tomwym/oreo_mpc/stl/readme.txt

STL files have been simplified using meshlab
    - Using Quadric Edge Collapse Decimation
    - Settings:
        - Auto-generated target number of faces
        - Percent Reduction = 0
        - Quality Threshold = 0.3
        - Preserve Boundary of Mesh = enabled
        - Boundary Preserving Weight = 1.0
        - Preserve Normal = enabled
        - Preserve Topology = enabled
        - Optimal Position of Simplified Vertices = enabled
        - Planar simplification = disabled
        - Weighted simplification = disabled
        - Post-simplification cleaning = enabled
