tomwym/oreo_mpc/model/UW_BOM.xlsx

Sheet: Eye_Sub_ASM
PN | Description | Supplier | Material | Est. Cost (USD) 1 | Est. Cost (USD) 5 | Est. Cost (USD) 10 | QTY. / Package | QTY. Req'd | Order QTY. | Part Cost | CAD File name | Link
XXX | Lens Assembly | B-CON | Assembly | 0 | N/A | N/A | 1 | 1 | 1 | 0 | N/A | N/A
4262T5 | Ultra-Precision Mini Stainless Steel Ball Bearing - ABEC-7, Flanged Double Shielded for 3/32" Shaft Diameter, 5/16" OD | McMaster-Carr | 440C Stainless Steel | 12.76 | N/A | N/A | 1 | 3 | 3 | 38.28 | 4262T500.SLDPRT | http://www.mcmaster.com/#catalog/121/1183/=10p1i0g
90318A101 | Ultra Low Profile Type 316 Stainless Steel Shoulder Screw, Socket Drive, 3/32" Diameter X1/8" Long Shoulder, 2-56 Thread | McMaster-Carr | 316 Stainless Steel | 4.26 | 3.63 | N/A | 1 | 3 | 3 | 12.78 | 90318A101.SLDPRT | http://www.mcmaster.com/#90318a101/=10p1ko5
91294A002 | Class 10.9, M2 Size, 4mm Length, .4mm Pitch, Black Alloy Steel Flat-Head Socket Cap Screw | McMaster-Carr | Black-Oxide | 6.42 | N/A | N/A | 25 | 4 | 1 | 6.42 | 91294A002.SLDPRT | http://www.mcmaster.com/#91294a002/=10p1pz1
91239A758 | Class 10.9 Steel Button-Head Socket Cap Screw, M2.5 Size, 12 mm Length, .45 mm Pitch | McMaster-Carr | Black Oxide | 10.5 | N/A | N/A | 25 | 2 | 1 | 10.5 | 91239A758.SLDPRT | http://www.mcmaster.com/#91239a758/=10p1rd7
91255A075 | Alloy Steel Button-Head Socket Cap Screw, Black-Oxide, 2-56 Thread, 1/16" Long | McMaster-Carr | Black Oxide | 7.25 | N/A | N/A | 25 | 1 | 1 | 7.25 | 91255A075.SLDPRT | http://www.mcmaster.com/#91255a075/=10p1seu
9712K510 | High-Carbon Steel Belleville Disc Spring, .093" ID, .187" OD, .007" Thick | McMaster-Carr | High Carbon Steel | 12.03 | N/A | N/A | 12 | 1 | 1 | 12.03 | 9712K510.SLDPRT | http://www.mcmaster.com/#9712k51/=10p1tbr
99040A210 | Stainless Steel Shim for Shafts, 0.010" Thick, 0.093" ID, 0.203" OD | McMaster-Carr | 18-8 Stainless Steel | 11.29 | N/A | N/A | 25 | 2 | 1 | 11.29 | 99040A210.SLDPRT | http://www.mcmaster.com/#99040a210/=10p1zgw
91239A115 | Class 10.9 Steel Button-Head Socket Cap Screw, M3 Size, 10 mm Length, .5 mm Pitch | McMaster-Carr | Black Oxide | 6.88 | N/A | N/A | 100 | 2 | 1 | 6.88 | 91239A115.SLDPRT | http://www.mcmaster.com/#91239a115/=111uhff
FL3-U3-13S2M-CS | Camera, Flea3 | Point Grey | Assembly | 525 | N/A | N/A | 1 | 0 | 0 | 0 | FL2-006-R0.SLDPRT | https://www.ptgrey.com/flea3-13-mp-mono-usb3-vision-sony-imx035-camera
cam_mount_Al | Camera Mount Aluminum | ProtoLabs | 6061-T6 Aluminum | 468.14 | N/A | N/A | 1 | 0 | 0 | 0 | cam_mount.STEP | https://myaccount.protolabs.com
yoke_Al | Yoke Aluminum | ProtoLabs | 6061-T6 Aluminum | 1293.12 | N/A | N/A | 1 | 0 | 0 | 0 | yoke.STEP | https://myaccount.protolabs.com
cam_mount_SS | Camera Mount Stainless | Shapeways | Printed Stainless Steel | 48.14 | N/A | N/A | 1 | 0 | 0 | 0 | cam_mount.STL | https://www.shapeways.com
cam_mount_Ny | Camera Mount Plastic | Shapeways | Strong and Flexible Black | 13.46 | N/A | N/A | 1 | 0 | 0 | 0 | cam_mount.STL | https://www.shapeways.com
yoke_SS | Yoke Stainless | Shapeways | Printed Stainless Steel | 48.87 | N/A | N/A | 1 | 0 | 0 | 0 | yoke.STL | https://www.shapeways.com
yoke_Ny | Yoke Plastic | Shapeways | Strong and Flexible Black | 9.76 | N/A | N/A | 1 | 0 | 0 | 0 | yoke.STL | https://www.shapeways.com
EM2-1-5000-I | Encoder | US Digital | Plastic | 58.1 | 40.1 | 35.71 | 1 | 1 | 1 | 58.1 | EM1-X-X.SLDPRT | http://www.usdigital.com/products/encoders/incremental/modules/EM2
DISK-1-5000-093-IE | Encoder Disk | US Digital | Mylar | 13.63 | 9.42 | 8.11 | 1 | 2 | 2 | 27.26 | encoder_disk.SLDPRT | http://www.usdigital.com/products/encoders/incremental/rotary/disks/DISK-1
TOTAL |  |  |  |  |  |  |  |  |  | 190.79

Sheet: Frame_Sub_ASM
PN | Description | Supplier | Material | Est. Cost (USD) 1 | Est. Cost (USD) 5 | Est. Cost (USD) 10 | QTY. / Package | QTY. Req'd | Order QTY. | Part Cost | CAD File name | Link
B75AECFD27A3 | Motor | Maxon | Assembly | 318 | N/A | N/A | 1 | 1 | 1 | 318 | maxon_PN_B75AECFD27A3.sldasm | http://www.maxonmotorusa.com/maxon/view/configurator/?ConfigID=B75AECFD27A3
4262T5 | Ultra-Precision Mini Stainless Steel Ball Bearing - ABEC-7, Flanged Double Shielded for 3/32" Shaft Diameter, 5/16" OD | McMaster-Carr | 440C Stainless Steel | 12.76 | N/A | N/A | 1 | 4 | 4 | 51.04 | 4262T500.SLDPRT | http://www.mcmaster.com/#catalog/121/1183/=10p1i0g
90318A102 | Ultra Low Profile Type 316 Stainless Steel Shoulder Screw, Socket Drive, 3/32" Diameter X1/4" Long Shoulder, 2-56 Thread | McMaster-Carr | 316 Stainless Steel | 4.29 | 3.66 | N/A | 1 | 6 | 6 | 25.74 | 90318A102.SLDPRT | http://www.mcmaster.com/#90318a102/=10p2m1d
99040A210 | Stainless Steel Shim for Shafts, 0.010" Thick, 0.093" ID, 0.203" OD | McMaster-Carr | 18-8 Stainless Steel | 11.29 | N/A | N/A | 25 | 10 | 1 | 11.29 | 99040A210.SLDPRT | http://www.mcmaster.com/#99040a210/=10p1zgw
91239A758 | Class 10.9 Steel Button-Head Socket Cap Screw, M2.5 Size, 12 mm Length, .45 mm Pitch | McMaster-Carr | Black Oxide | 10.5 | N/A | N/A | 25 | 6 | 1 | 10.5 | 91239A758.SLDPRT | http://www.mcmaster.com/#91239a758/=10p1rd7
3088A119 | Steel Shim, Round, 0.001" Thick, 1/4" ID, 3/8" OD | McMaster-Carr | Steel | 5.22 | N/A | N/A | 10 | 4 | 1 | 5.22 | N/A | http://www.mcmaster.com/#3088a119/=10p39ua
3088A229 | Steel Shim, Round, 0.005" Thick, 1/4" ID, 3/8" OD | McMaster-Carr | Steel | 3.66 | N/A | N/A | 10 | 1 | 1 | 3.66 | N/A | http://www.mcmaster.com/#3088a229/=10p394m
4262T36 | Premium Flanged Ball Bearing, Double Shielded, Trade No.FR188-2Z | McMaster-Carr | 440C Stainless Steel | 10.47 | N/A | N/A | 1 | 3 | 3 | 31.41 | 4262T36.SLDPRT | http://www.mcmaster.com/#4262t36/=113ctkg
90337A197 | Low Profile 18-8 Stainless Steel Shoulder Screw, Socket Drive, 1/4" Diameter X5/8" Long Shoulder, 10-32 Thread | McMaster-Carr | 18-8 Stainless | 10.47 | 8.88 | N/A | 1 | 3 | 3 | 31.41 | 90337A197.SLDPRT | http://www.mcmaster.com/#90337a197/=10p3d4d
91294A005 | Black Alloy Steel Flat-Head Socket Cap Screw, Class 10.9, M2 Size, 8mm Length, .4mm Pitch | McMaster-Carr | Black Oxide | 6.45 | N/A | N/A | 25 | 30 | 2 | 12.9 | 91294A005.SLDPRT | http://www.mcmaster.com/#91294a005/=10p4dr9
91294A006 | Black Alloy Steel Flat-Head Socket Cap Screw, Class 10.9, M2 Size, 10mm Length, .4mm Pitch | McMaster-Carr | Black Oxide | 6.65 | N/A | N/A | 25 | 3 | 1 | 6.65 | 91294A006.SLDPRT | http://www.mcmaster.com/#91294a006/=10p4368
93657A005 | Metric Nylon Unthreaded Spacer 6mm OD, 4mm Length, M3 Screw Size | McMaster-Carr | Nylon | 1.06 | N/A | 0.89 | 1 | 8 | 8 | 8.48 | 93657A005.SLDPRT | http://www.mcmaster.com/#93657a005/=10qlcg0
91294A132 | Black Alloy Steel Flat-Head Socket Cap Screw, Class 10.9, M3 Size, 12mm Length, .50 Pitch | McMaster-Carr | Black Oxide | 5.38 | N/A | N/A | 100 | 4 | 1 | 5.38 | 91294A132.SLDPRT | http://www.mcmaster.com/#91294a132/=111u497
91292A265 | Type 18-8 Stainless Steel Socket Head Cap Screw, M1.6 Thread, 10mm Long, 0.35mm Pitch | McMaster-Carr | 18-8 Stainless | 9.78 | N/A | N/A | 50 | 16 | 1 | 9.78 | 91292A265.SLDPRT | http://www.mcmaster.com/#91292a265/=111u6c4
91239A115 | lass 10.9 Steel Button-Head Socket Cap Screw, M3 Size, 10 mm Length, .5 mm Pitc | McMaster-Carr | Black Oxide | 6.88 | N/A | N/A | 100 | 4 | 1 | 6.88 | 91239A115.SLDPRT | http://www.mcmaster.com/#91239a115/=111uhff
95893A550 | Thread-Forming Torx Screw for Plastics, Flat Head, 18-8 Stainless Steel, 2-28 Thread, 1/4" Length | McMaster-Carr | 18-8 Stainless | 12.24 | N/A | N/A | 50 | 30 | 1 | 12.24 | 95893A550.SLDPRT | http://www.mcmaster.com/#95893a550/=111u4qr
LM 1247–060–11 | Linear Actuator | MicroMo | Assembly | 539.3 | N/A | N/A | 1 | 6 | 6 | 3235.8 | LM1247-060-XX.SLDASM | http://www.micromo.com/products/linear-motors/quickshaft-data-sheets
Motor Mount Inside_AL | Motor Mount Inside | protolabs | 6061-T6 Aluminum | 291.5 | N/A | N/A | 1 | 0 | 0 | 0 | motor_mount_inside.STEP | https://myaccount.protolabs.com
Yaw Bottom Bearing Mount_AL | Yaw Bottom Bearing Mount | protolabs | 6061-T6 Aluminum | 187.81 | N/A | N/A | 1 | 0 | 0 | 0 | yaw_bearing_mount_bottom.STEP | https://myaccount.protolabs.com
Yaw Top Bearing Mount_AL | Yaw Top Bearing Mount | protolabs | 6061-T6 Aluminum | 175.12 | N/A | N/A | 1 | 0 | 0 | 0 | yaw_bearing_mount_top.STEP | https://myaccount.protolabs.com
Roll Motor Mount_AL | Roll Motor Mount | protolabs | 6061-T6 Aluminum | 189.09 | N/A | N/A | 1 | 0 | 0 | 0 | roll_motor_mount.STEP | https://myaccount.protolabs.com
Roll Bearing Mount_AL | Roll Bearing Mount | protolabs | 6061-T6 Aluminum | 429.5 | N/A | N/A | 1 | 0 | 0 | 0 | roll_bearing_mount.STEP | https://myaccount.protolabs.com
frame_plate_side_l | frame_plate_side_l | ProtoLabs | 7075-T651 Aluminum | 150.04 | 123.13 | 111.41 | 1 | 1 | 1 | 150.04 | frame_plate_side_l.STEP | https://myaccount.protolabs.com
frame_plate_side_r | frame_plate_side_r | ProtoLabs | 7075-T651 Aluminum | 150.04 | 123.13 | 111.41 | 1 | 1 | 1 | 150.04 | frame_plate_side_r.STEP | https://myaccount.protolabs.com
frame_plate_top | frame_plate_top | ProtoLabs | 7075-T651 Aluminum | 160.02 | 133.1 | 121.38 | 1 | 1 | 1 | 160.02 | frame_plate_top.STEP | https://myaccount.protolabs.com
Motor Mount Inside_SS | Motor Mount Inside | Shapeways | Printed Stainless Steel | 51.92 | N/A | N/A | 1 | 0 | 0 | 0 | motor_mount_inside.STL | https://www.shapeways.com
Motor Mount Inside_NY | Motor Mount Inside | Shapeways | Strong and Flexible Black | 8.88 | N/A | N/A | 1 | 0 | 0 | 0 | motor_mount_inside.STL | https://www.shapeways.com
Yaw Bottom Bearing Mount_SS | Yaw Bottom Bearing Mount | Shapeways | Printed Stainless Steel | 73.84 | N/A | N/A | 1 | 0 | 0 | 0 | yaw_bearing_mount_bottom.STL | https://www.shapeways.com
Yaw Bottom Bearing Mount_NY | Yaw Bottom Bearing Mount | Shapeways | Strong and Flexible Black | 11.06 | N/A | N/A | 1 | 0 | 0 | 0 | yaw_bearing_mount_bottom.STL | https://www.shapeways.com
Yaw Top Bearing Mount_SS | Yaw Top Bearing Mount | Shapeways | Printed Stainless Steel | 87.83 | N/A | N/A | 1 | 0 | 0 | 0 | yaw_bearing_mount_top.STL | https://www.shapeways.com
Yaw Top Bearing Mount_NY | Yaw Top Bearing Mount | Shapeways | Strong and Flexible Black | 13.25 | N/A | N/A | 1 | 0 | 0 | 0 | yaw_bearing_mount_top.STL | https://www.shapeways.com
Roll Motor Mount_SS | Roll Motor Mount | Shapeways | Printed Stainless Steel | 89.08 | N/A | N/A | 1 | 0 | 0 | 0 | roll_motor_mount.STL | https://www.shapeways.com
Roll Motor Mount_NY | Roll Motor Mount | Shapeways | Strong and Flexible Black | 13.66 | N/A | N/A | 1 | 0 | 0 | 0 | roll_motor_mount.STL | https://www.shapeways.com
Roll Bearing Mount_SS | Roll Bearing Mount | Shapeways | Printed Stainless Steel | 123.93 | N/A | N/A | 1 | 0 | 0 | 0 | roll_bearing_mount.STL | https://www.shapeways.com
Roll Bearing Mount_NY | Roll Bearing Mount | Shapeways | Strong and Flexible Black | 17.39 | N/A | N/A | 1 | 0 | 0 | 0 | roll_bearing_mount.STL | https://www.shapeways.com
Dogbone Link_NY | Dogbone Link | Shapeways | Strong and Flexible Black | 3.37 | N/A | N/A | 1 | 0 | 0 | 0 | dogbone_link.STL | https://www.shapeways.com
Dogbone Link_SS | Dogbone Link | Shapeways | Stainless Steel | 11.16 | N/A | N/A | 1 | 0 | 0 | 0 | dogbone_link.STL | https://www.shapeways.com
LM1247 Spacer_NY | LM1247 Spacer | Shapeways | Strong and Flexible Black | 5.86 | N/A | N/A | 1 | 0 | 0 | 0 | lm1247_spacer.STL | https://www.shapeways.com
LM1247 Spacer_SS | LM1247 Spacer | Shapeways | Stainless Steel | 25.9 | N/A | N/A | 1 | 0 | 0 | 0 | lm1247_spacer.STL | https://www.shapeways.com
P028.002.E894 | iPOS360x SX Multi-axis Motion System | Technosoft Motion | iPOS360x MBX-NET | 200 | ~ |  | 1 | 1 | 1 | 200 | iPOS360xMulti.SLDPRT | http://www.technosoftmotion.com/en/intelligent-drives-and-motors/ipos-line/ipos-multi-axis/ipos360x-sx
P028.001.E001 | iPOS3602 VX Intelligent Drive (75 W, CANopen / EtherCAT) | Technosoft Motion | iPOS3602 VX-CAN | 300 | ~ |  | 1 | 6 | 6 | 1800 | iPOS360xMulti.SLDPRT | http://www.technosoftmotion.com/en/intelligent-drives-and-motors/ipos-line/ipos3602/ipos3602-vx
P038.022.E001 | Ethernet-CAN Adapter | Technosoft Motion | ENET-VX Ethernet plug-in interface | 75 | not sure of this price |  | 1 | 1 | 1 | 75 | iPOS360xMulti.SLDPRT | http://www.technosoftmotion.com/en/starter-kits-and-accessories/ethernet-can-adapter#description
EM2-1-5000-I | Encoder | US Digital | Mylar | 58.1 | 40.1 | 35.71 | 1 | 3 | 3 | 174.3 | EM1-X-X.SLDPRT | http://www.usdigital.com/products/encoders/incremental/modules/EM2
DISK-1-5000-093-IE | Encoder Disk | US Digital | Mylar | 13.63 | 9.42 | 8.11 | 1 | 2 | 2 | 27.26 | encoder_disk.SLDPRT | http://www.usdigital.com/products/encoders/incremental/rotary/disks/DISK-1
HUBDISK-1-5000-250-IE | Encoder Disk, 5000 CPR, Index, 1/4" Hub | US Digital | Mylar | 20.53 | 14.16 | 10.81 | 1 | 1 | 1 | 20.53 | HUBDISK-1-5000-250-IE.SLDPRT | http://www.usdigital.com/products/encoders/incremental/rotary/disks/HUBDISK-1
TOTAL |  |  |  |  |  |  |  |  |  | 6543.57

Sheet: Neck_Sub_ASM
PN | Description | Supplier | Material | Est. Cost (USD) 1 | Est. Cost (USD) 5 | Est. Cost (USD) 10 | QTY. / Package | QTY. Req'd | Order QTY. | Part Cost | CAD File name | Link
B75AECFD27A3 | Motor | Maxon | Assembly | 318 | N/A | N/A | 1 | 2 | 2 | 636 | maxon_PN_B75AECFD27A3.sldasm | http://www.maxonmotorusa.com/maxon/view/configurator/?ConfigID=B75AECFD27A3
91239A758 | Class 10.9 Steel Button-Head Socket Cap Screw, M2.5 Size, 12 mm Length, .45 mm Pitch | McMaster-Carr | Black Oxide | 10.5 | N/A | N/A | 25 | 10 | 1 | 10.5 | 91239A758.SLDPRT | http://www.mcmaster.com/#91239a758/=10p1rd7
4262T36 | Premium Flanged Ball Bearing, Double Shielded, Trade No.FR188-2Z | McMaster-Carr | 440C Stainless Steel | 10.47 | N/A | N/A | 1 | 3 | 3 | 31.41 | 4262T36.SLDPRT | http://www.mcmaster.com/#4262t36/=113ctkg
90337A197 | Low Profile 18-8 Stainless Steel Shoulder Screw, Socket Drive, 1/4" Diameter X5/8" Long Shoulder, 10-32 Thread | McMaster-Carr | 18-8 Stainless | 10.47 | 8.88 | N/A | 1 | 2 | 2 | 20.94 | 90337A197.SLDPRT | http://www.mcmaster.com/#90337a197/=10p3d4d
9520T270 | Two-Piece Clamp-on Shaft Collar for 3 mm Diameter, Aluminum | McMaster-Carr | Aluminum | 7.71 | N/A | N/A | 1 | 1 | 1 | 7.71 | 9520T270.SLDPRT | http://www.mcmaster.com/#9520t27/=10p5h4m
91385A201 | Thread-Locking Cup Point Set Screw, Alloy Steel, M2 Size, 3mm Long, 0.4mm Pitch | McMaster-Carr | Black Oxide | 12.23 | N/A | N/A | 10 | 2 | 1 | 12.23 | 91385A201.SLDPRT | http://www.mcmaster.com/#91385a201/=10p5ipp
91294A003 | Black Alloy Steel Flat-Head Socket Cap Screw, Class 10.9, M2 Size, 5mm Length, .4mm Pitch | McMaster-Carr | Black Oxide | 6.24 | N/A | N/A | 25 | 12 | 1 | 6.24 | 91294A003.SLDPRT | http://www.mcmaster.com/#91294a003/=10p5k73
6680K11 | Dual-Load Angular-Contact Steel Ball Bearing, Open, 10mm Shaft Diameter, 30mm Outside Diamete | McMaster-Carr | 52100 Steel | 30.09 | N/A | N/A | 1 | 2 | 2 | 60.18 | 6680K110.SLDPRT | http://www.mcmaster.com/#6680k11/=10qk24x
3088A124 | Steel Shim Round, 0.001" Thick, 3/4" ID, 1-1/8" OD | McMaster-Carr | 1008-1010 Steel | 6.36 | N/A | N/A | 10 | 1 | 1 | 6.36 | 3088A124.SLDPRT | http://www.mcmaster.com/#3088a124/=10qk6ci
94805A217 | 3/8"-24 Thread Size, 9/16" Wide, 7/32" High, Thin Hex Nut | McMaster-Carr | 316 Stainless Steel | 7.62 | N/A | N/A | 25 | 1 | 1 | 7.62 | 94805A217.SLDPRT | http://www.mcmaster.com/#94805a217/=10qk7p0
97648A420 | Press-in Nut for Sheet Metal M4 X 0.7 Thread Size | McMaster-Carr | 18-8 Stainless | 8.15 | N/A | N/A | 10 | 4 | 1 | 8.15 | 97648A420.SLDPRT | http://www.mcmaster.com/#97648a420/=10qlboa
93657A005 | Metric Nylon Unthreaded Spacer 6mm OD, 4mm Length, M3 Screw Size | McMaster-Carr | Nylon | 1.06 | N/A | 0.89 | 1 | 4 | 4 | 4.24 | 93657A005.SLDPRT | http://www.mcmaster.com/#93657a005/=10qlcg0
91239A144 | Class 10.9 STL Button-Head Socket Cap Screw M4 Size, 10 mm Length, .7 mm Pitch | McMaster-Carr | Black Oxide | 9.47 | N/A | N/A | 100 | 11 | 1 | 9.47 | 91239A144.SLDPRT | http://www.mcmaster.com/#91239a144/=10qld2f
94150A325 | Type 316 Stainless Steel Hex Nut M3X0.5 Thread Size, 5.5mm Wide, 2.4mm High | McMaster-Carr | 316 Stainless Steel | 3.08 | N/A | N/A | 50 | 4 | 1 | 3.08 | 94150A325.SLDPRT | http://www.mcmaster.com/#94150a325/=10qle1w
91294A134 | Flat-Head Socket Cap Screw Class 10.9, M3 Size, 16mm Length, .50mm Pitch | McMaster-Carr | Black Oxide | 7.95 | N/A | N/A | 100 | 4 | 1 | 7.95 | 91294A134.SLDPRT | http://www.mcmaster.com/#91294a134/=10qleyx
motor_mount_AL | motor_mount | protolabs | 6061-T6 Aluminum | 212.21 | N/A | N/A | 1 | 0 | 0 | 0 | motor_mount.STEP | https://myaccount.protolabs.com
pitch_body_AL | pitch_body | protolabs | 6061-T6 Aluminum | 270.15 | N/A | N/A | 1 | 0 | 0 | 0 | pitch_body.STEP | https://myaccount.protolabs.com
pitch_stop_AL | pitch_stop | protolabs | 6061-T6 Aluminum | 88.96 | N/A | N/A | 1 | 0 | 0 | 0 | pitch_stop.STEP | https://myaccount.protolabs.com
yaw_link_AL | yaw_link | protolabs | 6061-T6 Aluminum | 692.82 | N/A | N/A | 1 | 0 | 0 | 0 | yaw_link.STEP | https://myaccount.protolabs.com
yaw_shaft_AL | yaw_shaft | protolabs | 7075 Aluminum | 105.46 | N/A | N/A | 1 | 0 | 0 | 0 | yaw_shaft.STEP | https://myaccount.protolabs.com
motor_mount_SS |  | Shapeways | Printed Stainless Steel | 181.52 | N/A | N/A | 1 | 0 | 0 | 0 | motor_mount.STL | https://www.shapeways.com
motor_mount_NY |  | Shapeways | Strong and Flexible Black | 25.8 | N/A | N/A | 1 | 0 | 0 | 0 | motor_mount.STL | https://www.shapeways.com
pitch_body_SS |  | Shapeways | Printed Stainless Steel | 72.99 | N/A | N/A | 1 | 0 | 0 | 0 | pitch_body.STL | https://www.shapeways.com
pitch_body_NY |  | Shapeways | Strong and Flexible Black | 13.54 | N/A | N/A | 1 | 0 | 0 | 0 | pitch_body.STL | https://www.shapeways.com
pitch_stop_SS |  | Shapeways | Printed Stainless Steel | 12.88 | N/A | N/A | 1 | 0 | 0 | 0 | pitch_stop.STL | https://www.shapeways.com
pitch_stop_NY |  | Shapeways | Strong and Flexible Black | 3.41 | N/A | N/A | 1 | 0 | 0 | 0 | pitch_stop.STL | https://www.shapeways.com
yaw_link_SS |  | Shapeways | Printed Stainless Steel | 210.86 | N/A | N/A | 1 | 0 | 0 | 0 | yaw_link.STL | https://www.shapeways.com
yaw_link_NY |  | Shapeways | Strong and Flexible Black | 26.37 | N/A | N/A | 1 | 0 | 0 | 0 | yaw_link.STL | https://www.shapeways.com
yaw_shaft_SS |  | Shapeways | Printed Stainless Steel | 31.72 | N/A | N/A | 1 | 0 | 0 | 0 | yaw_shaft.STL | https://www.shapeways.com
yaw_shaft_NY |  | Shapeways | Strong and Flexible Black | 5.85 | N/A | N/A | 1 | 0 | 0 | 0 | yaw_shaft.STL | https://www.shapeways.com
P028.002.E894 | iPOS360x SX Multi-axis Motion System | Technosoft Motion | iPOS360x MBX-NET rev C | 200 | ~ |  | 1 | 1 | 1 | 200 | iPOS360xMulti.SLDPRT | http://www.technosoftmotion.com/en/intelligent-drives-and-motors/ipos-line/ipos-multi-axis/ipos360x-sx
P028.001.E001 | iPOS3602 VX Intelligent Drive (75 W, CANopen / EtherCAT) | Technosoft Motion | iPOS3602 VX-CAN | 300 | ~ |  | 1 | 3 | 3 | 900 | iPOS360xMulti.SLDPRT | http://www.technosoftmotion.com/en/intelligent-drives-and-motors/ipos-line/ipos3602/ipos3602-vx
P038.022.E001 | Ethernet-CAN Adapter | Technosoft Motion | ENET-VX Ethernet plug-in interface | 75 | not sure of this price |  | 1 | 1 | 1 | 75 | iPOS360xMulti.SLDPRT | http://www.technosoftmotion.com/en/starter-kits-and-accessories/ethernet-can-adapter#description
EM2-1-5000-I | Encoder | US Digital | Mylar | 58.1 | 40.1 | 35.71 | 1 | 3 | 3 | 174.3 | EM1-X-X.SLDPRT | http://www.usdigital.com/products/encoders/incremental/modules/EM2
HUBDISK-1-5000-250-IE | Encoder Disk, 5000 CPR, Index, 1/4" Hub | US Digital | Mylar | 20.53 | 14.16 | 10.81 | 1 | 2 | 2 | 41.06 | HUBDISK-1-5000-250-IE.SLDPRT | http://www.usdigital.com/products/encoders/incremental/rotary/disks/HUBDISK-1
HUBDISK-1-5000-313-IE | Encoder Disk, 5000 CPR, Index, 5/16" Hub | US Digital | Mylar | 20.53 | 14.16 | 10.81 | 1 | 1 | 1 | 20.53 | HUBDISK-1-5000-313-IE.SLDPRT | http://www.usdigital.com/products/encoders/incremental/rotary/disks/DISK-1
TOTAL |  |  |  |  |  |  |  |  |  | 2242.97
Parts to add
Neck Base
Vesa Mount

Sheet: Dogbone_ASM
PN | Description | Supplier | Material | Est. Cost (USD) 1 | Est. Cost (USD) 5 | Est. Cost (USD) 10 | QTY. / Package | QTY. Req'd | Order QTY. | Part Cost | CAD File name | Link
017000318-0 | Ball Joint Spacers | Hobby King | Brass | 0.8 | N/A | N/A | 10 | 16 | 2 | 1.6 | N/A | http://www.hobbyking.com/hobbyking/store/__43259__Ball_Joint_Spacers_2mm_10pc.html
OR023-00501 | Ball and roller link 4.8x2x18mm (10pcs/set) | Hobby King | Brass | 3.82 | N/A | N/A | 10 | 8 | 1 | 3.82 | N/A | http://www.hobbyking.com/hobbyking/store/__8855__Ball_and_roller_link_4_8x2x18mm_10pcs_set_.html
T1330A | Curved Ball Link Pliers 5mm | Hobby King | Tool | 6.9 | N/A | N/A | 1 | 1 | 1 | 6.9 | N/A | http://www.hobbyking.com/hobbyking/store/__9801__Curved_Ball_Link_Pliers_5mm.html
450000351-0 | M2x45mm Stainless Steel Push Rods (LH & RH Threaded) (10pcs) | Hobby King | Stainless Steel | 3.36 | N/A | N/A | 10 | 4 | 1 | 3.36 | N/A | http://www.hobbyking.com/hobbyking/store/__61886__M2x45mm_Stainless_Steel_Push_Rods_LH_RH_Threaded_10pcs_.html
450000352-0 | M2x55mm Stainless Steel Push Rods (LH & RH Threaded) (10pcs) | Hobby King | Stainless Steel | 3.99 | N/A | N/A | 10 | 4 | 1 | 3.99 | N/A | http://www.hobbyking.com/hobbyking/store/__61887__M2x55mm_Stainless_Steel_Push_Rods_LH_RH_Threaded_10pcs_.html
RJX23 | M3 Steel Linkage Ball for all helis (10pcs) | Hobby King | Steel | 3.49 | N/A | N/A | 10 | 8 | 1 | 3.49 | N/A | http://www.hobbyking.com/hobbyking/store/__12301__M3_Steel_Linkage_Ball_for_all_helis_10pcs_.html
388000043 | 4.8mm x 15mm Ball End | Hobby King | Plastic | 1.93 | N/A | N/A | 10 | 4 | 1 | 1.93 | N/A | http://www.hobbyking.com/hobbyking/store/__26699__4_8mm_x_15mm_Ball_End_Turnigy_TD10_4WD_Touring_Car_10pc_.html
V2_5090-1612 | TZ-V2 .50 & .90 Size Ball Link | Hobby King | Plastic | 2.32 | N/A | N/A | 10 | 4 | 1 | 2.32 | N/A | http://www.hobbyking.com/hobbyking/store/__10524__TZ_V2_50_90_Size_Ball_Link.html
17000198-0 | M3 x 45mm Steel Push Rod (10pc) | Hobby King | Steel | 2.91 | N/A | N/A | 10 | 4 | 1 | 2.91 | N/A | http://www.hobbyking.com/hobbyking/store/RC_PRODUCT_SEARCH.asp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
E4005 | E4005 Servo Ball Head Pack for Firefox (4pcs/set) | Hobby King | Steel | 1.49 | N/A | N/A | 4 | 4 | 1 | 1.49 | N/A | http://www.hobbyking.com/hobbyking/store/__9248__E4005_Servo_Ball_Head_Pack_for_Firefox_4pcs_set_.html
110BS-30810 | Ball Stud (M2*S Dia4)(10Pcs/Bag) - 110BS, 118B, A2023T, A2027, A2028, A2029, A2035, A2040 and A3011 | Hobby King | Steel | 2.09 | N/A | N/A | 10 | 4 | 1 | 2.09 | N/A | http://www.hobbyking.com/hobbyking/store/__14138__Ball_Stud_M2_S_Dia4_10Pcs_Bag_110BS_118B_A2023T_A2027_A2028_A2029_A2035_A2040_and_A3011.html
TOTAL |  |  |  |  |  |  |  |  |  | 33.9
dogbone link
Other Possible Vendors
http://www.traxxas.com
http://shop.dubro.com/c/aircraft_ball-links
http://www.helidirect.com
http://www3.towerhobbies.com
http://www.helidirect.com

Sheet: Cables&Connectors
PN | Description | Supplier | Material | Est. Cost (USD) 1 | Est. Cost (USD) 5 | Est. Cost (USD) 10 | QTY. / Package | QTY. Req'd | Order QTY. | Part Cost | CAD File name | Link
69845K62 | Steel Adhesive Back Cable Holder, Flexible Strap, for 5/16" Bundle Diameter, packs of 25 | McMaster-Carr | Steel | 12.63 | N/A | N/A | 25 | 25 | 1 | 12.63 | N/A | http://www.mcmaster.com/#69845k62/=1121qc3
1810A27 | Loctite® 222 Threadlocker, 0.34 oz. Bottle | McMaster-Carr | Loctite Purple | 13.65 | N/A | N/A | 1 | 1 | 1 | 13.65 | N/A | http://www.mcmaster.com/#1810a27/=113d0tu
653-A22E-M-02 | Pushbutton Switches DPST-NC 40mm HEAD Push-lock turn-reset | Mouser | Assembly | 44.44 | N/A | 42.43 | 1 | 1 | 1 | 44.44 | N/A | http://www.mouser.com/Search/ProductDetail.aspx?R=A22E-M-02virtualkey65350000virtualkey653-A22E-M-02
565-6733-0 | Hook-up Wire SILICONE LD BLK 50' | Mouser | Silicone | 25.99 | N/A | 24.93 | 50 | 10 | 1 | 25.99 | N/A | http://www.mouser.com/Search/ProductDetail.aspx?R=6733-0virtualkey56520000virtualkey565-6733-0
571-5-103976-4 | Headers & Wire Housings HSG&REC 1X05C STD 28-22 AWG | Mouser | Assembly | 1.63 | N/A | N/A | 1 | 10 | 10 | 16.3 | N/A | http://www.mouser.com/Search/ProductDetail.aspx
108-PMT-24V350W1AK | Switching Power Supplies 24V 350W Enclosed FrontFace PanelMt. | Mouser | Assembly | 56.95 | 55.22 | 53.5 | 1 | 1 | 1 | 56.95 | N/A | http://www.mouser.com/Search/ProductDetail.aspx
538-43030-0001-CT | Headers & Wire Housings MF 3.0 TERM 20-24G F Cut Strip of 100 | Mouser | Phosphor Bronze | 6.9 | N/A | N/A | 100 | 58 | 1 | 6.9 | N/A | http://www.mouser.com/Search/ProductDetail.aspx
538-50394-8051-CT | Headers & Wire Housings CRMP TERM 22-26G F Cut Strip of 100 | Mouser | Phosphor Bronze | 8.3 | N/A | N/A | 100 | 32 | 1 | 8.3 | N/A | http://www.mouser.com/Search/ProductDetail.aspx
538-43025-0400 | Headers & Wire Housings RECEPTACLE 4P DUAL ROW | Mouser | Polyester | 0.39 | N/A | 0.38 | 1 | 6 | 6 | 2.34 | N/A | http://www.mouser.com/Search/ProductDetail.aspx
538-43025-1400 | Headers & Wire Housings RECEPTACLE 14P DUAL ROW | Mouser | Polyester | 0.91 | N/A | 0.721 | 1 | 10 | 10 | 9.1 | N/A | http://www.mouser.com/Search/ProductDetail.aspx
538-43025-1000 | Headers & Wire Housings RECEPTACLE 10P DUAL ROW | Mouser | Polyester | 0.62 | N/A | 0.575 | 1 | 12 | 12 | 7.44 | N/A | http://www.mouser.com/Search/ProductDetail.aspx
538-51110-1056 | Headers & Wire Housings 10CKT 2MM MGRID WTB CONN CRIMP | Mouser | Polyester | 0.27 | N/A | 0.264 | 1 | 10 | 10 | 2.7 | N/A | http://www.mouser.com/Search/ProductDetail.aspx
571-3828118 | Headers & Wire Housings ECONOMY SHUNT ASSY | Mouser | Polyester | 0.1 | N/A | 0.088 | 1 | 10 | 10 | 1 | N/A | http://www.mouser.com/Search/ProductDetail.aspx?R=382811-8virtualkey57100000virtualkey571-3828118
574-W28-6H | Hook-up Wire 28 AWG BLK 100 FT | Mouser | Tefzel | 30.86 | N/A | 28.22 | 100 | 35 | 1 | 30.86 | N/A | http://www.mouser.com/Search/ProductDetail.aspx?R=W28-6Hvirtualkey57400000virtualkey574-W28-6H
644-HSTT12-48-TL | Heat Shrink Tubing and Sleeves H/S Thin .12" Dia Black | Mouser | PO | 1.22 | N/A | 1.16 | 1 | 1 | 1 | 1.22 | N/A | http://www.mouser.com/Search/ProductDetail.aspx
644-HSTTV25-48-Q | Heat Shrink Tubing and Sleeves 48" X 1/4" BLACK | Mouser | PO | 5.28 | 4.69 | 4.09 | 1 | 1 | 1 | 5.28 | N/A | http://www.mouser.com/Search/ProductDetail.aspx
644-HSTTV19-48-Q | Heat Shrink Tubing and Sleeves HeatShrink Thin VW-1 .19"(4.8mm) Dia | Mouser | PO | 2.04 | N/A | N/A | 1 | 1 | 1 | 2.04 | N/A | http://www.mouser.com/Search/ProductDetail.aspx
644-HSTTV06-48-Q | Heat Shrink Tubing and Sleeves H/S Thin VW-1 .06 "(1.6mm) Dia | Mouser | PO | 1.2 | N/A | 1.14 | 1 | 1 | 1 | 1.2 | N/A | http://www.mouser.com/Search/ProductDetail.aspx
US2-AMCBR2I1.5 | USB 3.0 A to Right Angle-2 Micro B with Locking Cable - Black (1.5 m) | ntc distributing |  | 27 | N/A | 26 | 1 | 2 | 2 | 54 | N/A | http://www.ntcdistributing.com/usb-3-0-a-to-right-angle-2-micro-b-with-locking-cable-black-1-5-m/
US2-AMCBR4I1-1.5 | USB 3.0 A to Right Angle-4 Micro B with Lock Cable - Black (1.5 m) | ntc distributing |  | 27 | N/A | 26 | 1 | 2 | 2 | 54 | N/A | http://www.ntcdistributing.com/usb-3-0-a-to-right-angle-4-micro-b-with-lock-cable-black-1-5-m/
TOTAL |  |  |  |  |  |  |  |  |  | 356.34

Sheet: FULL_ASM
ASM Qty. |  |  |  |  |  | Set to 1 to order part qty in specified material
Eye Sub ASM | Frame Sub ASM | Neck Sub ASM | Dogbone Sub ASM | Cables & Connectors |  | Shapeways Nylon | Shapeways SS | Protolabs Al
2 | 1 | 1 | 1 | 1 |  | 1 | 0 | 0
PN | Description | Supplier | Material | Est. Cost (USD) 1 | Est. Cost (USD) 5 | Est. Cost (USD) 10 | QTY. / Package | QTY. Req'd | Order QTY. | Part Cost | CAD File name | Link
XXX | Lens Assembly | B-CON | Assembly | 0 | N/A | N/A | 1 | 2 | 2 | 0 | N/A | N/A
017000318-0 | Ball Joint Spacers | Hobby King | Brass | 0.8 | N/A | N/A | 10 | 16 | 2 | 1.6 | N/A | http://www.hobbyking.com/hobbyking/store/__43259__Ball_Joint_Spacers_2mm_10pc.html
OR023-00501 | Ball and roller link 4.8x2x18mm (10pcs/set) | Hobby King | Brass | 3.82 | N/A | N/A | 10 | 8 | 1 | 3.82 | N/A | http://www.hobbyking.com/hobbyking/store/__8855__Ball_and_roller_link_4_8x2x18mm_10pcs_set_.html
T1330A | Curved Ball Link Pliers 5mm | Hobby King | Tool | 6.9 | N/A | N/A | 1 | 1 | 1 | 6.9 | N/A | http://www.hobbyking.com/hobbyking/store/__9801__Curved_Ball_Link_Pliers_5mm.html
450000351-0 | M2x45mm Stainless Steel Push Rods (LH & RH Threaded) (10pcs) | Hobby King | Stainless Steel | 3.36 | N/A | N/A | 10 | 4 | 1 | 3.36 | N/A | http://www.hobbyking.com/hobbyking/store/__61886__M2x45mm_Stainless_Steel_Push_Rods_LH_RH_Threaded_10pcs_.html
450000352-0 | M2x55mm Stainless Steel Push Rods (LH & RH Threaded) (10pcs) | Hobby King | Stainless Steel | 3.99 | N/A | N/A | 10 | 4 | 1 | 3.99 | N/A | http://www.hobbyking.com/hobbyking/store/__61887__M2x55mm_Stainless_Steel_Push_Rods_LH_RH_Threaded_10pcs_.html
RJX23 | M3 Steel Linkage Ball for all helis (10pcs) | Hobby King | Steel | 3.49 | N/A | N/A | 10 | 8 | 1 | 3.49 | N/A | http://www.hobbyking.com/hobbyking/store/__12301__M3_Steel_Linkage_Ball_for_all_helis_10pcs_.html
388000043 | 4.8mm x 15mm Ball End | Hobby King | Plastic | 1.93 | N/A | N/A | 10 | 4 | 1 | 1.93 | N/A | http://www.hobbyking.com/hobbyking/store/__26699__4_8mm_x_15mm_Ball_End_Turnigy_TD10_4WD_Touring_Car_10pc_.html
V2_5090-1612 | TZ-V2 .50 & .90 Size Ball Link | Hobby King | Plastic | 2.32 | N/A | N/A | 10 | 4 | 1 | 2.32 | N/A | http://www.hobbyking.com/hobbyking/store/__10524__TZ_V2_50_90_Size_Ball_Link.html
17000198-0 | M3 x 45mm Steel Push Rod (10pc) | Hobby King | Steel | 2.91 | N/A | N/A | 10 | 4 | 1 | 2.91 | N/A | http://www.hobbyking.com/hobbyking/store/RC_PRODUCT_SEARCH.asp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
E4005 | E4005 Servo Ball Head Pack for Firefox (4pcs/set) | Hobby King | Steel | 1.49 | N/A | N/A | 4 | 4 | 1 | 1.49 | N/A | http://www.hobbyking.com/hobbyking/store/__9248__E4005_Servo_Ball_Head_Pack_for_Firefox_4pcs_set_.html
110BS-30810 | Ball Stud (M2*S Dia4)(10Pcs/Bag) - 110BS, 118B, A2023T, A2027, A2028, A2029, A2035, A2040 and A3011 | Hobby King | Steel | 2.09 | N/A | N/A | 10 | 4 | 1 | 2.09 | N/A | http://www.hobbyking.com/hobbyking/store/__14138__Ball_Stud_M2_S_Dia4_10Pcs_Bag_110BS_118B_A2023T_A2027_A2028_A2029_A2035_A2040_and_A3011.html
B75AECFD27A3 | Motor | Maxon | Assembly | 318 | N/A | N/A | 1 | 3 | 3 | 954 | maxon_PN_B75AECFD27A3.sldasm | http://www.maxonmotorusa.com/maxon/view/configurator/?ConfigID=B75AECFD27A3
4262T5 | Ultra-Precision Mini Stainless Steel Ball Bearing - ABEC-7, Flanged Double Shielded for 3/32" Shaft Diameter, 5/16" OD | McMaster-Carr | 440C Stainless Steel | 12.76 | N/A | N/A | 1 | 10 | 10 | 127.6 | 4262T500.SLDPRT | http://www.mcmaster.com/#catalog/121/1183/=10p1i0g
90318A101 | Ultra Low Profile Type 316 Stainless Steel Shoulder Screw, Socket Drive, 3/32" Diameter X1/8" Long Shoulder, 2-56 Thread | McMaster-Carr | 316 Stainless Steel | 4.26 | 3.63 | N/A | 1 | 6 | 6 | 21.78 | 90318A101.SLDPRT | http://www.mcmaster.com/#90318a101/=10p1ko5
91294A002 | Class 10.9, M2 Size, 4mm Length, .4mm Pitch, Black Alloy Steel Flat-Head Socket Cap Screw | McMaster-Carr | Black-Oxide | 6.42 | N/A | N/A | 25 | 8 | 1 | 6.42 | 91294A002.SLDPRT | http://www.mcmaster.com/#91294a002/=10p1pz1
91239A758 | Class 10.9 Steel Button-Head Socket Cap Screw, M2.5 Size, 12 mm Length, .45 mm Pitch | McMaster-Carr | Black Oxide | 10.5 | N/A | N/A | 25 | 20 | 1 | 10.5 | 91239A758.SLDPRT | http://www.mcmaster.com/#91239a758/=10p1rd7
91255A075 | Alloy Steel Button-Head Socket Cap Screw, Black-Oxide, 2-56 Thread, 1/16" Long | McMaster-Carr | Black Oxide | 7.25 | N/A | N/A | 25 | 2 | 1 | 7.25 | 91255A075.SLDPRT | http://www.mcmaster.com/#91255a075/=10p1seu
9712K510 | High-Carbon Steel Belleville Disc Spring, .093" ID, .187" OD, .007" Thick | McMaster-Carr | High Carbon Steel | 12.03 | N/A | N/A | 12 | 2 | 1 | 12.03 | 9712K510.SLDPRT | http://www.mcmaster.com/#9712k51/=10p1tbr
99040A210 | Stainless Steel Shim for Shafts, 0.010" Thick, 0.093" ID, 0.203" OD | McMaster-Carr | 18-8 Stainless Steel | 11.29 | N/A | N/A | 25 | 14 | 1 | 11.29 | 99040A210.SLDPRT | http://www.mcmaster.com/#99040a210/=10p1zgw
91239A115 | Class 10.9 Steel Button-Head Socket Cap Screw, M3 Size, 10 mm Length, .5 mm Pitch | McMaster-Carr | Black Oxide | 6.88 | N/A | N/A | 100 | 8 | 1 | 6.88 | 91239A115.SLDPRT | http://www.mcmaster.com/#91239a115/=111uhff
90318A102 | Ultra Low Profile Type 316 Stainless Steel Shoulder Screw, Socket Drive, 3/32" Diameter X1/4" Long Shoulder, 2-56 Thread | McMaster-Carr | 316 Stainless Steel | 4.29 | 3.66 | N/A | 1 | 6 | 6 | 21.96 | 90318A102.SLDPRT | http://www.mcmaster.com/#90318a102/=10p2m1d
3088A119 | Steel Shim, Round, 0.001" Thick, 1/4" ID, 3/8" OD | McMaster-Carr | Steel | 5.22 | N/A | N/A | 10 | 4 | 1 | 5.22 | N/A | http://www.mcmaster.com/#3088a119/=10p39ua
3088A229 | Steel Shim, Round, 0.005" Thick, 1/4" ID, 3/8" OD | McMaster-Carr | Steel | 3.66 | N/A | N/A | 10 | 1 | 1 | 3.66 | N/A | http://www.mcmaster.com/#3088a229/=10p394m
4262T36 | Premium Flanged Ball Bearing, Double Shielded, Trade No.FR188-2Z | McMaster-Carr | 440C Stainless Steel | 10.47 | N/A | N/A | 1 | 6 | 6 | 62.82 | 4262T36.SLDPRT | http://www.mcmaster.com/#4262t36/=113ctkg
90337A197 | Low Profile 18-8 Stainless Steel Shoulder Screw, Socket Drive, 1/4" Diameter X5/8" Long Shoulder, 10-32 Thread | McMaster-Carr | 18-8 Stainless | 10.47 | 8.88 | N/A | 1 | 5 | 5 | 44.4 | 90337A197.SLDPRT | http://www.mcmaster.com/#90337a197/=10p3d4d
91294A005 | Black Alloy Steel Flat-Head Socket Cap Screw, Class 10.9, M2 Size, 8mm Length, .4mm Pitch | McMaster-Carr | Black Oxide | 6.45 | N/A | N/A | 25 | 30 | 2 | 12.9 | 91294A005.SLDPRT | http://www.mcmaster.com/#91294a005/=10p4dr9
91294A006 | Black Alloy Steel Flat-Head Socket Cap Screw, Class 10.9, M2 Size, 10mm Length, .4mm Pitch | McMaster-Carr | Black Oxide | 6.65 | N/A | N/A | 25 | 3 | 1 | 6.65 | 91294A006.SLDPRT | http://www.mcmaster.com/#91294a006/=10p4368
91294A132 | Black Alloy Steel Flat-Head Socket Cap Screw, Class 10.9, M3 Size, 12mm Length, .50 Pitch | McMaster-Carr | Black Oxide | 5.38 | N/A | N/A | 100 | 4 | 1 | 5.38 | 91294A132.SLDPRT | http://www.mcmaster.com/#91294a132/=111u497
91292A265 | Type 18-8 Stainless Steel Socket Head Cap Screw, M1.6 Thread, 10mm Long, 0.35mm Pitch | McMaster-Carr | 18-8 Stainless | 9.78 | N/A | N/A | 50 | 16 | 1 | 9.78 | 91292A265.SLDPRT | http://www.mcmaster.com/#91292a265/=111u6c4
95893A550 | Thread-Forming Torx Screw for Plastics, Flat Head, 18-8 Stainless Steel, 2-28 Thread, 1/4" Length | McMaster-Carr | 18-8 Stainless | 12.24 | N/A | N/A | 50 | 30 | 1 | 12.24 | 95893A550.SLDPRT | http://www.mcmaster.com/#95893a550/=111u4qr
9520T270 | Two-Piece Clamp-on Shaft Collar for 3 mm Diameter, Aluminum | McMaster-Carr | Aluminum | 7.71 | N/A | N/A | 1 | 1 | 1 | 7.71 | 9520T270.SLDPRT | http://www.mcmaster.com/#9520t27/=10p5h4m
91385A201 | Thread-Locking Cup Point Set Screw, Alloy Steel, M2 Size, 3mm Long, 0.4mm Pitch | McMaster-Carr | Black Oxide | 12.23 | N/A | N/A | 10 | 2 | 1 | 12.23 | 91385A201.SLDPRT | http://www.mcmaster.com/#91385a201/=10p5ipp
91294A003 | Black Alloy Steel Flat-Head Socket Cap Screw, Class 10.9, M2 Size, 5mm Length, .4mm Pitch | McMaster-Carr | Black Oxide | 6.24 | N/A | N/A | 25 | 12 | 1 | 6.24 | 91294A003.SLDPRT | http://www.mcmaster.com/#91294a003/=10p5k73
6680K11 | Dual-Load Angular-Contact Steel Ball Bearing, Open, 10mm Shaft Diameter, 30mm Outside Diamete | McMaster-Carr | 52100 Steel | 30.09 | N/A | N/A | 1 | 2 | 2 | 60.18 | 6680K110.SLDPRT | http://www.mcmaster.com/#6680k11/=10qk24x
3088A124 | Steel Shim Round, 0.001" Thick, 3/4" ID, 1-1/8" OD | McMaster-Carr | 1008-1010 Steel | 6.36 | N/A | N/A | 10 | 1 | 1 | 6.36 | 3088A124.SLDPRT | http://www.mcmaster.com/#3088a124/=10qk6ci
94805A217 | 3/8"-24 Thread Size, 9/16" Wide, 7/32" High, Thin Hex Nut | McMaster-Carr | 316 Stainless Steel | 7.62 | N/A | N/A | 25 | 1 | 1 | 7.62 | 94805A217.SLDPRT | http://www.mcmaster.com/#94805a217/=10qk7p0
97648A420 | Press-in Nut for Sheet Metal M4 X 0.7 Thread Size | McMaster-Carr | 18-8 Stainless | 8.15 | N/A | N/A | 10 | 4 | 1 | 8.15 | 97648A420.SLDPRT | http://www.mcmaster.com/#97648a420/=10qlboa
93657A005 | Metric Nylon Unthreaded Spacer 6mm OD, 4mm Length, M3 Screw Size | McMaster-Carr | Nylon | 1.06 | N/A | 0.89 | 1 | 12 | 12 | 10.68 | 93657A005.SLDPRT | http://www.mcmaster.com/#93657a005/=10qlcg0
91239A144 | Class 10.9 STL Button-Head Socket Cap Screw M4 Size, 10 mm Length, .7 mm Pitch | McMaster-Carr | Black Oxide | 9.47 | N/A | N/A | 100 | 11 | 1 | 9.47 | 91239A144.SLDPRT | http://www.mcmaster.com/#91239a144/=10qld2f
94150A325 | Type 316 Stainless Steel Hex Nut M3X0.5 Thread Size, 5.5mm Wide, 2.4mm High | McMaster-Carr | 316 Stainless Steel | 3.08 | N/A | N/A | 50 | 4 | 1 | 3.08 | 94150A325.SLDPRT | http://www.mcmaster.com/#94150a325/=10qle1w
91294A134 | Flat-Head Socket Cap Screw Class 10.9, M3 Size, 16mm Length, .50mm Pitch | McMaster-Carr | Black Oxide | 7.95 | N/A | N/A | 100 | 4 | 1 | 7.95 | 91294A134.SLDPRT | http://www.mcmaster.com/#91294a134/=10qleyx
69845K62 | Steel Adhesive Back Cable Holder, Flexible Strap, for 5/16" Bundle Diameter, packs of 25 | McMaster-Carr | Steel | 12.63 | N/A | N/A | 25 | 25 | 1 | 12.63 | N/A | http://www.mcmaster.com/#69845k62/=1121qc3
1810A27 | Loctite® 222 Threadlocker, 0.34 oz. Bottle | McMaster-Carr | Loctite Purple | 13.65 | N/A | N/A | 1 | 1 | 1 | 13.65 | N/A | http://www.mcmaster.com/#1810a27/=113d0tu
LM 1247–060–11 | Linear Actuator | MicroMo | Assembly | 539.3 | N/A | N/A | 1 | 6 | 6 | 3235.8 | LM1247-060-XX.SLDASM | http://www.micromo.com/products/linear-motors/quickshaft-data-sheets
653-A22E-M-02 | Pushbutton Switches DPST-NC 40mm HEAD Push-lock turn-reset | Mouser | Assembly | 44.44 | N/A | 42.43 | 1 | 1 | 1 | 44.44 | N/A | http://www.mouser.com/Search/ProductDetail.aspx?R=A22E-M-02virtualkey65350000virtualkey653-A22E-M-02
565-6733-0 | Hook-up Wire SILICONE LD BLK 50' | Mouser | Silicone | 25.99 | N/A | 24.93 | 50 | 10 | 1 | 25.99 | N/A | http://www.mouser.com/Search/ProductDetail.aspx?R=6733-0virtualkey56520000virtualkey565-6733-0
571-5-103976-4 | Headers & Wire Housings HSG&REC 1X05C STD 28-22 AWG | Mouser | Assembly | 1.63 | N/A | N/A | 1 | 10 | 10 | 16.3 | N/A | http://www.mouser.com/Search/ProductDetail.aspx
108-PMT-24V350W1AK | Switching Power Supplies 24V 350W Enclosed FrontFace PanelMt. | Mouser | Assembly | 56.95 | 55.22 | 53.5 | 1 | 1 | 1 | 56.95 | N/A | http://www.mouser.com/Search/ProductDetail.aspx
538-43030-0001-CT | Headers & Wire Housings MF 3.0 TERM 20-24G F Cut Strip of 100 | Mouser | Phosphor Bronze | 6.9 | N/A | N/A | 100 | 58 | 1 | 6.9 | N/A | http://www.mouser.com/Search/ProductDetail.aspx
538-50394-8051-CT | Headers & Wire Housings CRMP TERM 22-26G F Cut Strip of 100 | Mouser | Phosphor Bronze | 8.3 | N/A | N/A | 100 | 32 | 1 | 8.3 | N/A | http://www.mouser.com/Search/ProductDetail.aspx
538-43025-0400 | Headers & Wire Housings RECEPTACLE 4P DUAL ROW | Mouser | Polyester | 0.39 | N/A | 0.38 | 1 | 6 | 6 | 2.34 | N/A | http://www.mouser.com/Search/ProductDetail.aspx
538-43025-1400 | Headers & Wire Housings RECEPTACLE 14P DUAL ROW | Mouser | Polyester | 0.91 | N/A | 0.721 | 1 | 10 | 10 | 7.21 | N/A | http://www.mouser.com/Search/ProductDetail.aspx
538-43025-1000 | Headers & Wire Housings RECEPTACLE 10P DUAL ROW | Mouser | Polyester | 0.62 | N/A | 0.575 | 1 | 12 | 12 | 6.9 | N/A | http://www.mouser.com/Search/ProductDetail.aspx
538-51110-1056 | Headers & Wire Housings 10CKT 2MM MGRID WTB CONN CRIMP | Mouser | Polyester | 0.27 | N/A | 0.264 | 1 | 10 | 10 | 2.64 | N/A | http://www.mouser.com/Search/ProductDetail.aspx
571-3828118 | Headers & Wire Housings ECONOMY SHUNT ASSY | Mouser | Polyester | 0.1 | N/A | 0.088 | 1 | 10 | 10 | 0.88 | N/A | http://www.mouser.com/Search/ProductDetail.aspx?R=382811-8virtualkey57100000virtualkey571-3828118
574-W28-6H | Hook-up Wire 28 AWG BLK 100 FT | Mouser | Tefzel | 30.86 | N/A | 28.22 | 100 | 35 | 1 | 30.86 | N/A | http://www.mouser.com/Search/ProductDetail.aspx?R=W28-6Hvirtualkey57400000virtualkey574-W28-6H
644-HSTT12-48-TL | Heat Shrink Tubing and Sleeves H/S Thin .12" Dia Black | Mouser | PO | 1.22 | N/A | 1.16 | 1 | 1 | 1 | 1.22 | N/A | http://www.mouser.com/Search/ProductDetail.aspx
644-HSTTV25-48-Q | Heat Shrink Tubing and Sleeves 48" X 1/4" BLACK | Mouser | PO | 5.28 | 4.69 | 4.09 | 1 | 1 | 1 | 5.28 | N/A | http://www.mouser.com/Search/ProductDetail.aspx
644-HSTTV19-48-Q | Heat Shrink Tubing and Sleeves HeatShrink Thin VW-1 .19"(4.8mm) Dia | Mouser | PO | 2.04 | N/A | N/A | 1 | 1 | 1 | 2.04 | N/A | http://www.mouser.com/Search/ProductDetail.aspx
644-HSTTV06-48-Q | Heat Shrink Tubing and Sleeves H/S Thin VW-1 .06 "(1.6mm) Dia | Mouser | PO | 1.2 | N/A | 1.14 | 1 | 1 | 1 | 1.2 | N/A | http://www.mouser.com/Search/ProductDetail.aspx
US2-AMCBR2I1.5 | USB 3.0 A to Right Angle-2 Micro B with Locking Cable - Black (1.5 m) | ntc distributing |  | 27 | N/A | 26 | 1 | 2 | 2 | 54 | N/A | http://www.ntcdistributing.com/usb-3-0-a-to-right-angle-2-micro-b-with-locking-cable-black-1-5-m/
US2-AMCBR4I1-1.5 | USB 3.0 A to Right Angle-4 Micro B with Lock Cable - Black (1.5 m) | ntc distributing |  | 27 | N/A | 26 | 1 | 2 | 2 | 54 | N/A | http://www.ntcdistributing.com/usb-3-0-a-to-right-angle-4-micro-b-with-lock-cable-black-1-5-m/
FL3-U3-13S2M-CS | Camera, Flea3 | Point Grey | Assembly | 525 | N/A | N/A | 1 | 0 | 0 | 0 | FL2-006-R0.SLDPRT | https://www.ptgrey.com/flea3-13-mp-mono-usb3-vision-sony-imx035-camera
cam_mount_Al | Camera Mount Aluminum | ProtoLabs | 6061-T6 Aluminum | 468.14 | N/A | N/A | 1 | 0 | 0 | 0 | cam_mount.STEP | https://myaccount.protolabs.com
yoke_Al | Yoke Aluminum | ProtoLabs | 6061-T6 Aluminum | 1293.12 | N/A | N/A | 1 | 0 | 0 | 0 | yoke.STEP | https://myaccount.protolabs.com
Motor Mount Inside_AL | Motor Mount Inside | protolabs | 6061-T6 Aluminum | 291.5 | N/A | N/A | 1 | 0 | 0 | 0 | motor_mount_inside.STEP | https://myaccount.protolabs.com
Yaw Bottom Bearing Mount_AL | Yaw Bottom Bearing Mount | protolabs | 6061-T6 Aluminum | 187.81 | N/A | N/A | 1 | 0 | 0 | 0 | yaw_bearing_mount_bottom.STEP | https://myaccount.protolabs.com
Yaw Top Bearing Mount_AL | Yaw Top Bearing Mount | protolabs | 6061-T6 Aluminum | 175.12 | N/A | N/A | 1 | 0 | 0 | 0 | yaw_bearing_mount_top.STEP | https://myaccount.protolabs.com
Roll Motor Mount_AL | Roll Motor Mount | protolabs | 6061-T6 Aluminum | 189.09 | N/A | N/A | 1 | 0 | 0 | 0 | roll_motor_mount.STEP | https://myaccount.protolabs.com
Roll Bearing Mount_AL | Roll Bearing Mount | protolabs | 6061-T6 Aluminum | 429.5 | N/A | N/A | 1 | 0 | 0 | 0 | roll_bearing_mount.STEP | https://myaccount.protolabs.com
frame_plate_side_l | frame_plate_side_l | ProtoLabs | 6061-T6 Aluminum | 150.04 | 123.13 | 111.41 | 1 | 1 | 1 | 150.04 | frame_plate_side_l.STEP | https://myaccount.protolabs.com
frame_plate_side_r | frame_plate_side_r | ProtoLabs | 6061-T6 Aluminum | 150.04 | 123.13 | 111.41 | 1 | 1 | 1 | 150.04 | frame_plate_side_r.STEP | https://myaccount.protolabs.com
frame_plate_top | frame_plate_top | ProtoLabs | 6061-T6 Aluminum | 160.02 | 133.1 | 121.38 | 1 | 1 | 1 | 160.02 | frame_plate_top.STEP | https://myaccount.protolabs.com
motor_mount_AL | motor_mount | protolabs | 6061-T6 Aluminum | 212.21 | N/A | N/A | 1 | 0 | 0 | 0 | motor_mount.STEP | https://myaccount.protolabs.com
pitch_body_AL | pitch_body | protolabs | 6061-T6 Aluminum | 270.15 | N/A | N/A | 1 | 0 | 0 | 0 | pitch_body.STEP | https://myaccount.protolabs.com
pitch_stop_AL | pitch_stop | protolabs | 6061-T6 Aluminum | 88.96 | N/A | N/A | 1 | 0 | 0 | 0 | pitch_stop.STEP | https://myaccount.protolabs.com
yaw_link_AL | yaw_link | protolabs | 6061-T6 Aluminum | 692.82 | N/A | N/A | 1 | 0 | 0 | 0 | yaw_link.STEP | https://myaccount.protolabs.com
yaw_shaft_AL | yaw_shaft | protolabs | 7075 Aluminum | 105.46 | N/A | N/A | 1 | 0 | 0 | 0 | yaw_shaft.STEP | https://myaccount.protolabs.com
cam_mount_SS | Camera Mount Stainless | Shapeways | Printed Stainless Steel | 48.14 | N/A | N/A | 1 | 0 | 0 | 0 | cam_mount.STL | https://www.shapeways.com
cam_mount_Ny | Camera Mount Plastic | Shapeways | Strong and Flexible Black | 13.46 | N/A | N/A | 1 | 0 | 0 | 0 | cam_mount.STL | https://www.shapeways.com
yoke_SS | Yoke Stainless | Shapeways | Printed Stainless Steel | 48.87 | N/A | N/A | 1 | 0 | 0 | 0 | yoke.STL | https://www.shapeways.com
yoke_Ny | Yoke Plastic | Shapeways | Strong and Flexible Black | 9.76 | N/A | N/A | 1 | 0 | 0 | 0 | yoke.STL | https://www.shapeways.com
Motor Mount Inside_SS | Motor Mount Inside | Shapeways | Printed Stainless Steel | 51.92 | N/A | N/A | 1 | 0 | 0 | 0 | motor_mount_inside.STL | https://www.shapeways.com
Motor Mount Inside_NY | Motor Mount Inside | Shapeways | Strong and Flexible Black | 8.88 | N/A | N/A | 1 | 0 | 0 | 0 | motor_mount_inside.STL | https://www.shapeways.com
Yaw Bottom Bearing Mount_SS | Yaw Bottom Bearing Mount | Shapeways | Printed Stainless Steel | 73.84 | N/A | N/A | 1 | 0 | 0 | 0 | yaw_bearing_mount_bottom.STL | https://www.shapeways.com
Yaw Bottom Bearing Mount_NY | Yaw Bottom Bearing Mount | Shapeways | Strong and Flexible Black | 11.06 | N/A | N/A | 1 | 0 | 0 | 0 | yaw_bearing_mount_bottom.STL | https://www.shapeways.com
Yaw Top Bearing Mount_SS | Yaw Top Bearing Mount | Shapeways | Printed Stainless Steel | 87.83 | N/A | N/A | 1 | 0 | 0 | 0 | yaw_bearing_mount_top.STL | https://www.shapeways.com
Yaw Top Bearing Mount_NY | Yaw Top Bearing Mount | Shapeways | Strong and Flexible Black | 13.25 | N/A | N/A | 1 | 0 | 0 | 0 | yaw_bearing_mount_top.STL | https://www.shapeways.com
Roll Motor Mount_SS | Roll Motor Mount | Shapeways | Printed Stainless Steel | 89.08 | N/A | N/A | 1 | 0 | 0 | 0 | roll_motor_mount.STL | https://www.shapeways.com
Roll Motor Mount_NY | Roll Motor Mount | Shapeways | Strong and Flexible Black | 13.66 | N/A | N/A | 1 | 0 | 0 | 0 | roll_motor_mount.STL | https://www.shapeways.com
Roll Bearing Mount_SS | Roll Bearing Mount | Shapeways | Printed Stainless Steel | 123.93 | N/A | N/A | 1 | 0 | 0 | 0 | roll_bearing_mount.STL | https://www.shapeways.com
Roll Bearing Mount_NY | Roll Bearing Mount | Shapeways | Strong and Flexible Black | 17.39 | N/A | N/A | 1 | 0 | 0 | 0 | roll_bearing_mount.STL | https://www.shapeways.com
Dogbone Link_NY | Dogbone Link | Shapeways | Strong and Flexible Black | 3.37 | N/A | N/A | 1 | 0 | 0 | 0 | dogbone_link.STL | https://www.shapeways.com
Dogbone Link_SS | Dogbone Link | Shapeways | Stainless Steel | 11.16 | N/A | N/A | 1 | 0 | 0 | 0 | dogbone_link.STL | https://www.shapeways.com
LM1247 Spacer_NY | LM1247 Spacer | Shapeways | Strong and Flexible Black | 5.86 | N/A | N/A | 1 | 0 | 0 | 0 | lm1247_spacer.STL | https://www.shapeways.com
LM1247 Spacer_SS | LM1247 Spacer | Shapeways | Stainless Steel | 25.9 | N/A | N/A | 1 | 0 | 0 | 0 | lm1247_spacer.STL | https://www.shapeways.com
motor_mount_SS |  | Shapeways | Printed Stainless Steel | 181.52 | N/A | N/A | 1 | 0 | 0 | 0 | motor_mount.STL | https://www.shapeways.com
motor_mount_NY |  | Shapeways | Strong and Flexible Black | 25.8 | N/A | N/A | 1 | 0 | 0 | 0 | motor_mount.STL | https://www.shapeways.com
pitch_body_SS |  | Shapeways | Printed Stainless Steel | 72.99 | N/A | N/A | 1 | 0 | 0 | 0 | pitch_body.STL | https://www.shapeways.com
pitch_body_NY |  | Shapeways | Strong and Flexible Black | 13.54 | N/A | N/A | 1 | 0 | 0 | 0 | pitch_body.STL | https://www.shapeways.com
pitch_stop_SS |  | Shapeways | Printed Stainless Steel | 12.88 | N/A | N/A | 1 | 0 | 0 | 0 | pitch_stop.STL | https://www.shapeways.com
pitch_stop_NY |  | Shapeways | Strong and Flexible Black | 3.41 | N/A | N/A | 1 | 0 | 0 | 0 | pitch_stop.STL | https://www.shapeways.com
yaw_link_SS |  | Shapeways | Printed Stainless Steel | 210.86 | N/A | N/A | 1 | 0 | 0 | 0 | yaw_link.STL | https://www.shapeways.com
yaw_link_NY |  | Shapeways | Strong and Flexible Black | 26.37 | N/A | N/A | 1 | 0 | 0 | 0 | yaw_link.STL | https://www.shapeways.com
yaw_shaft_SS |  | Shapeways | Printed Stainless Steel | 31.72 | N/A | N/A | 1 | 0 | 0 | 0 | yaw_shaft.STL | https://www.shapeways.com
yaw_shaft_NY |  | Shapeways | Strong and Flexible Black | 5.85 | N/A | N/A | 1 | 0 | 0 | 0 | yaw_shaft.STL | https://www.shapeways.com
P028.002.E894 | iPOS360x SX Multi-axis Motion System | Technosoft Motion | iPOS360x MBX-NET | 200 | ~ |  | 1 | 2 | 2 | 400 | iPOS360xMulti.SLDPRT | http://www.technosoftmotion.com/en/intelligent-drives-and-motors/ipos-line/ipos-multi-axis/ipos360x-sx
P028.001.E001 | iPOS3602 VX Intelligent Drive (75 W, CANopen / EtherCAT) | Technosoft Motion | iPOS3602 VX-CAN | 300 | ~ |  | 1 | 9 | 9 | 2700 | iPOS360xMulti.SLDPRT | http://www.technosoftmotion.com/en/intelligent-drives-and-motors/ipos-line/ipos3602/ipos3602-vx
P038.022.E001 | Ethernet-CAN Adapter | Technosoft Motion | ENET-VX Ethernet plug-in interface | 75 | not sure of this price |  | 1 | 2 | 2 | 150 | iPOS360xMulti.SLDPRT | http://www.technosoftmotion.com/en/starter-kits-and-accessories/ethernet-can-adapter#description
EM2-1-5000-I | Encoder | US Digital | Plastic | 58.1 | 40.1 | 35.71 | 1 | 8 | 8 | 320.8 | EM1-X-X.SLDPRT | http://www.usdigital.com/products/encoders/incremental/modules/EM2
DISK-1-5000-093-IE | Encoder Disk | US Digital | Mylar | 13.63 | 9.42 | 8.11 | 1 | 6 | 6 | 56.52 | encoder_disk.SLDPRT | http://www.usdigital.com/products/encoders/incremental/rotary/disks/DISK-1
HUBDISK-1-5000-250-IE | Encoder Disk, 5000 CPR, Index, 1/4" Hub | US Digital | Mylar | 20.53 | 14.16 | 10.81 | 1 | 3 | 3 | 61.59 | HUBDISK-1-5000-250-IE.SLDPRT | http://www.usdigital.com/products/encoders/incremental/rotary/disks/HUBDISK-1
HUBDISK-1-5000-313-IE | Encoder Disk, 5000 CPR, Index, 5/16" Hub | US Digital | Mylar | 20.53 | 14.16 | 10.81 | 1 | 1 | 1 | 20.53 | HUBDISK-1-5000-313-IE.SLDPRT | http://www.usdigital.com/products/encoders/incremental/rotary/disks/DISK-1
 |  | Cart Link
McMaster Total | 554.71 | http://www.mcmaster.com/order/rcvRtedOrd.aspx?ordid=9045008114853&lnktyp=btn
Mouser Total | 219.45 | http://www.mouser.com/ProjectManager/ProjectDetail.aspx?AccessID=fb6dc2dff3
Technosoft Total | 3250
US Digital Total | 459.44
Maxon Total | 954 | http://www.maxonmotorusa.com/maxon/view/configurator/?ConfigID=B75AECFD27A3
MicroMo | 3235.8
Shapeways Total | 0
Protolabs Total | 460.1 | bptripp@uwaterloo.ca | _4#GMg6EA)}y>y(5 | https://myaccount.protolabs.com
Hobby King Total | 33.9
NTC Distributing | 108
TOTAL | 9275.4 | USD | 12706.0274
