tomwym/oreo_mpc/model/estop/A22E_S.SLDASM

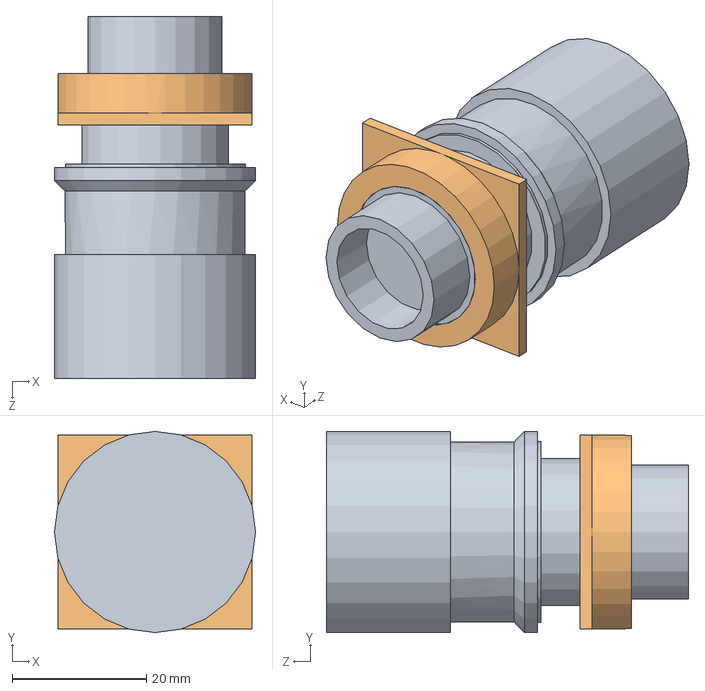
[picture p2: CAD file, 2021-12-12]
model/estop/A22E_S.SLDASM
30.0 x 30.0 x 54.0 mm
A22E_S_BASE
A22E_S_NUTS
