tomwym/oreo_mpc/stl/Neck_asm.STL

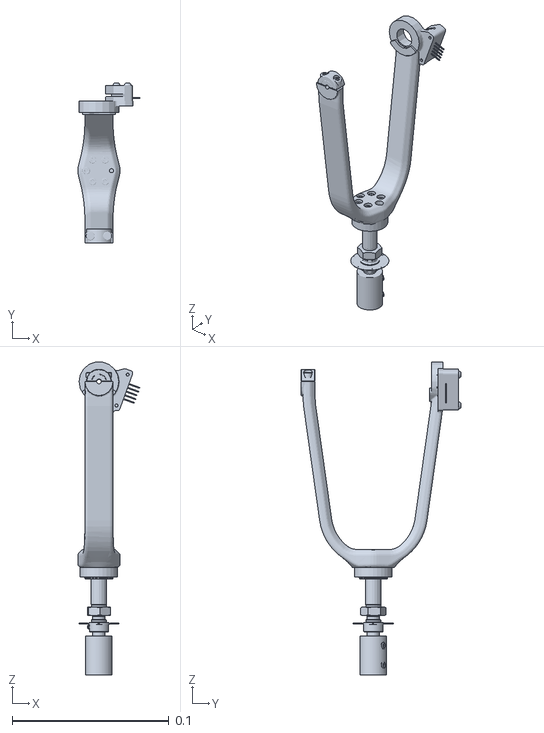
[picture p4: CAD file, 2021-12-12]
stl/Neck_asm.STL
0.0399 x 0.102 x 0.2
