tomwym/oreo_mpc/stl/left_eye_yolk_asm.STL

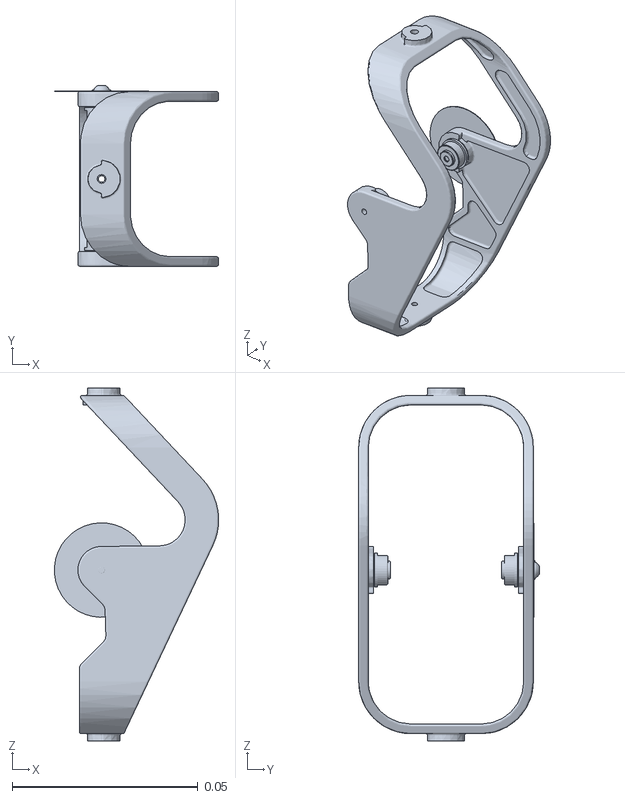
[picture p5: CAD file, 2021-12-12]
stl/left_eye_yolk_asm.STL
0.0442 x 0.0486 x 0.0949
