tomwym/oreo_mpc/stl/left_eye_asm.STL

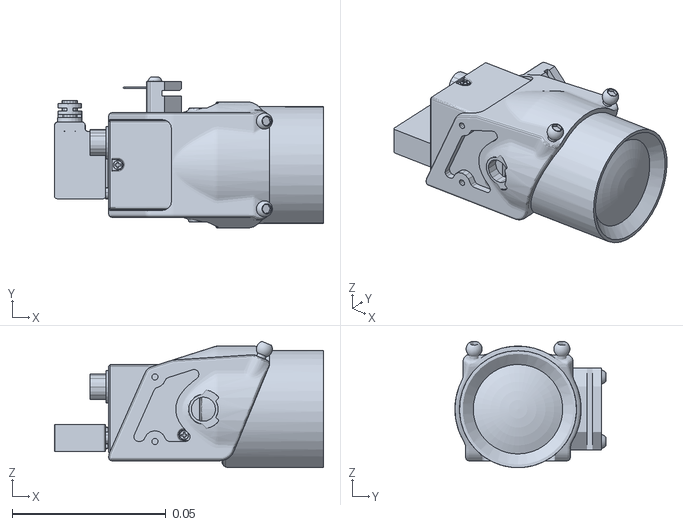
[picture p6: CAD file, 2021-12-12]
stl/left_eye_asm.STL
0.0874 x 0.0491 x 0.041
