tomwym/oreo_mpc/model/estop/A22_01M.SLDASM

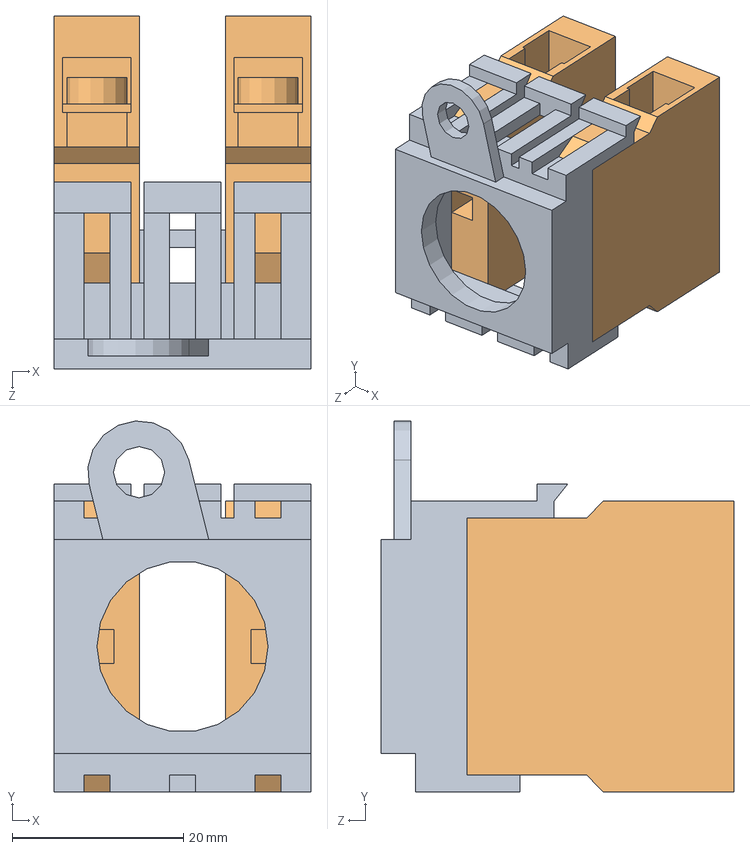
[picture p7: CAD file, 2021-12-12]
model/estop/A22_01M.SLDASM
30.0 x 43.4 x 41.2 mm
A22_3200
A22_01 x 2
