tomwym/oreo_mpc/model/estop/A22E_S_02.SLDASM

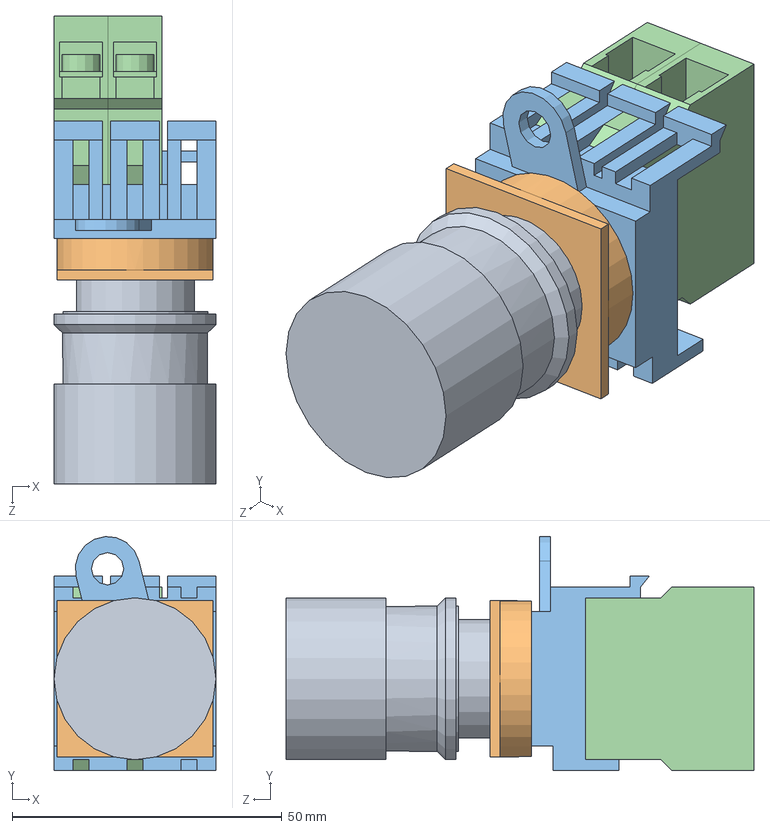
[picture p8: CAD file, 2021-12-12]
model/estop/A22E_S_02.SLDASM
30.0 x 43.4 x 86.7 mm
A22E_S_BASE
A22E_S_NUTS
A22_3200
A22_01 x 2
