tomwym/oreo_mpc/stl/linear_motor_rod_assembly.STL

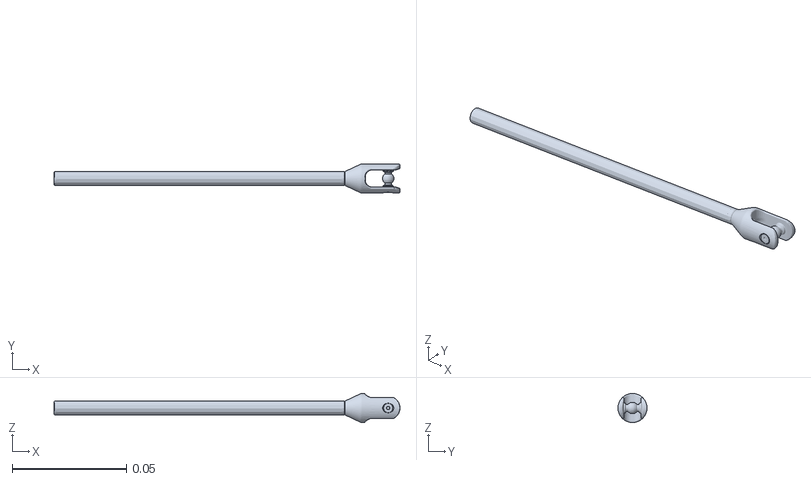
[picture p9: CAD file, 2020-02-14]
stl/linear_motor_rod_assembly.STL
0.151 x 0.0127 x 0.0127
