tomwym/oreo_mpc/model/eye_sub_asm.SLDASM

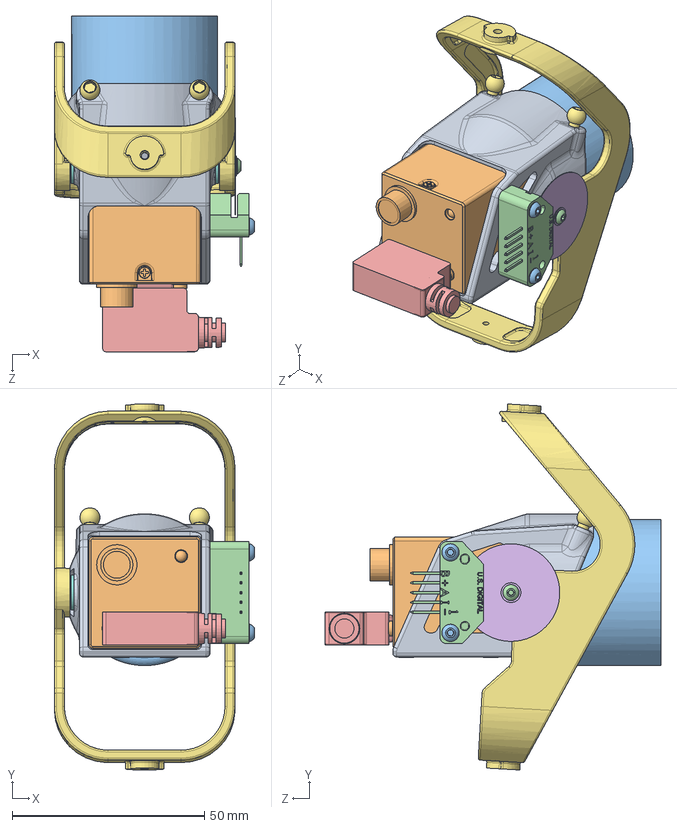
[picture p10: CAD file, 2021-12-12]
model/eye_sub_asm.SLDASM
52.1 x 95.3 x 87.4 mm
cam_mount
FL2-006-R0
lens
EM1-X-X
USBFIREWIRE_COM-MCBR3
encoder_disk
yoke
4262T500 x 2
90318A101 x 2
91294A002 x 4
91239A758 x 2
91255A075
9712K510
99040A210 x 2
