tomwym/oreo_mpc/model/maxon16dxl/maxon_PN_B75AECFD27A3.sldasm

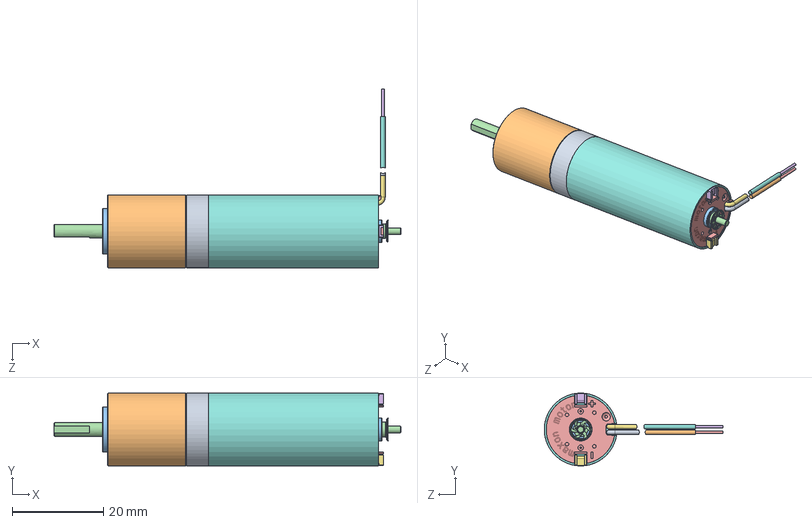
[picture p11: CAD file, 2021-12-12]
model/maxon16dxl/maxon_PN_B75AECFD27A3.sldasm
76.2 x 16.0 x 39.2 mm
maxon_PN_B75AECFD27A3_1
maxon_PN_B75AECFD27A3_2
maxon_PN_B75AECFD27A3_3
maxon_PN_B75AECFD27A3_3_2
maxon_PN_B75AECFD27A3_4
maxon_PN_B75AECFD27A3_4_2
maxon_PN_B75AECFD27A3_5
maxon_PN_B75AECFD27A3_5_2
maxon_PN_B75AECFD27A3_6
maxon_PN_B75AECFD27A3_6_2
maxon_PN_B75AECFD27A3_7
maxon_PN_B75AECFD27A3_7_2
maxon_PN_B75AECFD27A3_8
maxon_PN_B75AECFD27A3_8_2
maxon_PN_B75AECFD27A3_8_3
maxon_PN_B75AECFD27A3
