tomwym/oreo_mpc/model/KBRM_02_1.SLDASM

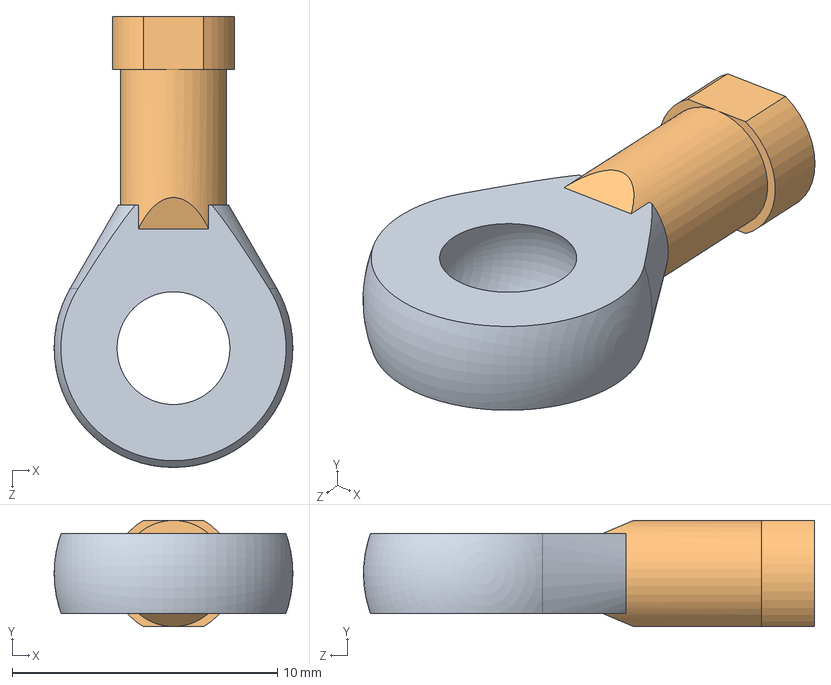
[picture p12: CAD file, 2021-12-12]
model/KBRM_02_1.SLDASM
9.00 x 4.00 x 17.0 mm
