tomwym/oreo_mpc/model/dogbone.SLDASM

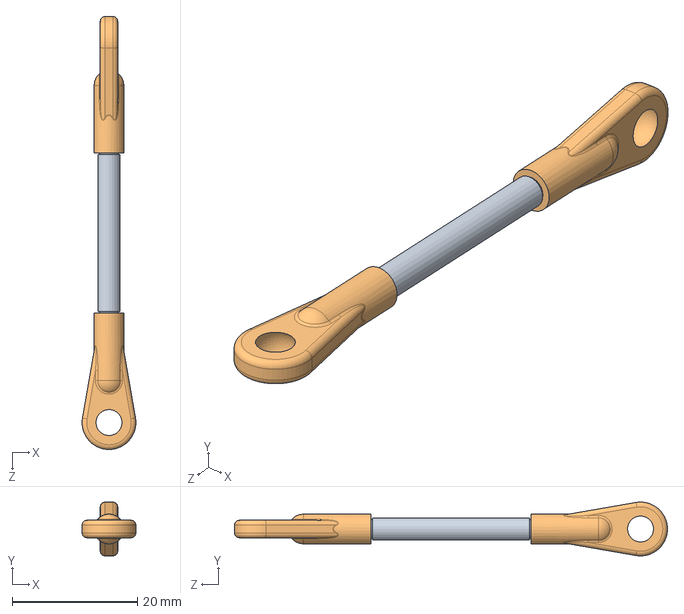
[picture p13: CAD file, 2021-12-12]
model/dogbone.SLDASM
8.59 x 8.59 x 69.1 mm
pushrod
rod_end_2 x 2
