tomwym/oreo_mpc/model/2016_07_13_MFG_RELEASE/yaw_link.STL

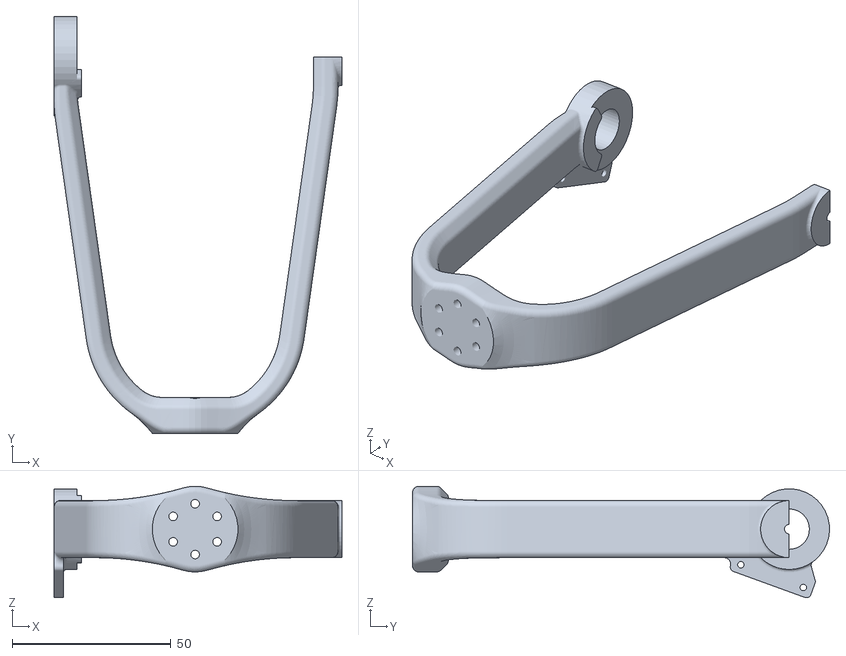
[picture p14: CAD file, 2021-12-12]
model/2016_07_13_MFG_RELEASE/yaw_link.STL
90.7 x 131.3 x 35.1
