tomwym/oreo_mpc/model/FL3_U3_Dimensions/FL3_U3-CSMount/FL2-006-R0.SLDPRT

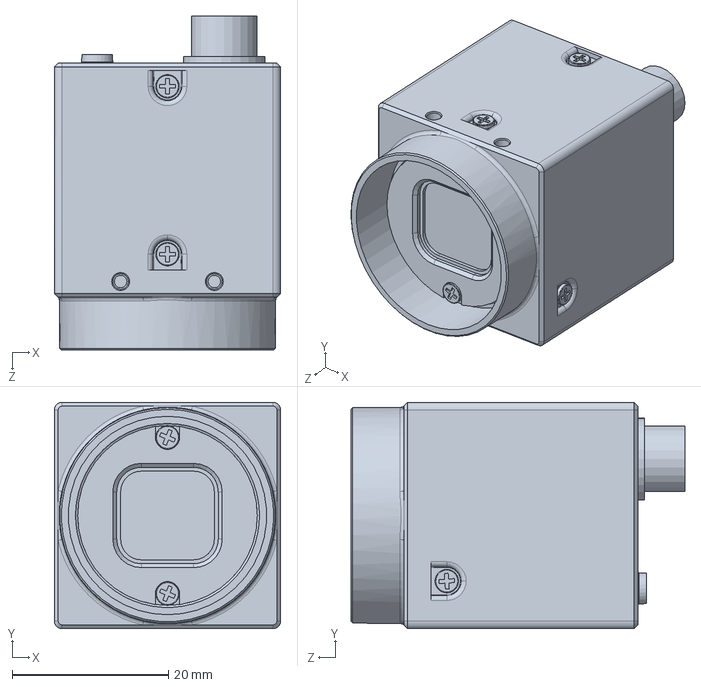
[picture p15: CAD file, 2021-12-12]
model/FL3_U3_Dimensions/FL3_U3-CSMount/FL2-006-R0.SLDPRT
29.0 x 29.0 x 42.8 mm
