tomwym/oreo_mpc/model/LM_1247/LM1247-040-XX.stp

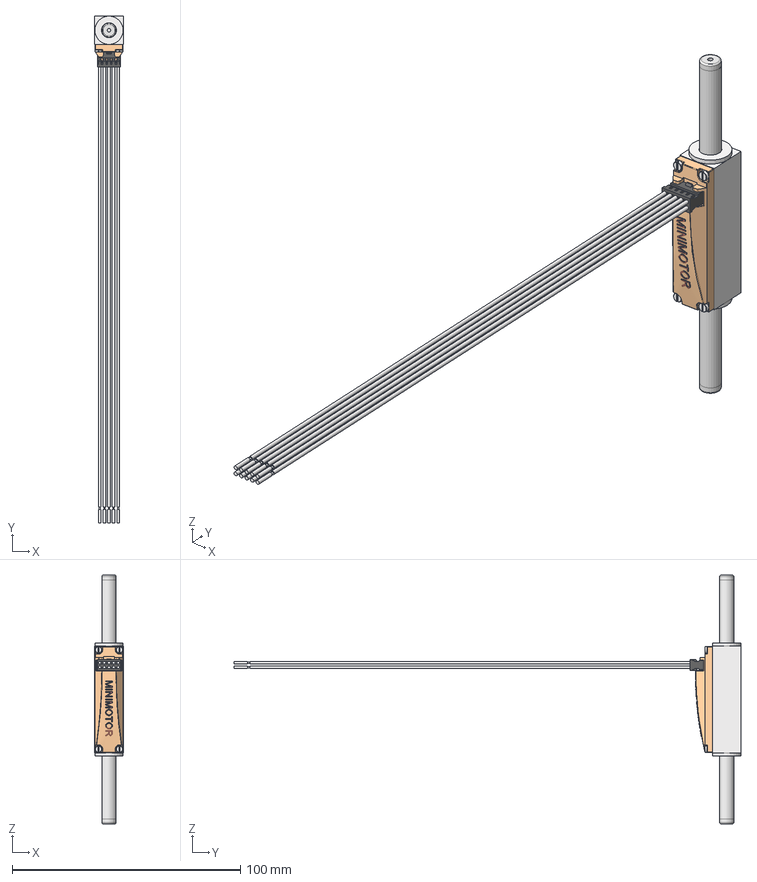
[picture p16: CAD file, 2021-12-12]
model/LM_1247/LM1247-040-XX.stp
12.5 x 222.3 x 109.0 mm
LM1247_xxx_xx_Housing
LM1247_040_Rod
LM1247_Wires_&_Connector
