tomwym/oreo_mpc/model/split_files/roll_motor_mount.sldprt

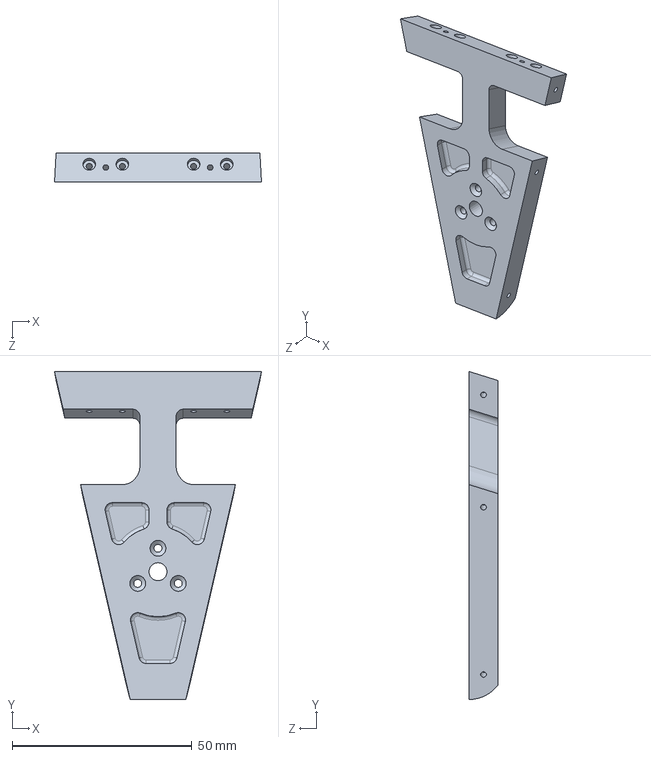
[picture p17: CAD file, 2021-12-12]
model/split_files/roll_motor_mount.sldprt
57.5 x 91.1 x 8.00 mm
