tomwym/oreo_mpc/model/USBFIREWIRE_COM-MCBL3/USBFIREWIRE_COM-MCBL3.SLDPRT

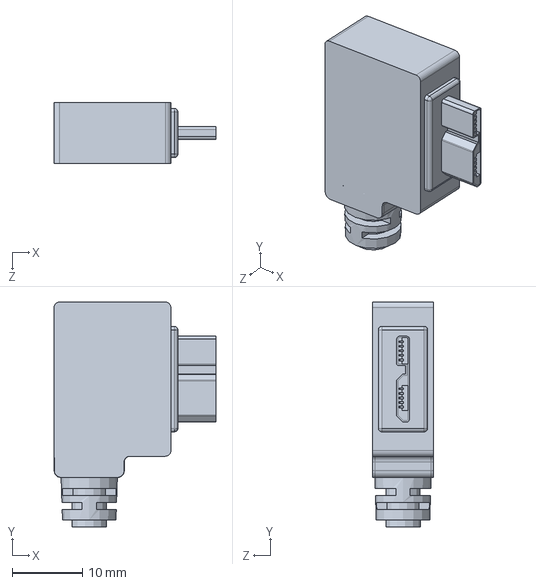
[picture p18: CAD file, 2021-12-12]
model/USBFIREWIRE_COM-MCBL3/USBFIREWIRE_COM-MCBL3.SLDPRT
23.0 x 32.0 x 8.64 mm
