tomwym/oreo_mpc/model/USBFIREWIRE_COM-MCBU3/USBFIREWIRE_COM-MCBU3.SLDPRT

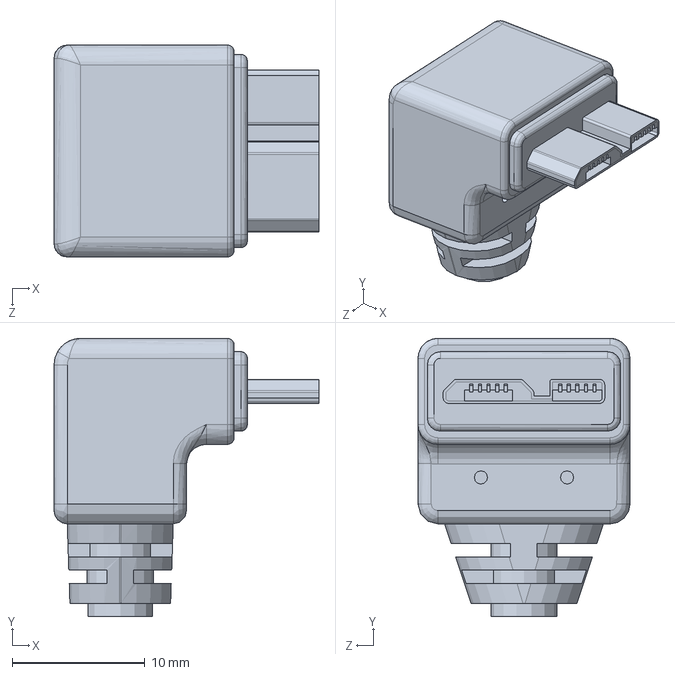
[picture p19: CAD file, 2021-12-12]
model/USBFIREWIRE_COM-MCBU3/USBFIREWIRE_COM-MCBU3.SLDPRT
20.0 x 21.0 x 16.0 mm
