tomwym/oreo_mpc/model/2016_07_13_MFG_RELEASE/pitch_link.STL

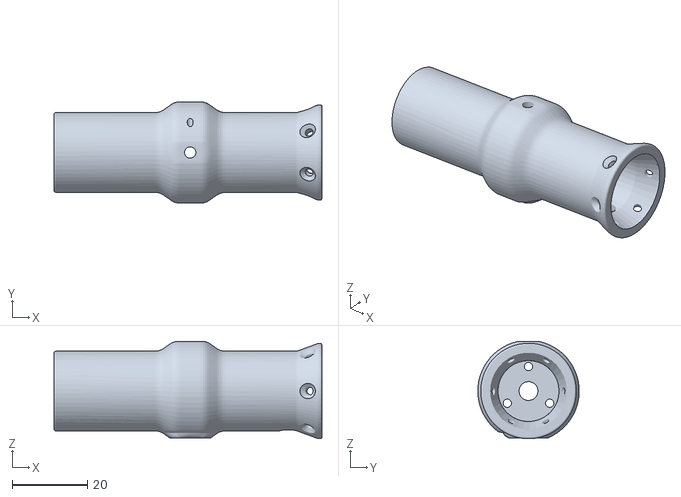
[picture p20: CAD file, 2021-12-12]
model/2016_07_13_MFG_RELEASE/pitch_link.STL
71.3 x 27.0 x 25.9
