tomwym/oreo_mpc/model/estop/A22E_S_NUTS.SLDPRT

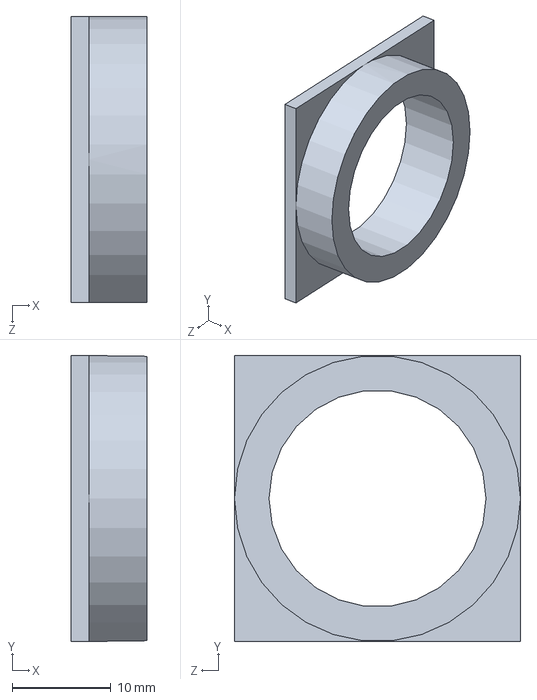
[picture p21: CAD file, 2021-12-12]
model/estop/A22E_S_NUTS.SLDPRT
7.70 x 29.0 x 29.0 mm
