tomwym/oreo_mpc/model/LM_1247/LM1247-060-XX.stp

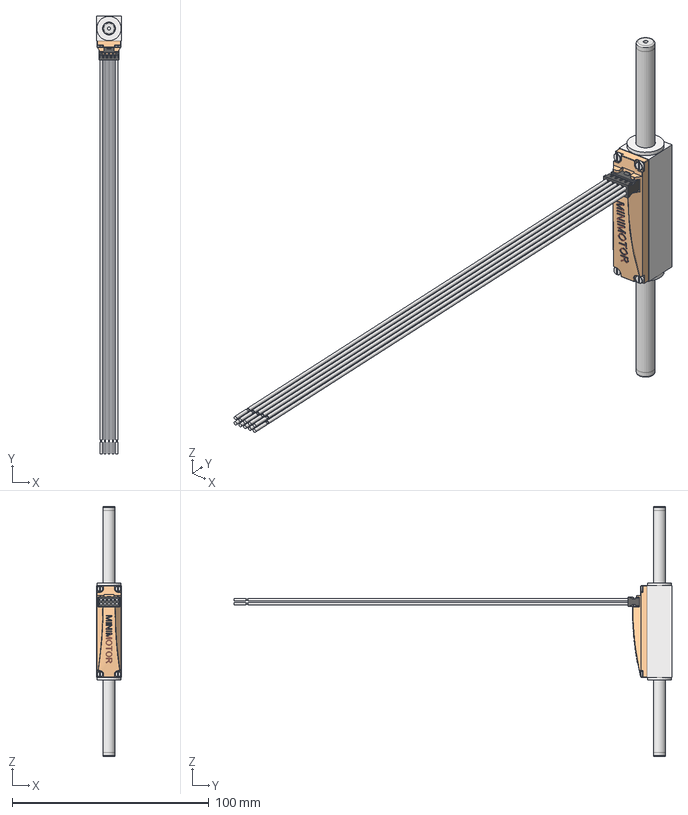
[picture p22: CAD file, 2021-12-12]
model/LM_1247/LM1247-060-XX.stp
12.5 x 222.3 x 127.0 mm
LM1247_xxx_xx_Housing
LM1247_060_Rod
LM1247_Wires_&_Connector
