tomwym/oreo_mpc/model/split_files/yaw_bearing_mount_top.sldprt

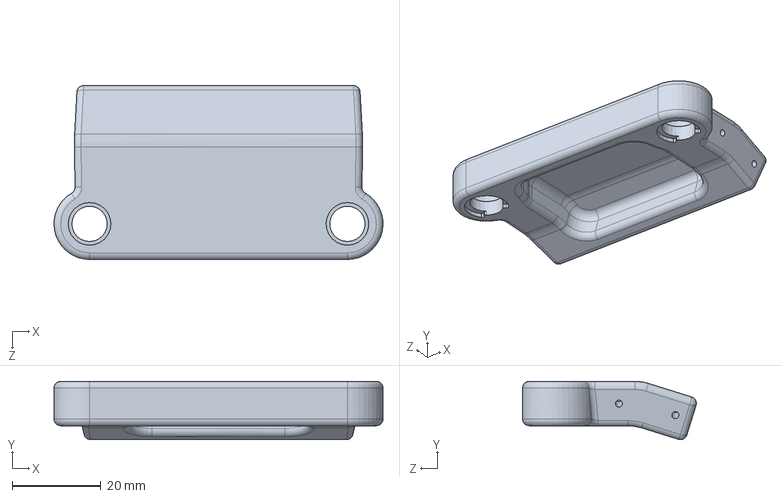
[picture p23: CAD file, 2021-12-12]
model/split_files/yaw_bearing_mount_top.sldprt
74.0 x 13.1 x 39.1 mm
