tomwym/oreo_mpc/model/2016_07_13_MFG_RELEASE/dogbone_link2.STL

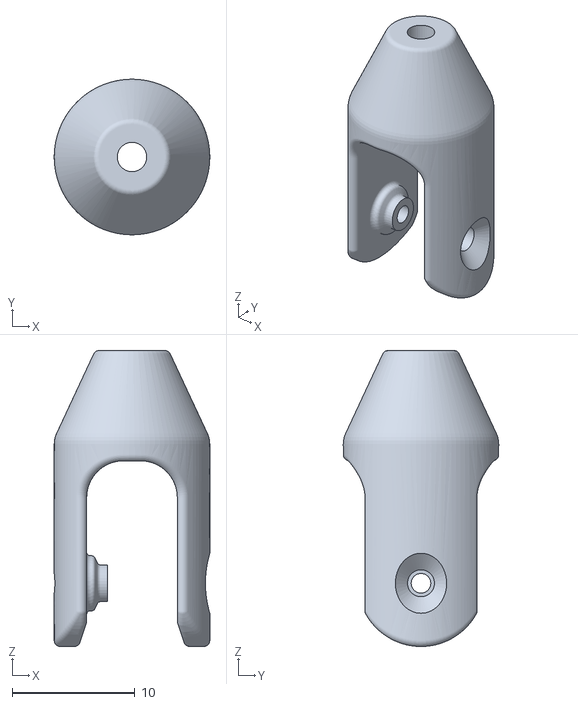
[picture p24: CAD file, 2021-12-12]
model/2016_07_13_MFG_RELEASE/dogbone_link2.STL
12.7 x 12.7 x 24.2
