tomwym/oreo_mpc/model/cam_mount.SLDPRT

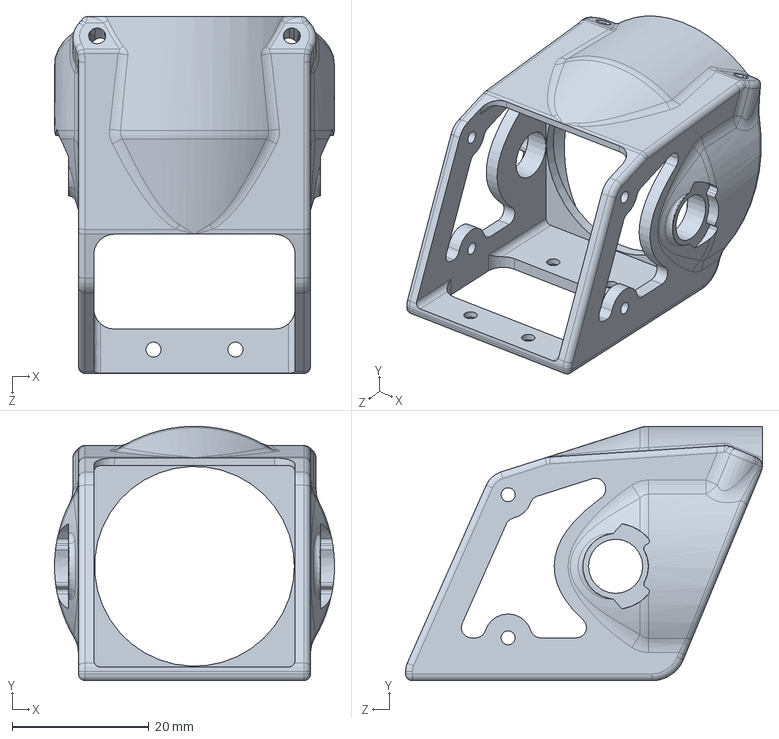
[picture p25: CAD file, 2021-12-12]
model/cam_mount.SLDPRT
41.0 x 37.2 x 52.3 mm
