tomwym/oreo_mpc/model/estop/A22E_S_BASE.SLDPRT

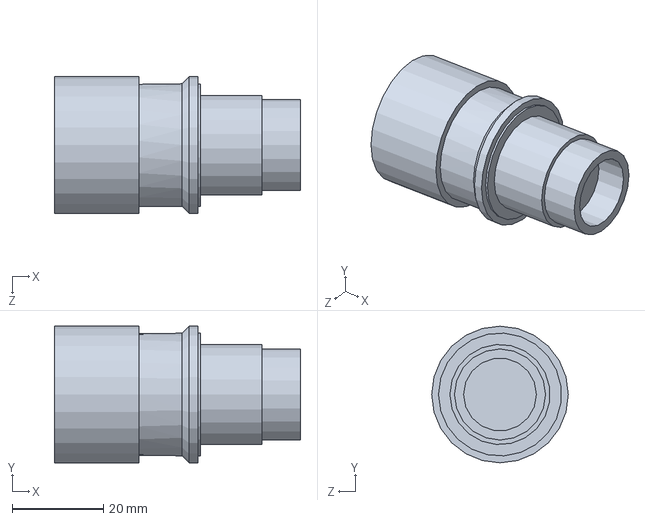
[picture p26: CAD file, 2021-12-12]
model/estop/A22E_S_BASE.SLDPRT
54.0 x 30.0 x 30.0 mm
