tomwym/oreo_mpc/model/LM_1247/LM1247_Wires_&_Connector.sldprt

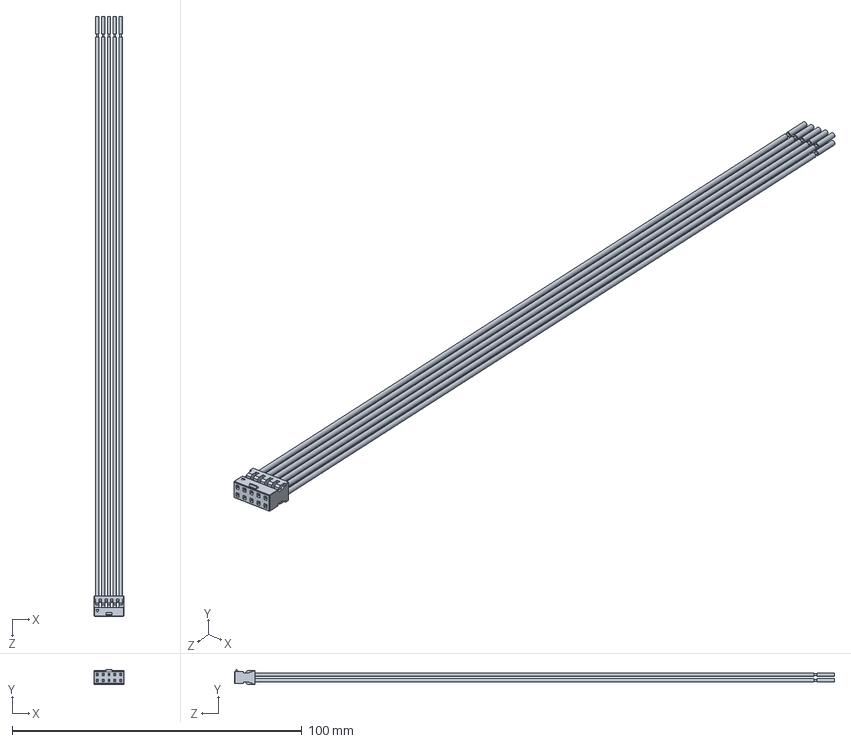
[picture p27: CAD file, 2021-12-12]
model/LM_1247/LM1247_Wires_&_Connector.sldprt
10.2 x 5.15 x 207.0 mm
