tomwym/oreo_mpc/model/split_files/frame_plate_side_l.sldprt

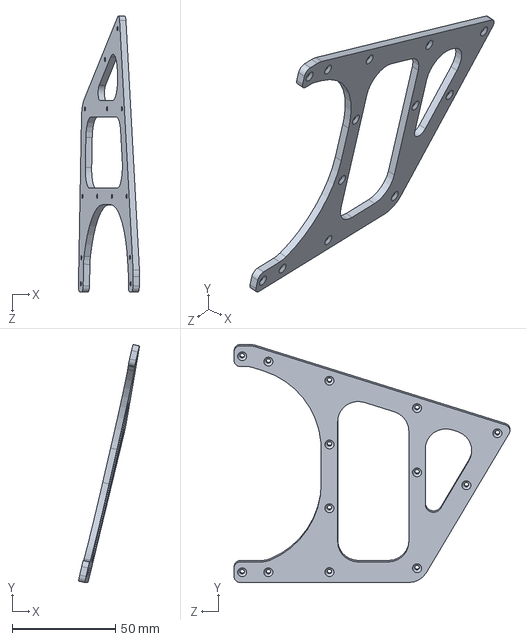
[picture p28: CAD file, 2021-12-12]
model/split_files/frame_plate_side_l.sldprt
29.7 x 115.5 x 133.9 mm
