tomwym/oreo_mpc/model/2016_07_13_MFG_RELEASE/yoke.STL

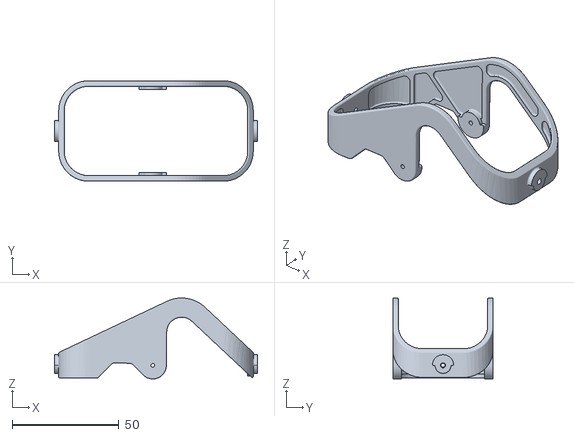
[picture p29: CAD file, 2021-12-12]
model/2016_07_13_MFG_RELEASE/yoke.STL
94.9 x 47.0 x 37.9
