tomwym/oreo_mpc/model/split_files/pitch_body.sldprt

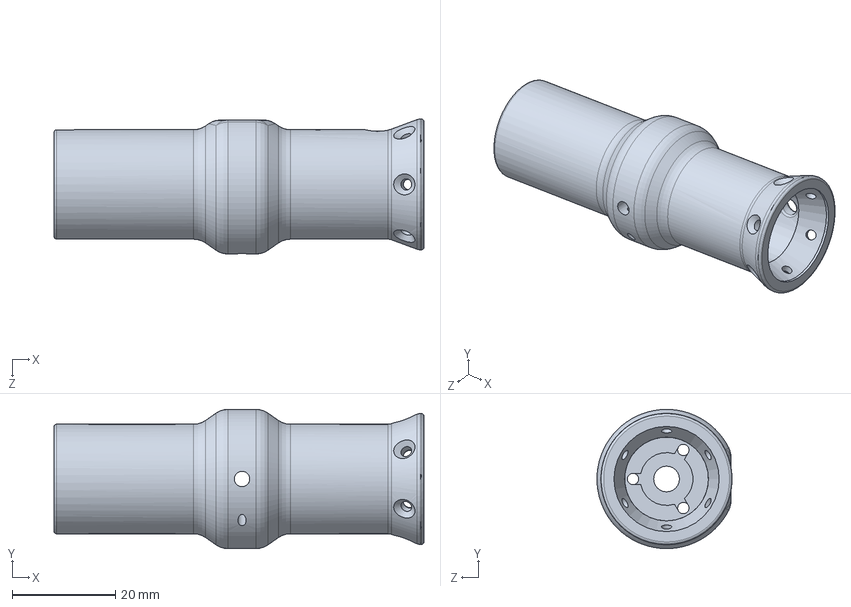
[picture p30: CAD file, 2021-12-12]
model/split_files/pitch_body.sldprt
71.7 x 27.0 x 26.2 mm
