tomwym/oreo_mpc/model/2016_07_13_MFG_RELEASE/pitch_link_end_cap.STL

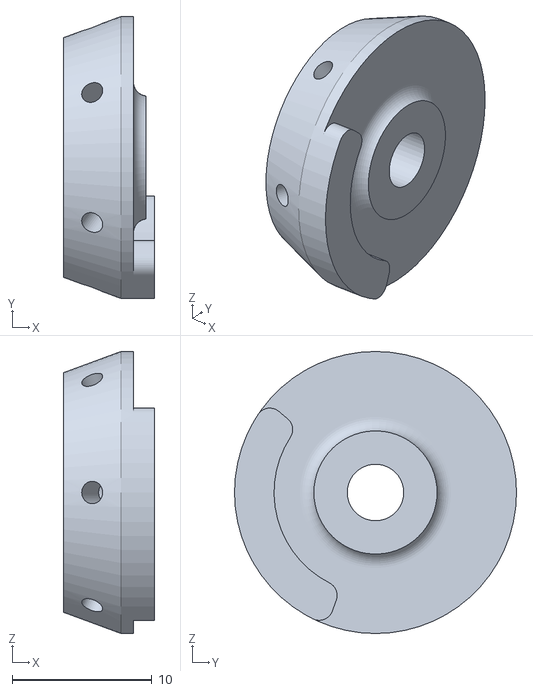
[picture p31: CAD file, 2021-12-12]
model/2016_07_13_MFG_RELEASE/pitch_link_end_cap.STL
6.50 x 20.1 x 20.1
