tomwym/oreo_mpc/model/split_files/pitch_stop.sldprt

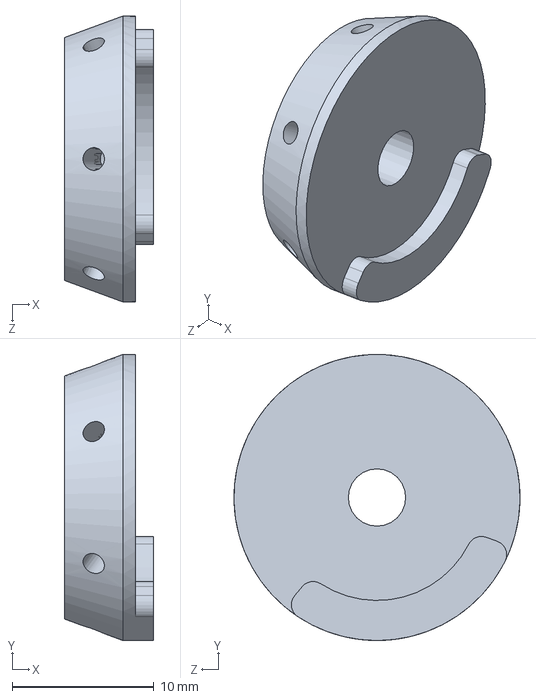
[picture p33: CAD file, 2021-12-12]
model/split_files/pitch_stop.sldprt
6.25 x 20.1 x 20.1 mm
