tomwym/oreo_mpc/model/estop/A22_3200.SLDPRT

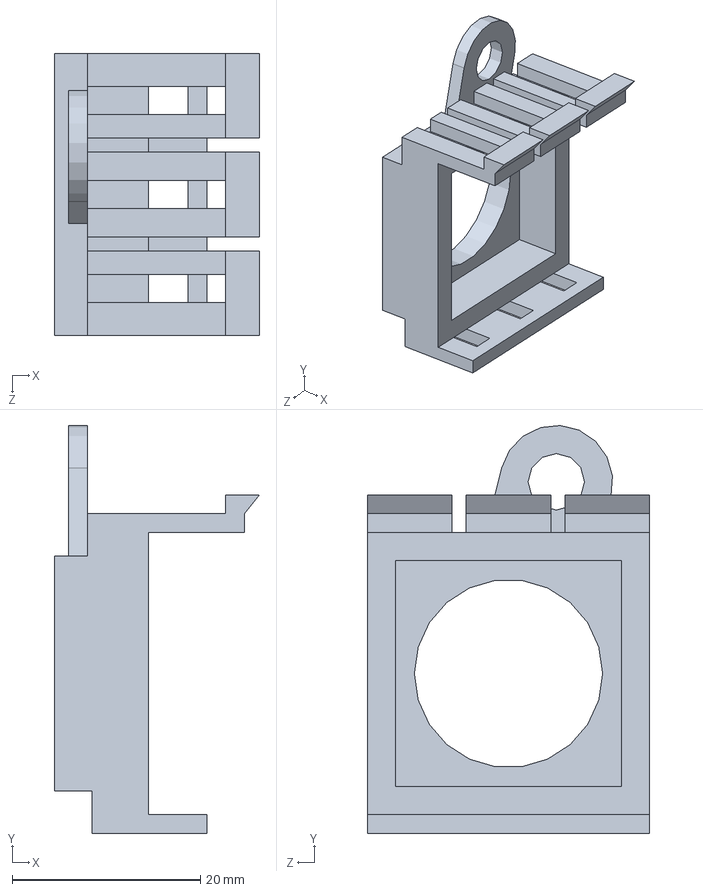
[picture p34: CAD file, 2021-12-12]
model/estop/A22_3200.SLDPRT
21.8 x 43.4 x 30.0 mm
