tomwym/oreo_mpc/model/LM_1247/LM1247_xxx_xx_Housing_1.sldprt

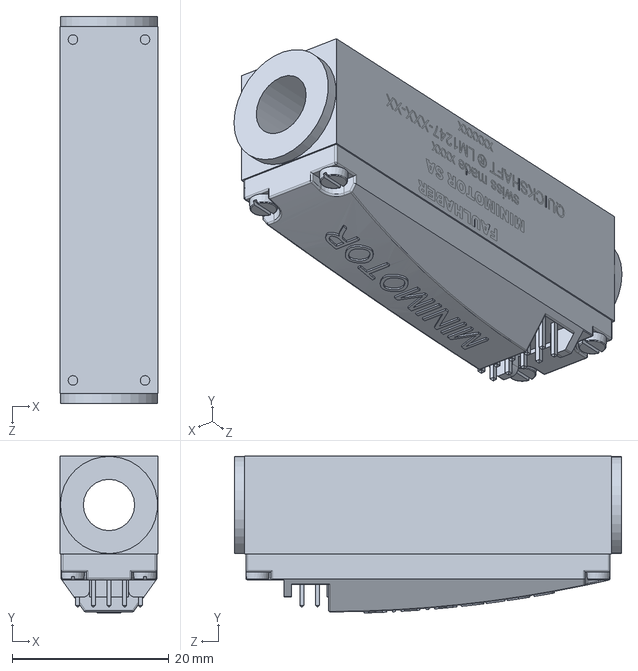
[picture p35: CAD file, 2021-12-12]
model/LM_1247/LM1247_xxx_xx_Housing_1.sldprt
12.5 x 20.0 x 49.4 mm
