tomwym/oreo_mpc/model/split_files/lm1247_spacer.sldprt

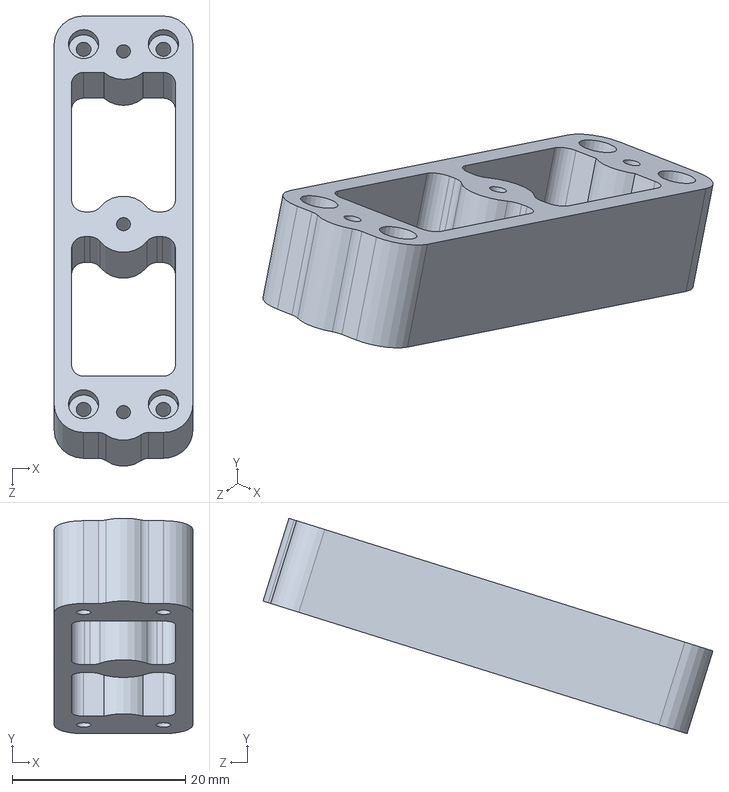
[picture p36: CAD file, 2021-12-12]
model/split_files/lm1247_spacer.sldprt
16.0 x 24.8 x 51.9 mm
