tomwym/oreo_mpc/stl/pitch_piece.STL

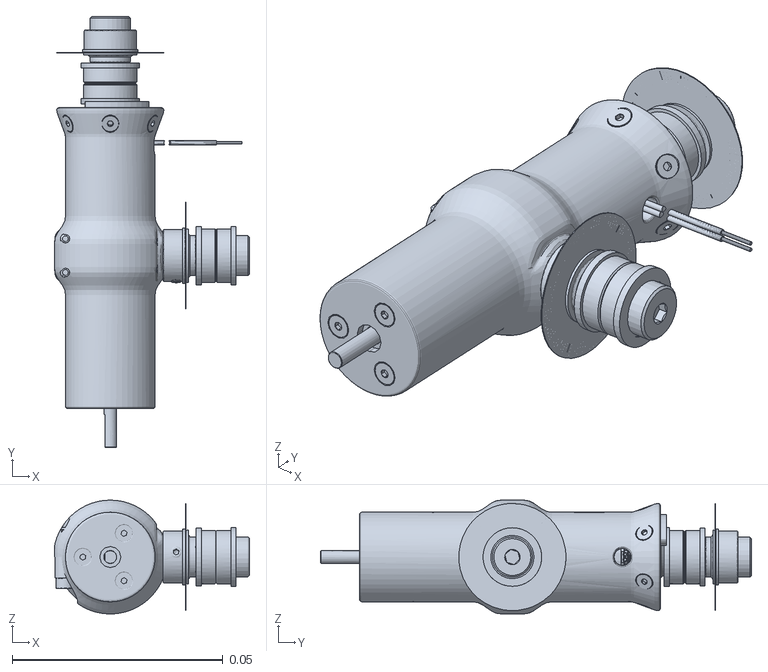
[picture p37: CAD file, 2021-12-12]
stl/pitch_piece.STL
0.0463 x 0.102 x 0.027
