tomwym/oreo_mpc/model/split_files/yaw_bearing_mount_bottom.sldprt

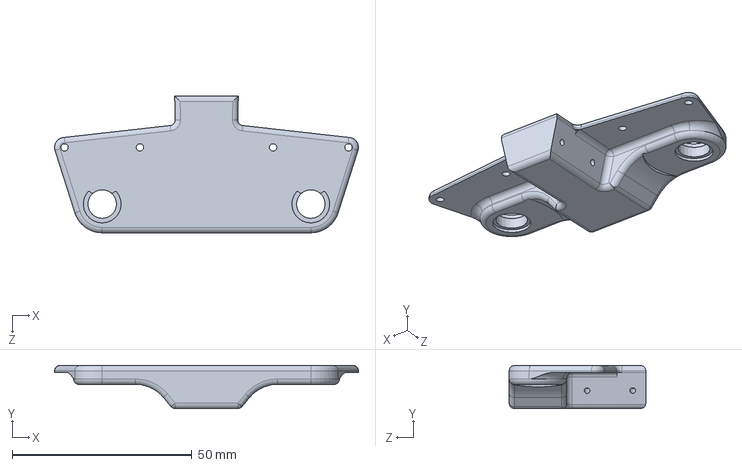
[picture p38: CAD file, 2021-12-12]
model/split_files/yaw_bearing_mount_bottom.sldprt
84.5 x 12.0 x 38.0 mm
