tomwym/oreo_mpc/model/LM_1247/LM1247_060_Rod.sldprt

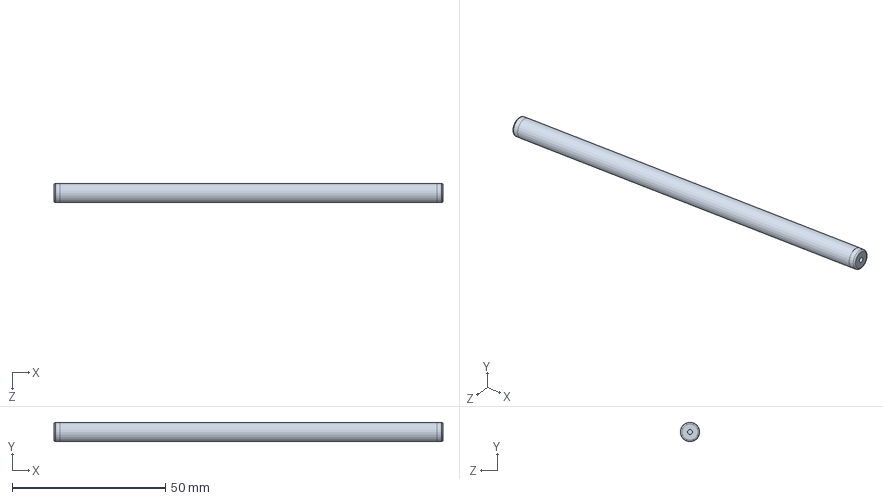
[picture p39: CAD file, 2021-12-12]
model/LM_1247/LM1247_060_Rod.sldprt
127.0 x 6.31 x 6.31 mm
