tomwym/oreo_mpc/model/estop/A22_01.SLDPRT

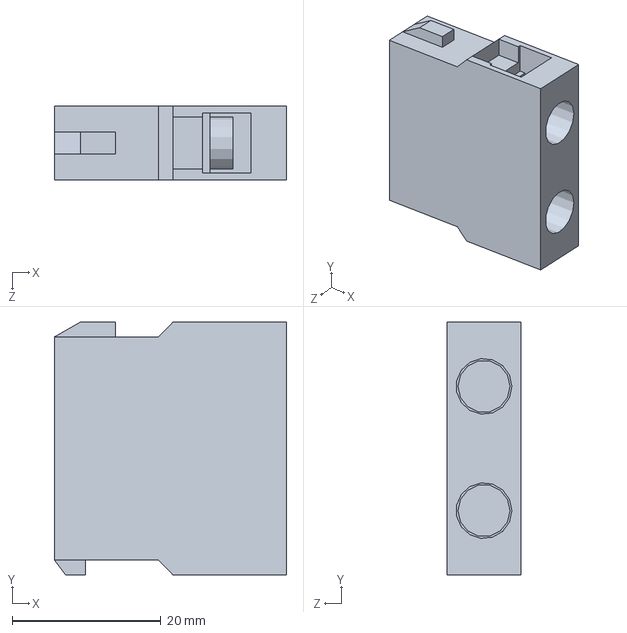
[picture p40: CAD file, 2021-12-12]
model/estop/A22_01.SLDPRT
31.2 x 34.0 x 10.0 mm
