tomwym/oreo_mpc/model/split_files/roll_bearing_mount.sldprt

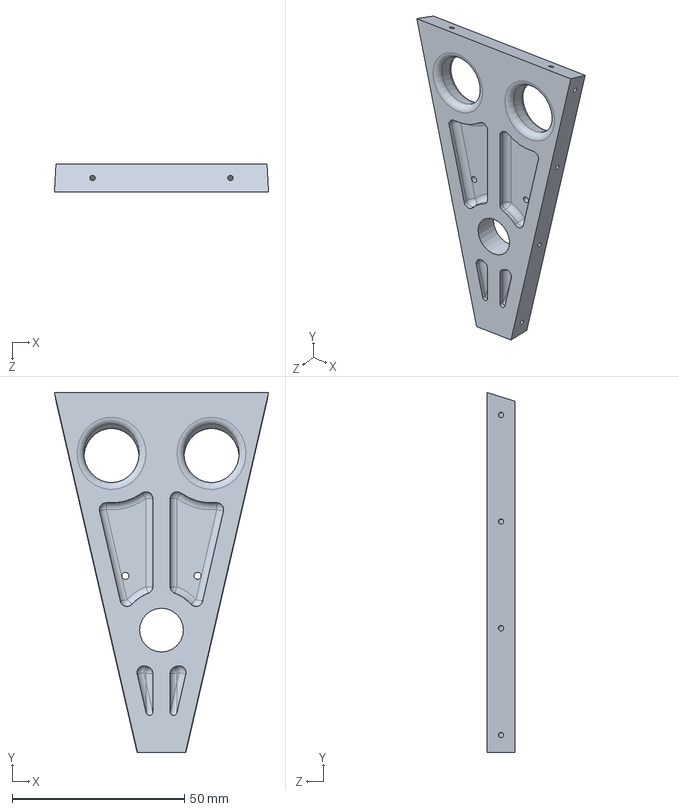
[picture p42: CAD file, 2021-12-12]
model/split_files/roll_bearing_mount.sldprt
62.1 x 104.4 x 8.00 mm
