tomwym/oreo_mpc/model/split_files/motor_mount_inside.sldprt

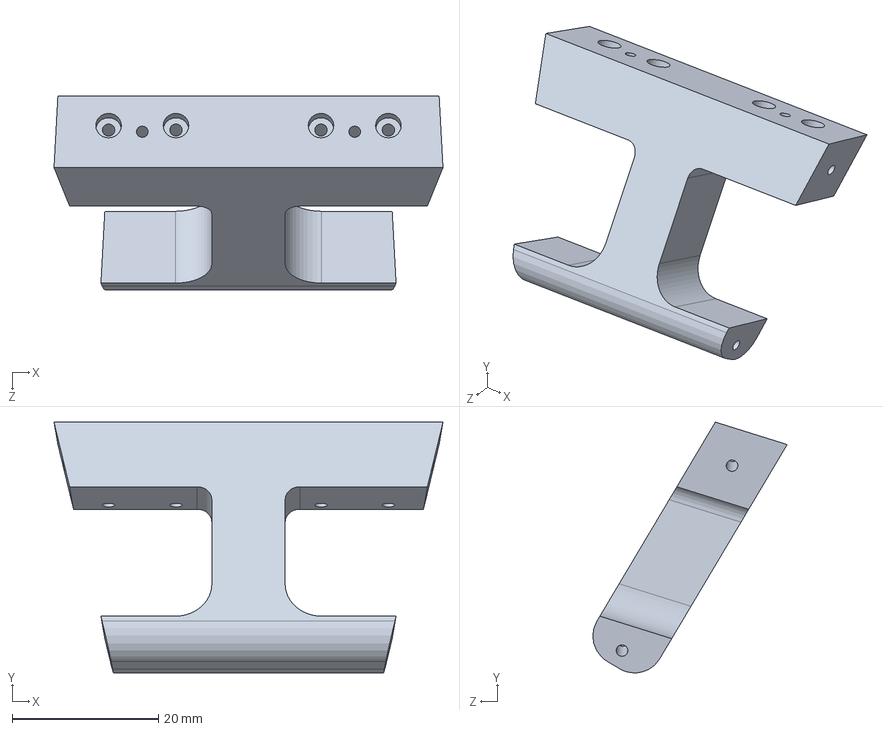
[picture p44: CAD file, 2021-12-12]
model/split_files/motor_mount_inside.sldprt
53.1 x 34.2 x 26.5 mm
