tomwym/oreo_mpc/model/spring.SLDPRT

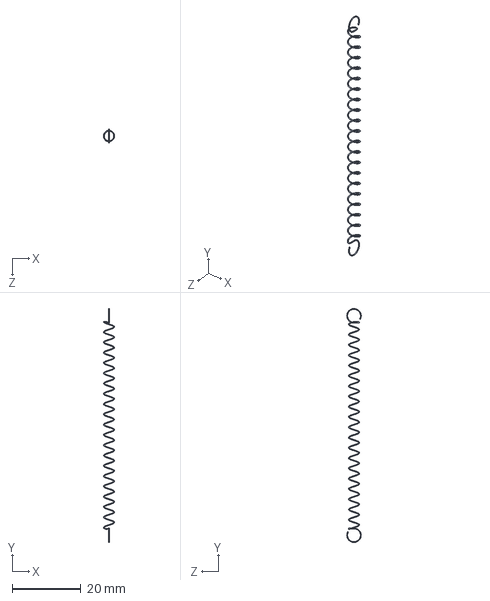
[picture p45: CAD file, 2021-12-12]
model/spring.SLDPRT
3.25 x 68.2 x 4.25 mm
