tomwym/oreo_mpc/model/split_files/frame_plate_top.sldprt

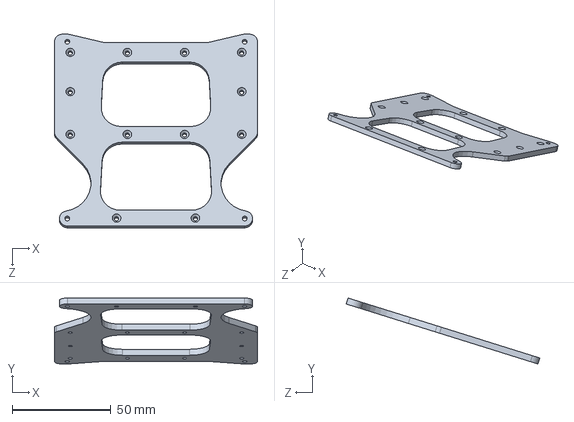
[picture p47: CAD file, 2021-12-12]
model/split_files/frame_plate_top.sldprt
103.0 x 33.5 x 98.3 mm
