tomwym/oreo_mpc/model/fov -round.SLDPRT

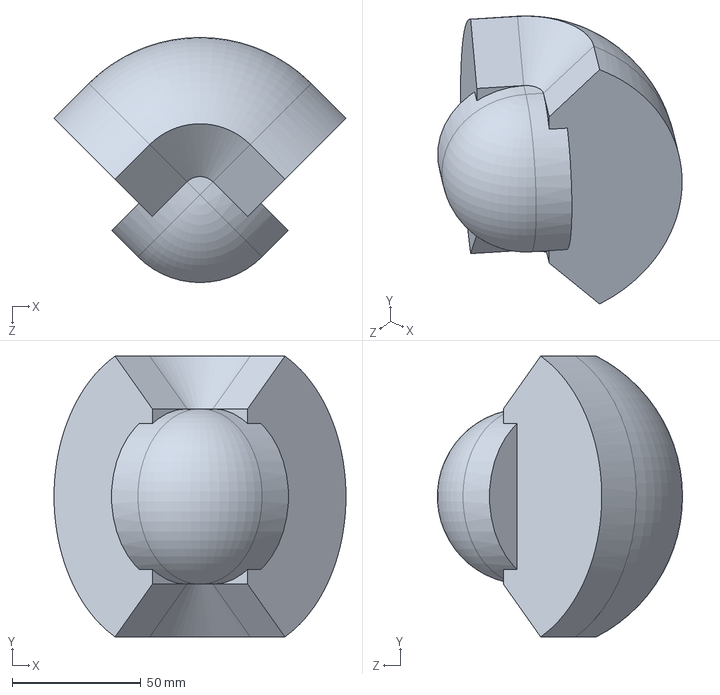
[picture p48: CAD file, 2021-12-12]
model/fov -round.SLDPRT
113.2 x 108.9 x 95.0 mm
