tomwym/oreo_mpc/model/rod_end.SLDPRT

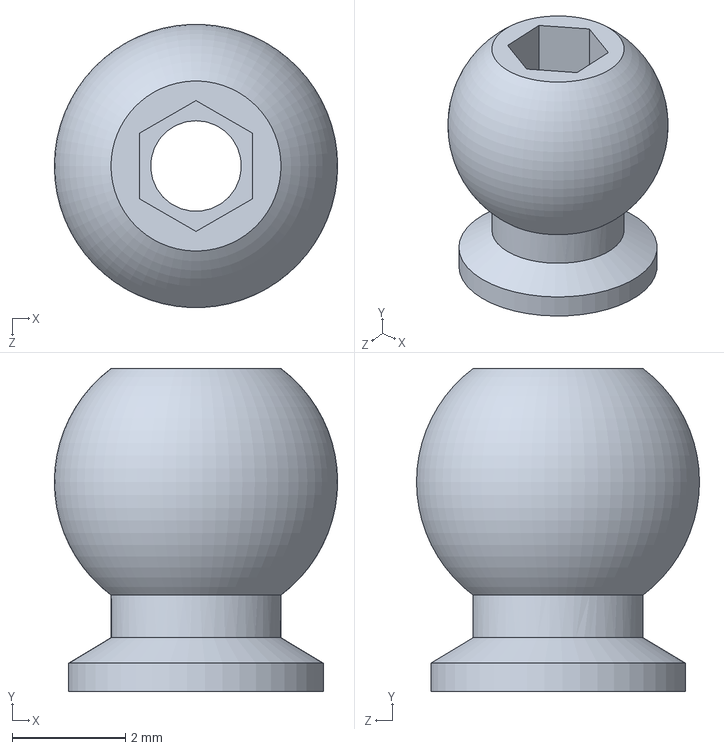
[picture p49: CAD file, 2021-12-12]
model/rod_end.SLDPRT
5.00 x 5.70 x 4.99 mm
