tomwym/oreo_mpc/model/vesa_mount.SLDPRT

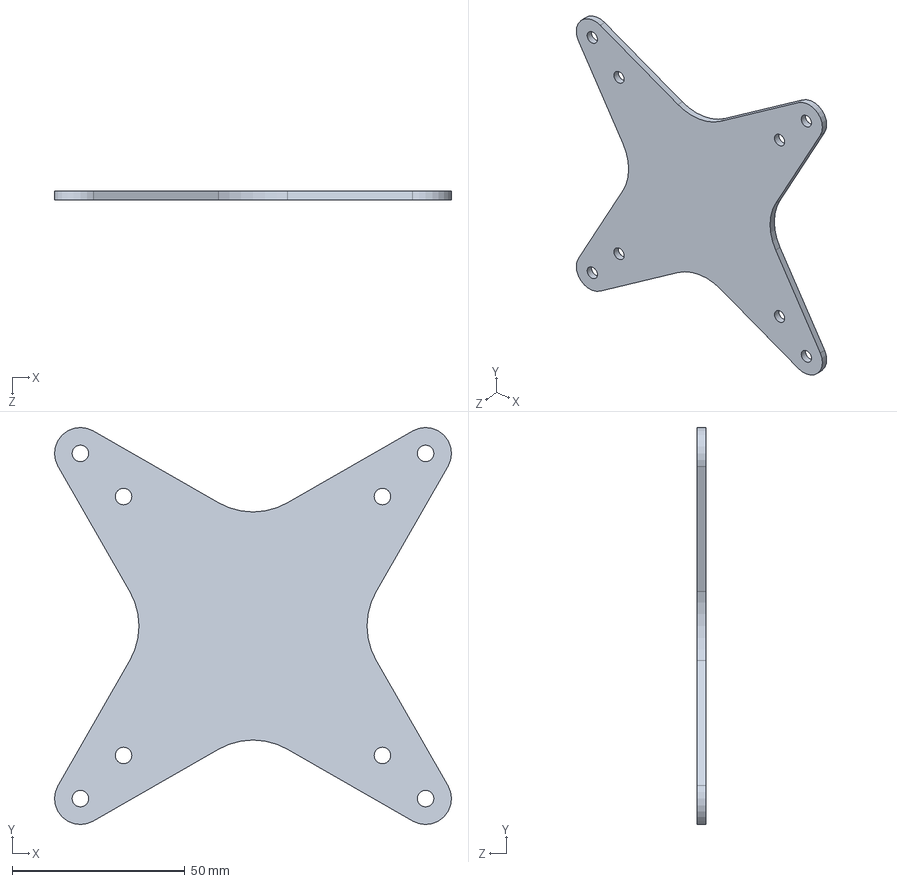
[picture p50: CAD file, 2021-12-12]
model/vesa_mount.SLDPRT
115.0 x 115.0 x 2.60 mm
