tomwym/oreo_mpc/model/1.sldprt

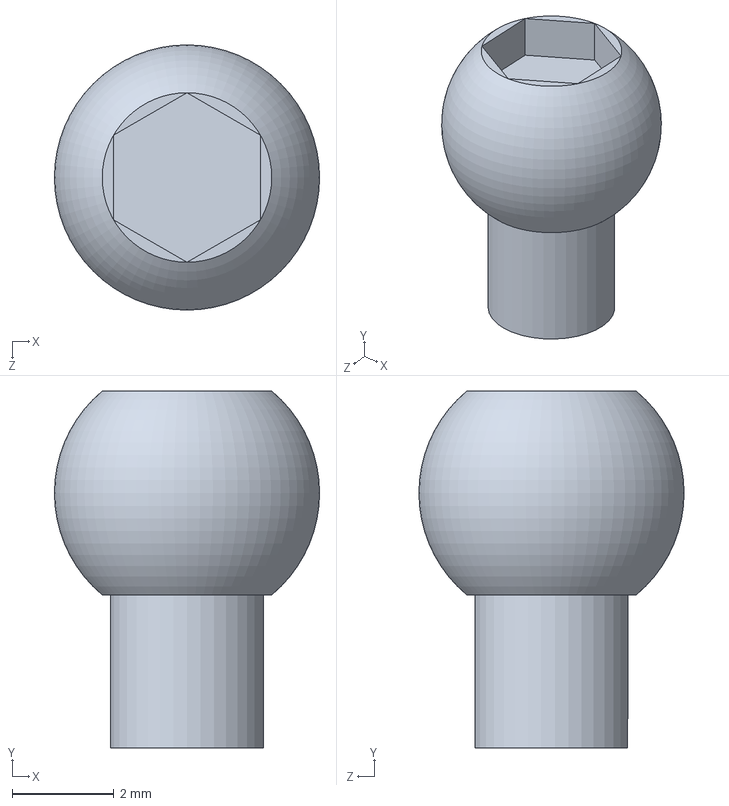
[picture p51: CAD file, 2021-12-12]
model/1.sldprt
5.20 x 7.00 x 5.20 mm
