tomwym/oreo_mpc/model/pitch_link.SLDPRT

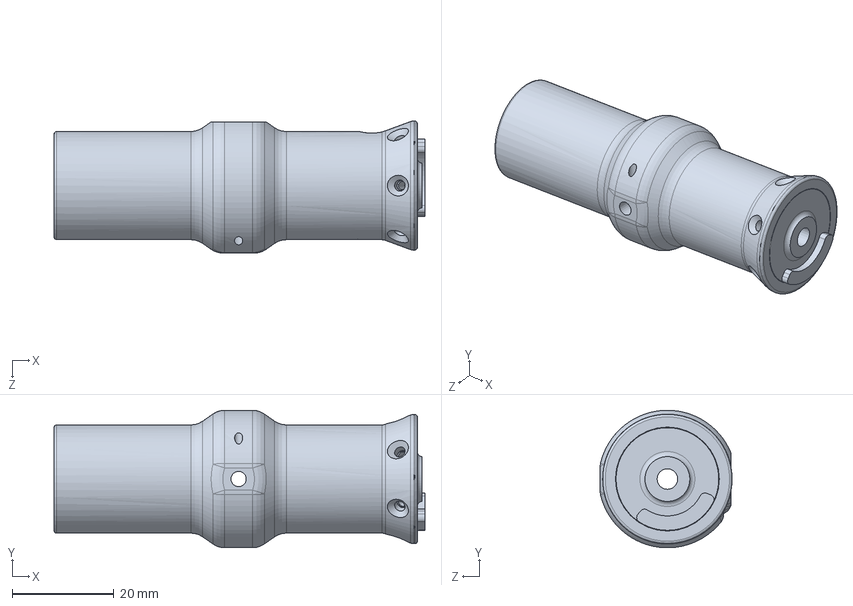
[picture p52: CAD file, 2021-12-12]
model/pitch_link.SLDPRT
72.8 x 27.0 x 25.9 mm
