tomwym/oreo_mpc/model/HUBDISK-1-5000-250-IE.SLDPRT

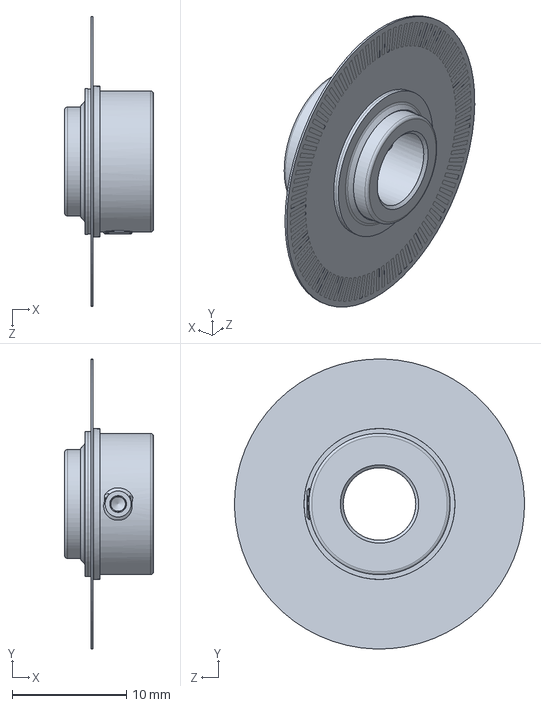
[picture p53: CAD file, 2021-12-12]
model/HUBDISK-1-5000-250-IE.SLDPRT
7.80 x 25.4 x 25.4 mm
