tomwym/oreo_mpc/model/camera_keepout.SLDPRT

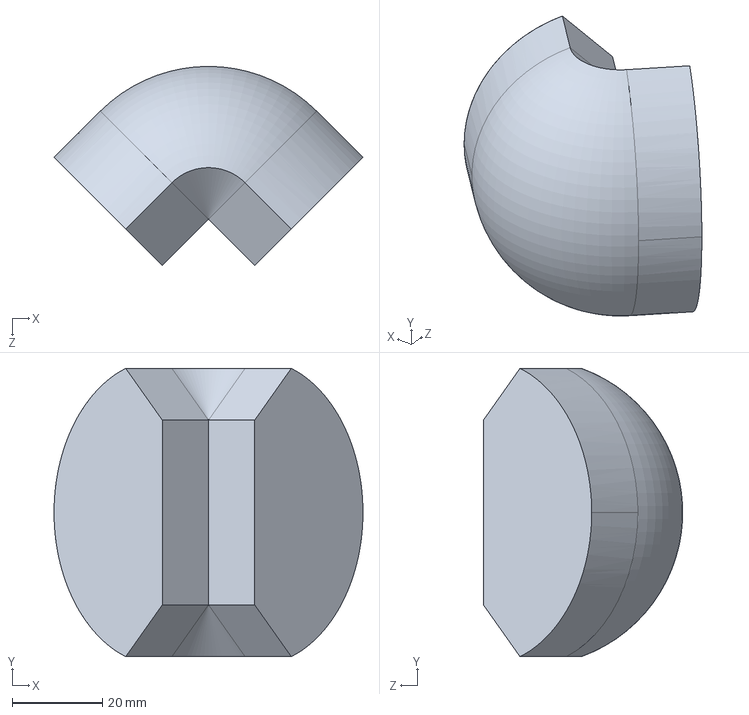
[picture p54: CAD file, 2021-12-12]
model/camera_keepout.SLDPRT
68.6 x 64.0 x 44.2 mm
