tomwym/oreo_mpc/model/2.sldprt

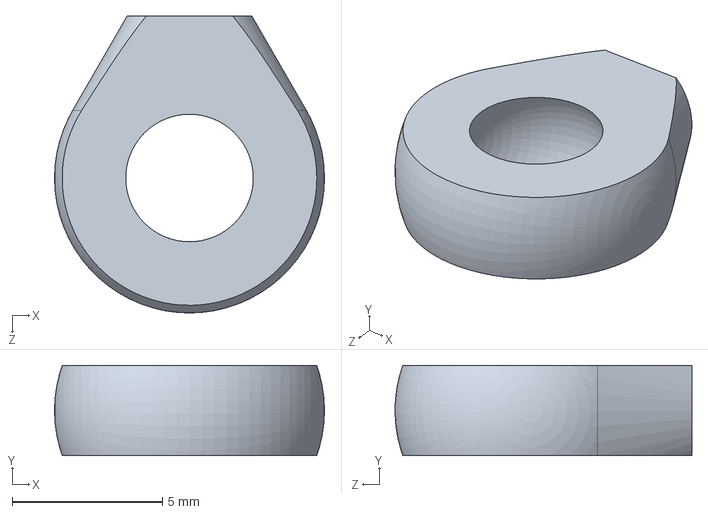
[picture p55: CAD file, 2021-12-12]
model/2.sldprt
9.00 x 3.00 x 9.90 mm
