tomwym/oreo_mpc/model/encoder_disk.SLDPRT

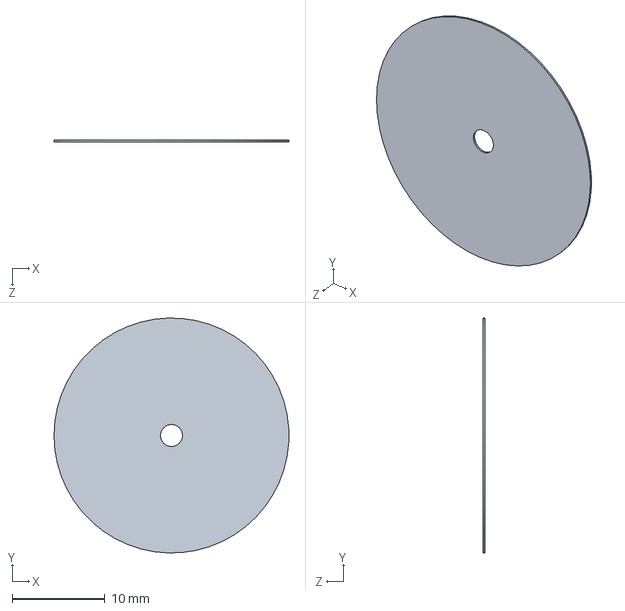
[picture p56: CAD file, 2021-12-12]
model/encoder_disk.SLDPRT
25.4 x 25.4 x 0.178 mm
