tomwym/oreo_mpc/model/yaw_shaft.SLDPRT

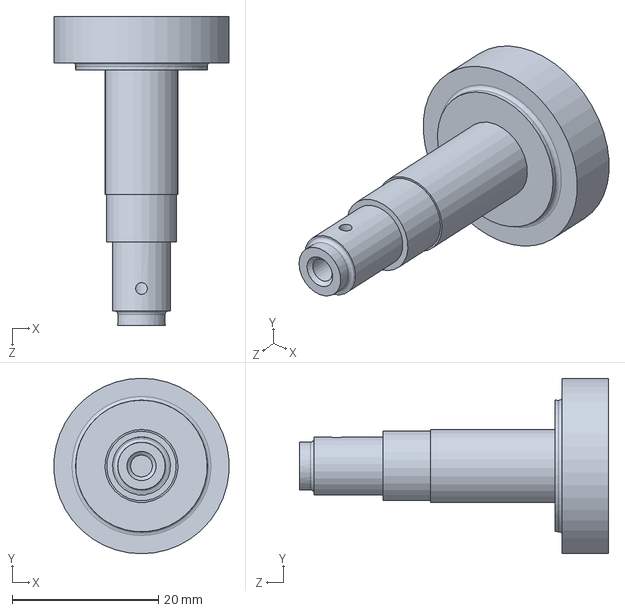
[picture p57: CAD file, 2021-12-12]
model/yaw_shaft.SLDPRT
23.9 x 24.0 x 42.3 mm
