tomwym/oreo_mpc/model/vesa_flange.SLDPRT

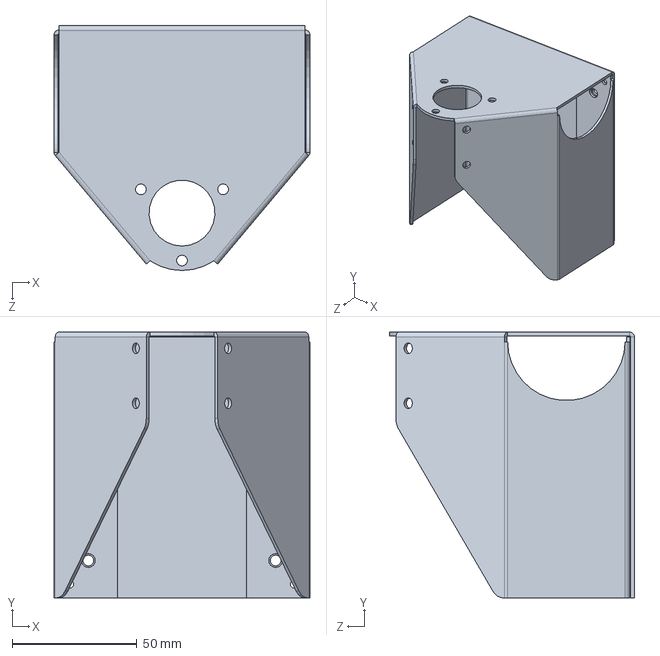
[picture p58: CAD file, 2021-12-12]
model/vesa_flange.SLDPRT
102.5 x 106.5 x 98.2 mm
