tomwym/oreo_mpc/model/lens.SLDPRT

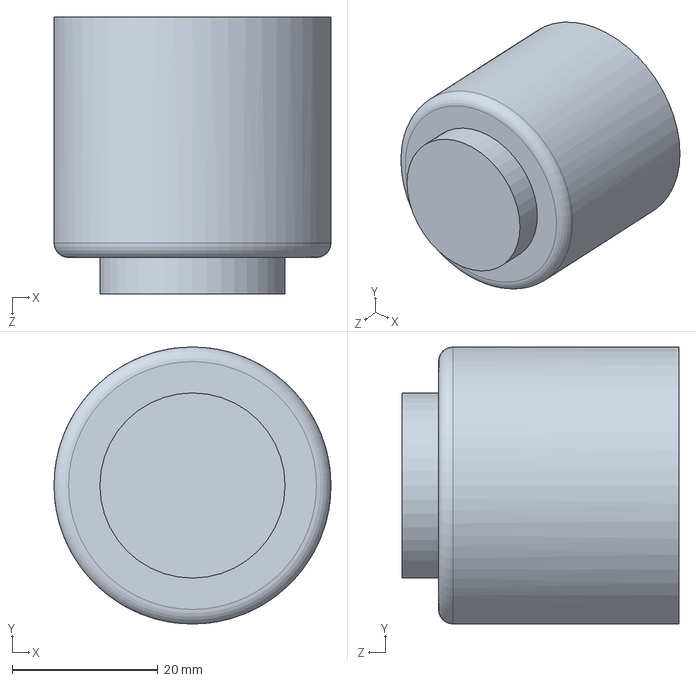
[picture p59: CAD file, 2021-12-12]
model/lens.SLDPRT
38.0 x 38.0 x 38.0 mm
