tomwym/oreo_mpc/model/EM1-X-X.SLDPRT

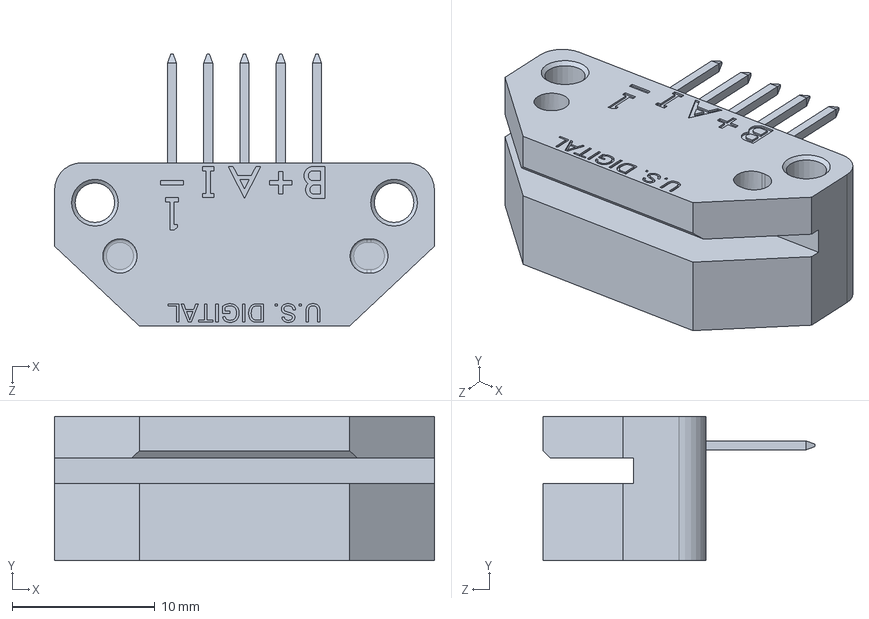
[picture p60: CAD file, 2021-12-12]
model/EM1-X-X.SLDPRT
26.6 x 10.1 x 19.1 mm
