tomwym/oreo_mpc/model/dogbone_spacer.SLDPRT

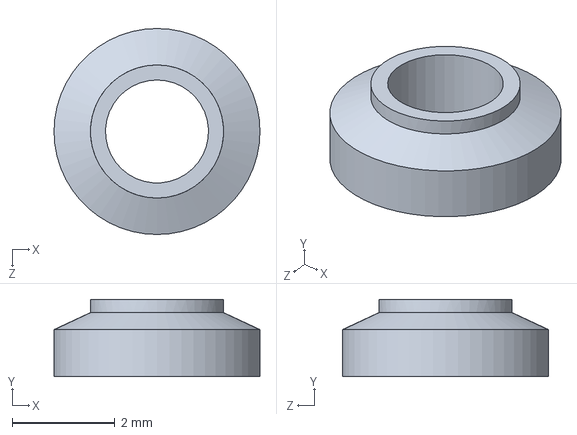
[picture p61: CAD file, 2021-12-12]
model/dogbone_spacer.SLDPRT
4.00 x 1.50 x 4.00 mm
