tomwym/oreo_mpc/model/frame_plate.SLDPRT

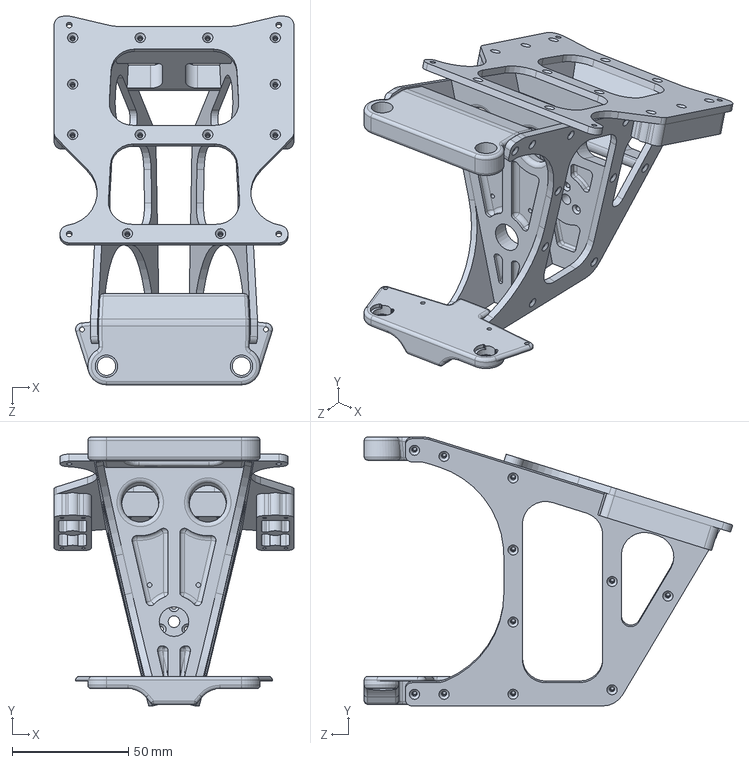
[picture p62: CAD file, 2021-12-12]
model/frame_plate.SLDPRT
103.0 x 115.5 x 158.3 mm
