tomwym/oreo_mpc/model/pushrod.SLDPRT

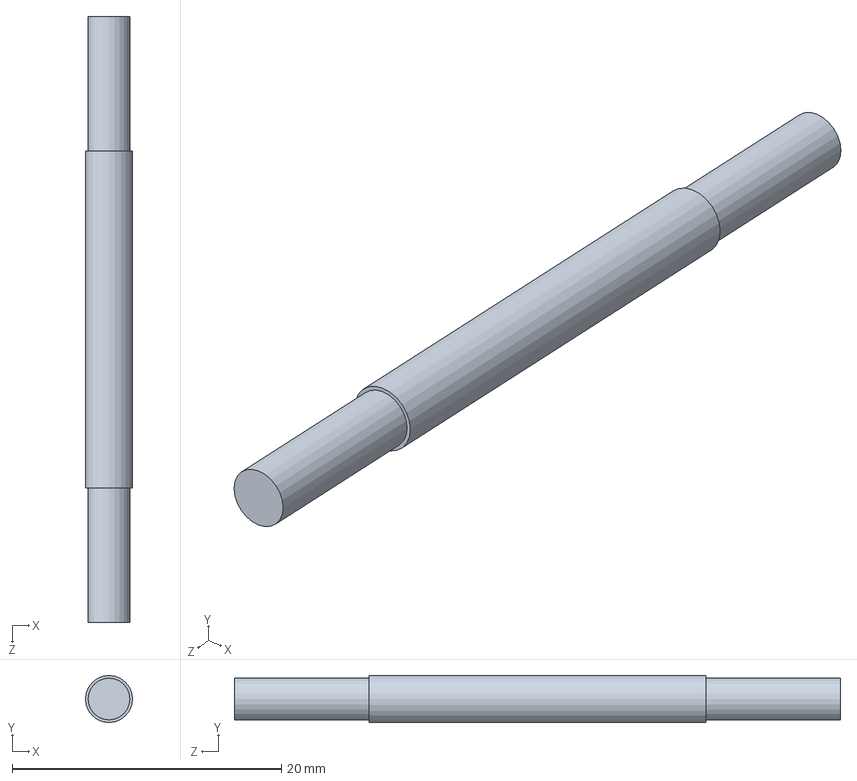
[picture p63: CAD file, 2021-12-12]
model/pushrod.SLDPRT
3.50 x 3.50 x 45.0 mm
