tomwym/oreo_mpc/model/rod_end_2.SLDPRT

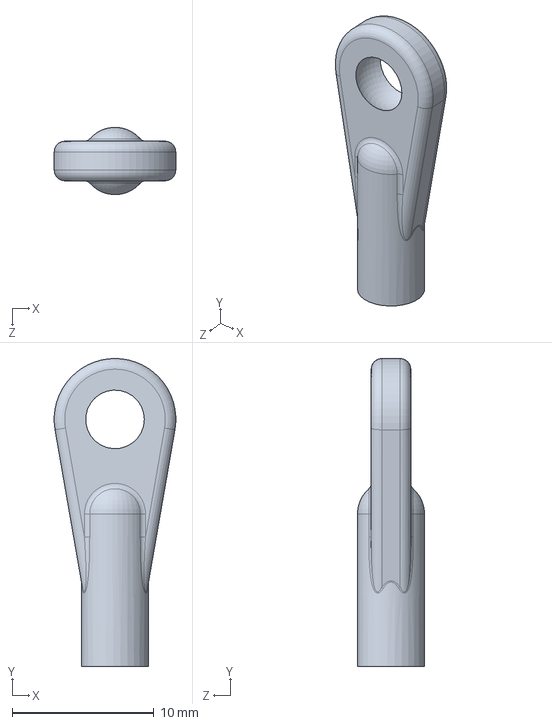
[picture p64: CAD file, 2021-12-12]
model/rod_end_2.SLDPRT
8.59 x 21.8 x 4.74 mm
