tomwym/oreo_mpc/model/motor_mount.SLDPRT

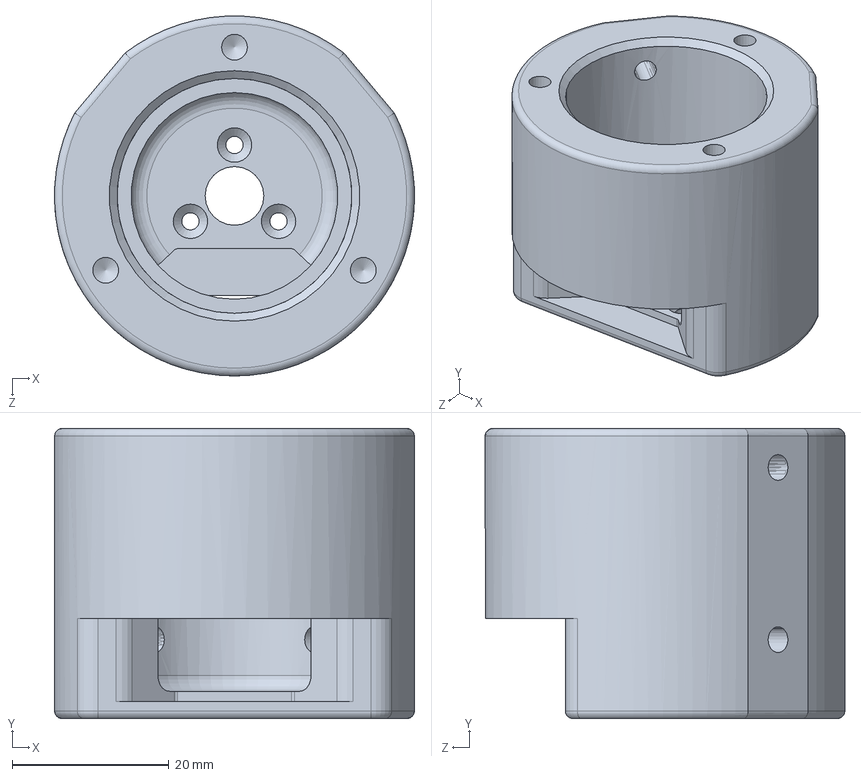
[picture p65: CAD file, 2021-12-12]
model/motor_mount.SLDPRT
46.0 x 37.1 x 46.0 mm
