tomwym/oreo_mpc/model/HUBDISK-1-5000-313-IE.SLDPRT

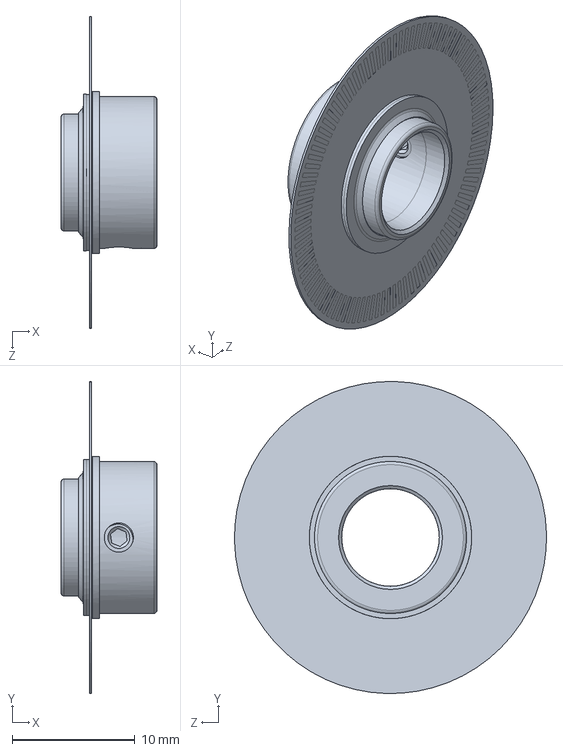
[picture p66: CAD file, 2021-12-12]
model/HUBDISK-1-5000-313-IE.SLDPRT
7.80 x 25.4 x 25.4 mm
