tomwym/oreo_mpc/model/iPOS360xMulti.SLDPRT

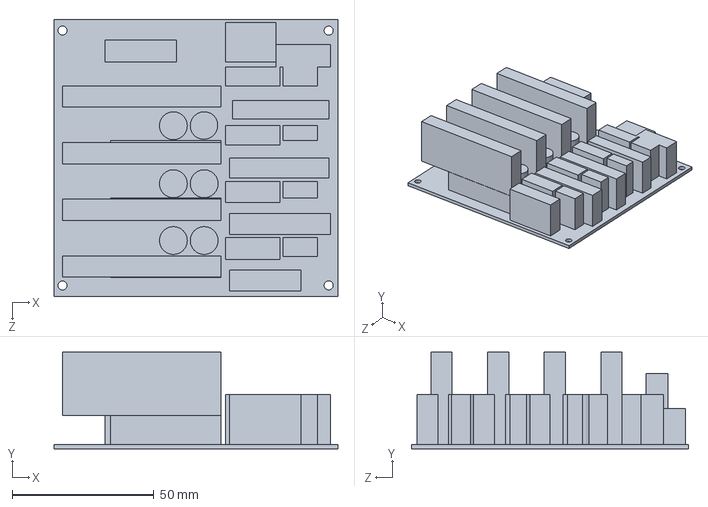
[picture p67: CAD file, 2021-12-12]
model/iPOS360xMulti.SLDPRT
100.3 x 34.2 x 98.0 mm
