tomwym/oreo_mpc/model/dogbone_link.SLDPRT

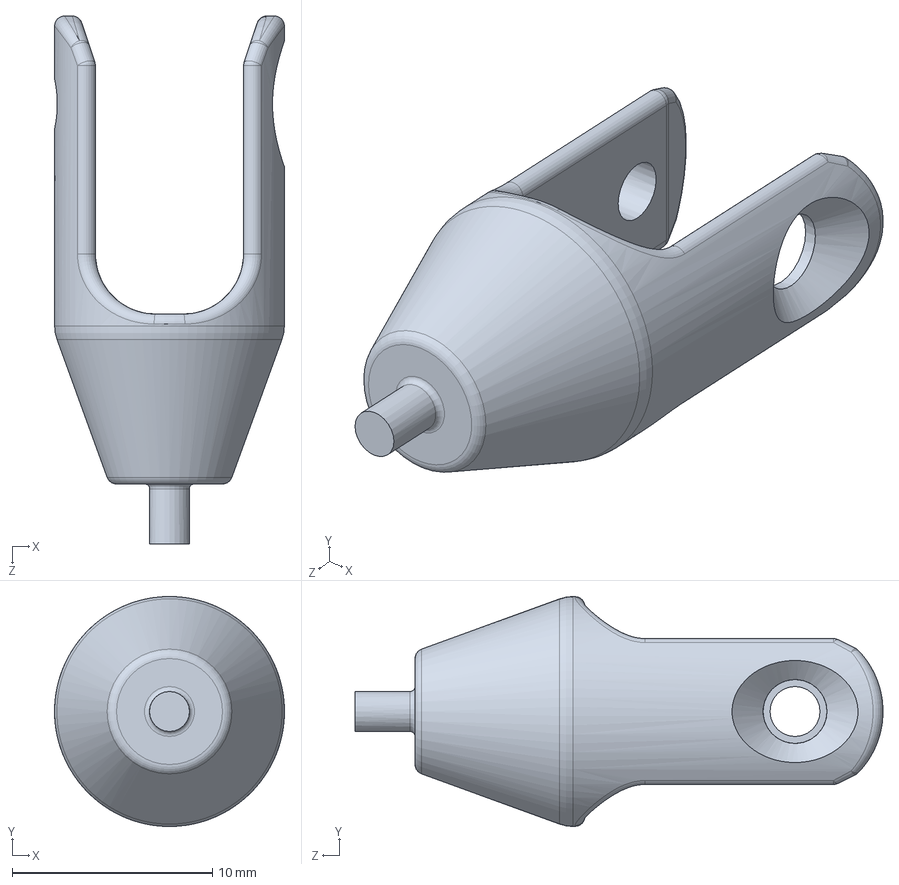
[picture p68: CAD file, 2021-12-12]
model/dogbone_link.SLDPRT
11.5 x 11.5 x 26.4 mm
