tomwym/oreo_mpc/model/fov.SLDPRT

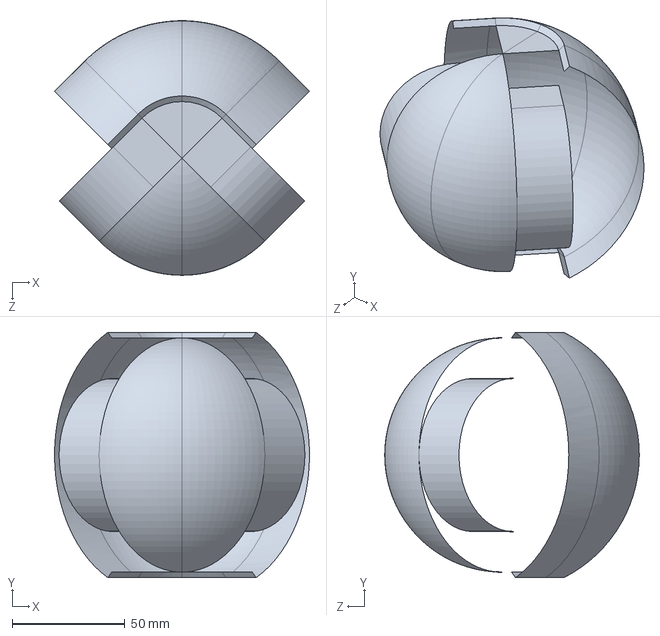
[picture p69: CAD file, 2021-12-12]
model/fov.SLDPRT
113.2 x 108.9 x 113.0 mm
