tomwym/oreo_mpc/(list of files, cad)

Other CAD files:
model/estop/A22E_S_01.SLDASM
stl/right_eye_yolk_asm.STL
model/estop/A22_02M.SLDASM
model/maxon16dxl/maxon_PN_B75AECFD27A3_8_2.sldprt
model/USBFIREWIRE_COM-MCBR3/USBFIREWIRE_COM-MCBR3.SLDPRT
model/maxon16dxl/maxon_PN_B75AECFD27A3_7_2.sldprt
model/maxon16dxl/maxon_PN_B75AECFD27A3_4.sldprt
model/LM_1247/LM1247_xxx_xx_Housing.sldprt
model/maxon16dxl/maxon_PN_B75AECFD27A3_4_2.sldprt
model/maxon16dxl/maxon_PN_B75AECFD27A3_5_2.sldprt
model/maxon16dxl/maxon_PN_B75AECFD27A3_8.sldprt
model/LM_1247/LM1247_040_Rod.sldprt
model/maxon16dxl/maxon_PN_B75AECFD27A3_7.sldprt
model/maxon16dxl/maxon_PN_B75AECFD27A3_6_2.sldprt
model/split_files/frame_plate_side_r.sldprt
model/maxon16dxl/maxon_PN_B75AECFD27A3_3_2.sldprt
model/maxon16dxl/maxon_PN_B75AECFD27A3_2.sldprt
model/maxon16dxl/maxon_PN_B75AECFD27A3_6.sldprt
model/3.sldprt
model/maxon16dxl/maxon_PN_B75AECFD27A3_8_3.sldprt
model/maxon16dxl/maxon_PN_B75AECFD27A3_3.sldprt
model/maxon16dxl/maxon_PN_B75AECFD27A3_5.sldprt
model/maxon16dxl/maxon_PN_B75AECFD27A3_1.sldprt
model/yoke.SLDPRT
model/yaw_link.SLDPRT
model/geometry_45.SLDPRT
model/dogbone_link2.SLDPRT
model/2016_07_13_MFG_RELEASE/pitch_link.SLDDRW
model/2016_07_13_MFG_RELEASE/vesa_flange.SLDDRW
model/2016_07_13_MFG_RELEASE/yaw_link.SLDDRW
model/2016_07_13_MFG_RELEASE/yaw_shaft.SLDDRW
model/2016_07_13_MFG_RELEASE/yoke.SLDDRW
model/24337_Keystone.SLDPRT
model/3088A119.SLDPRT
model/3088A124.SLDPRT
model/3088A229.SLDPRT
model/4262T360.SLDPRT
model/4262T500.SLDPRT
model/6680K110.SLDPRT
model/90318A101.SLDPRT
model/90318A102.SLDPRT
model/90337A197.SLDPRT
model/91239A140.SLDPRT
model/91239A758.SLDPRT
model/91255A075.SLDPRT
model/91292A265.SLDPRT
model/91294A002.SLDPRT
model/91294A003.SLDPRT
model/91294A005.SLDPRT
model/91294A006.SLDPRT
model/91294A009.SLDPRT
model/91294A128.SLDPRT
model/91294A134.SLDPRT
model/91385A201.SLDPRT
model/93625A100.SLDPRT
model/93657A005.SLDPRT
model/94805A217.SLDPRT
model/9520T270.SLDPRT
model/95893A550.SLDPRT
model/9712K510.SLDPRT
model/97648A420.SLDPRT
model/99040A210.SLDPRT
model/LM_1247/LM1247-040-XX.SLDASM
model/LM_1247/LM1247-060-XX.SLDASM
model/drawings/cam_mount.SLDDRW
model/drawings/dogbone_link.SLDDRW
model/drawings/frame.SLDDRW
model/drawings/motor_mount.SLDDRW
model/drawings/pitch_link.SLDDRW
model/drawings/yaw_link.SLDDRW
model/drawings/yaw_shaft.SLDDRW
model/drawings/yoke.SLDDRW
model/estop/A22E_S_01.SLDDRW
model/maxon16dxl/maxon_PN_B75AECFD27A3.sldprt
model/pitch_link.SLDDRW
model/vesa_flange.SLDDRW
model/yaw_link.SLDDRW
model/yaw_shaft.SLDDRW
model/yoke.SLDDRW
stl/dogbone.STL
