tomwym/oreo_mpc/docs/images/em-comm-setup.png

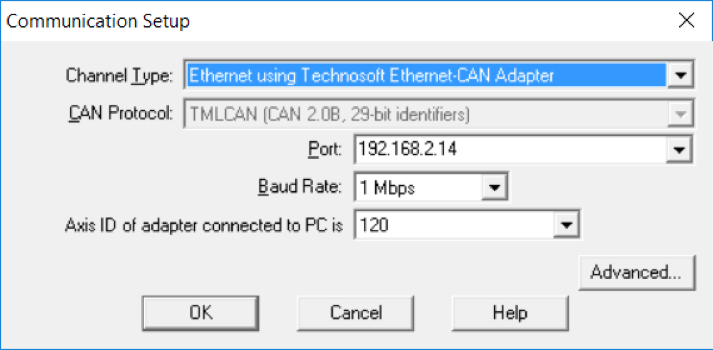
docs/images/em-comm-setup.png
