tomwym/oreo_mpc/code/control/pid.h

#ifndef PID_H
#define PID_H
#include <stdint.h>
#include <stdbool.h>
#include "libmacaque_RS232/macaque_linux.h"

typedef struct _lim_t {
    double high;
    double low;
} lim_t;

typedef void(*setTorqueFn)(uint8_t, double);

typedef struct _pid_param_t {
    double kp;
    double ki;
    double kd;
    lim_t cmd_lim;
    lim_t pos_lim;
} pid_param_t;

typedef struct _pid_loop_t {
    pid_param_t param;
    double errSum;
    double prevErr;
    double prevTime;
    double integ;
} pid_loop_t;

void StartMotion(pid_loop_t* loop, double initTime);
double UpdateLoop(pid_loop_t* loop, double targetPos, double currPos, double time);

#endif
