tomwym/oreo_mpc/sim/oreo.py

import pybullet as p
import time
from scipy.spatial.transform import Rotation as R
import logging
import numpy as np

class Oreo_Robot(object):
    # Class which controls the oreo robot
    # All directions (far_left etc. are from robot's perspective (looking in +ve x-dir))
    # Member Vars
    linkage = 0
    physicsClient = 0
    numJoints = 0
    jointDict = {}                  # map joint name to id
    linkJoints = []                 # map link id to all its joints/constraints
    LINK_PARENT_IDX = 0             # joint ids where link is parent  
    LINK_CHILD_IDX = 1              # joint ids where link is child 
    initPosOrn = []
    POS_IDX = 0
    ORN_IDX = 1
    useRealTime = False
    linkVelo = []
    VELO_IDX = 0
    ANG_VELO_IDX = 1


    numConstraints = 4
    constraintDict = {}
    constraintLinks = [
                        ['left_eye_joint', 'dogbone_joint_far_left', 'constraint_far_left'],
                        ['left_eye_joint', 'dogbone_joint_mid_left', 'constraint_mid_left'],
                        ['right_eye_joint', 'dogbone_joint_mid_right', 'constraint_mid_right'],
                        ['right_eye_joint', 'dogbone_joint_far_right', 'constraint_far_right'], 
                      ]
    CONS_PARENT_IDX = 0
    CONS_CHILD_IDX = 1
    CONS_NAME_IDX = 2
    constraintParentPos = [[0.015, -0.0016, 0.0245], [0.0126, -0.0257, 0.0095],
                           [0.0134, 0.0025, 0.0262], [0.0143, -0.0224, 0.0124]] # pos on eye
    constraintChildPos = [30.25e-3, 0, 0]   # pos on dogbone
    constraintAxis = [0,0,0]
    constraintType = p.JOINT_POINT2POINT

    # Joints modelled with motor
    actJointNames = ["neck_joint", "pitch_piece_joint", "skull_joint",
                     "linear_motor_rod_joint_far_left", "linear_motor_rod_joint_mid_left",
                     "linear_motor_rod_joint_mid_right", "linear_motor_rod_joint_far_right"]
    actJointIds = []
    actJointPos = []
    actJointNum = 0
    actJointHome = 0
    prismaticLim = [-0.1, 0.1]
    revoluteLim = [-1.57, 1.57]
    LIM_MIN_IDX = 0
    LIM_MAX_IDX = 1
    manCtrl = []
    actJointControl = p.POSITION_CONTROL

    # "Dumb" joints with no actuation
    dumbJointNames = ["left_eye_yolk_joint", "left_eye_joint",
                      "right_eye_yolk_joint", "right_eye_joint"]
    dumbJointHome = 0
    dumbJointIds = 0
    dumbJointNum = 0
    dumbJointVelo = 0
    dumbJointControl = p.VELOCITY_CONTROL
    dumbJointForce = 0

    # "Spherical" joints (no actuation)
    spherJointNames = ["dogbone_joint_far_left", "dogbone_joint_mid_left", 
                       "dogbone_joint_mid_right", "dogbone_joint_far_right"]
    spherJointHome = [[0, 0, 0.00427], [0, 0, 0.00427], [0, 0, 0.00427],
                      [0, 0, -0.00427], [0, 0, -0.00427]]
    spherJointIds = []
    spherJointNum = 0
    spherJointPos = [0]
    spherJointVelo = [0,0,0]
    spherJointControl = p.POSITION_CONTROL
    spherJointKp = 0
    spherJointKv = 1
    spherJointForce = [0,0,0]

    # Links which have collisions disabled
    disCollisionLinks = [
        ['dogbone_joint_far_left', 'left_eye_joint'],
        ['dogbone_joint_mid_left', 'left_eye_joint'],
        ['dogbone_joint_mid_right', 'right_eye_joint'],
        ['dogbone_joint_far_right', 'right_eye_joint'],
        ['dogbone_joint_far_left', 'left_eye_yolk_joint'],
        ['dogbone_joint_mid_left', 'left_eye_yolk_joint'],
        ['dogbone_joint_mid_right', 'right_eye_yolk_joint'],
        ['dogbone_joint_far_right', 'right_eye_yolk_joint'],
    ]
    
    # Links with collisions enabled
    toggCollisionLinks = [
        ['left_eye_joint', 'right_eye_joint'],
        ['left_eye_yolk_joint', 'right_eye_yolk_joint'],
        ['left_eye_yolk_joint', 'right_eye_joint'],
        ['right_eye_yolk_joint', 'left_eye_joint'],
        ['skull_joint', 'pitch_piece_joint'],
        ['dogbone_joint_far_right', 'pitch_piece_joint'],
        ['dogbone_joint_far_left', 'pitch_piece_joint']

    ]
    
    # Registered key events to look for
    keys = []

    # Constants
    INIT_POS = [0,0,0]
    INIT_ORN = [0,0,0]
    CONSTRAINT_MAX_FORCE = 10000000
    JOINT_MAX_FORCE = 100
    TORQUE_CONTROL = 0
    POSITION_CONTROL = 1
    TIME_STEP = 1/360
    DYN_STATE_SIZE = 6
    GRAV_ACCELZ = -9.8


    # Constructor
    def __init__(self, enableDebug, enableGUI, urdfPath, urdfName, enableRealTime ,dt) :
        # Init logging
        if(enableDebug) :
            logging.basicConfig(level=logging.DEBUG, format='%(levelname)s:%(message)s')
            logging.info('LOG_LEVEL: DEBUG')
        else :
            logging.basicConfig(level=logging.INFO, format='%(levelname)s:%(message)s')
            logging.info('LOG_LEVEL: INFO')
    
        # Setup environment
        if(enableGUI) :
            self.physicsClient = p.connect(p.GUI)
        else :
            self.physicsClient = p.connect(p.DIRECT)
        p.setAdditionalSearchPath(urdfPath)
        urdf_flags = p.URDF_USE_INERTIA_FROM_FILE | p.URDF_MAINTAIN_LINK_ORDER | p.URDF_ENABLE_CACHED_GRAPHICS_SHAPES | p.URDF_USE_SELF_COLLISION | p.URDF_USE_SELF_COLLISION_EXCLUDE_ALL_PARENTS
        self.linkage = p.loadURDF(urdfName, self.INIT_POS, p.getQuaternionFromEuler(self.INIT_ORN), useFixedBase = 1, flags = urdf_flags)
        self.useRealTime = enableRealTime
        self.TIME_STEP = dt

    # Go to home position
    def HomePos(self) :
        p.setRealTimeSimulation(0)
        # Reset dumb joint positions
        for dumb_idx in range(self.dumbJointNum) :
            p.resetJointState(self.linkage, self.dumbJointIds[dumb_idx], targetValue = self.dumbJointHome)
        
        # Reset actuated joint positions
        for act_idx in range(self.actJointNum) :
            p.resetJointState(self.linkage, self.actJointIds[act_idx], targetValue = self.actJointHome)
        
        # Update position list
        self.actJointPos = [self.actJointHome]*self.actJointNum

        # Reset spherical joints
        for spher_idx in range(self.spherJointNum) :
            p.resetJointStateMultiDof(self.linkage, self.spherJointIds[spher_idx], targetValue = self.spherJointHome[spher_idx])

    # Enable/Disable collision
    def ToggleCollision(self, enable):
        # Turn off some collisions
        for j in range(len(self.disCollisionLinks)) :
            p.setCollisionFilterPair(self.linkage, self.linkage, self.jointDict[self.disCollisionLinks[j][0]], self.jointDict[self.disCollisionLinks[j][1]], 0)
        
        if enable > 0:
            logging.debug("Collision enabled")
            enable = 1
        else :
            logging.debug("Collision disabled")
            enable = 0
        for i in range(len(self.toggCollisionLinks)) :
            p.setCollisionFilterPair(bodyUniqueIdA = self.linkage, bodyUniqueIdB = self.linkage, linkIndexA = self.jointDict[self.toggCollisionLinks[i][0]], linkIndexB = self.jointDict[self.toggCollisionLinks[i][1]], enableCollision = 1)
            if enable > 0:
                logging.debug("Collision pair: %s %s", self.toggCollisionLinks[i][0], self.toggCollisionLinks[i][1])
        print()
    
    # Toggle Sim type
    def SetSimType(self, realTime) :
        # Set sim type
        if realTime:
            self.useRealTime = True
            p.setRealTimeSimulation(1)
            logging.debug("Setting real time sim")
        else :
            self.useRealTime = False
            p.setRealTimeSimulation(0)
            p.setTimeStep(self.TIME_STEP)
            logging.debug("Setting step sim with timestep %f", self.TIME_STEP)
    
    # Reset actuated joint control
    def ResetActJointControl(self) :
        # Must set to velocity control with 0 velocity and 0 force to "reset"
        p.setJointMotorControlArray(self.linkage, self.actJointIds, p.VELOCITY_CONTROL, forces = [0]*self.actJointNum)

    # Initialize robot for position control
    def InitPosnCtrl(self) :
        self.SetActJointControlType(self.POSITION_CONTROL)
        self.ResetActJointControl()
        self.ControlActJoints([0]*self.actJointNum)

    # Initialize robot for torque control
    def InitTorqueCtrl(self) :
        self.SetActJointControlType(self.TORQUE_CONTROL)
        self.ResetActJointControl()
        self.ControlActJoints([0]*self.actJointNum)  

    # Set actuated joint control type
    def SetActJointControlType(self, ctrl_type) :
        if ctrl_type == self.TORQUE_CONTROL :
            self.actJointControl = p.TORQUE_CONTROL
            logging.debug("Set torque control")
            # Must be step sim for torque control
            self.SetSimType(False)
        else :
            self.actJointControl = p.POSITION_CONTROL
            logging.debug("Set position control")

    # Set joint control for actuators
    def ControlActJoints(self, control) :
        target = []
        links = []
        if isinstance(control, list) :
            for idx in range(len(control)) :
                target.append(control[idx])
            links = self.actJointIds
        elif isinstance(control, dict) :
            for name in control :
                if name in self.actJointNames:
                    target.append(control[name])
                    links.append(self.jointDict[name])
                else :
                    logging.warning("Unknown dict key in control input for ControlActJoints")
        else :
            logging.error("Unknown control input type")

        if self.actJointControl == p.POSITION_CONTROL :
            p.setJointMotorControlArray(self.linkage, links, self.actJointControl, targetPositions = target, forces = [self.JOINT_MAX_FORCE]*len(target))
        elif self.actJointControl == p.TORQUE_CONTROL :
            p.setJointMotorControlArray(self.linkage, links, self.actJointControl, forces = target)

        # Update simulation
        if self.useRealTime == False :
            p.stepSimulation()

        #print('in ControlActJoints', 'links:', links, 'forces:', target)

        return 0

    # Set joint control for dumb joints
    def ControlDumbJoints(self) :
        p.setJointMotorControlArray(self.linkage, self.dumbJointIds, self.dumbJointControl, targetVelocities = [self.dumbJointVelo]*self.dumbJointNum, forces = [self.dumbJointForce]*self.dumbJointNum)

    # Set joint control for spherical joints
    def ControlSpherJoints(self) :
        p.setJointMotorControlMultiDofArray(self.linkage, self.spherJointIds, self.spherJointControl, targetPositions = [self.spherJointPos]*self.spherJointNum, targetVelocities = [self.spherJointVelo]*self.spherJointNum, forces = [self.spherJointForce]*self.spherJointNum, positionGains = [self.spherJointKp]*self.spherJointNum, velocityGains = [self.spherJointKv]*self.spherJointNum)

    # Init manual control
    def InitManCtrl(self) :
        self.InitPosnCtrl()
        for idx in range(self.actJointNum) :
            name = self.actJointNames[idx]
            if "linear" in name:
                self.manCtrl.append(p.addUserDebugParameter(name, self.prismaticLim[self.LIM_MIN_IDX], self.prismaticLim[self.LIM_MAX_IDX]))
            else :
                self.manCtrl.append(p.addUserDebugParameter(name, self.revoluteLim[self.LIM_MIN_IDX], self.revoluteLim[self.LIM_MAX_IDX]))

    # Update manual control
    def UpdManCtrl(self) :
        pos = [0]*self.actJointNum
        for idx in range(len(self.manCtrl)) :
            pos[idx] = p.readUserDebugParameter(self.manCtrl[idx])
        self.ControlActJoints(pos)
        self.actJointPos = pos

    # Initialize robot model
    def InitModel(self) :
        # Map names to id
        self.numJoints = p.getNumJoints(self.linkage)
        logging.info("There are %d links in file\n", self.numJoints)
        vis_data = p.getVisualShapeData(self.linkage)
        for i in range(self.numJoints):
            # map joint names to id (same mapping for links)
            jointInfo = p.getJointInfo(self.linkage, i)
            self.jointDict[jointInfo[1].decode('UTF-8')] = i

            # record parent and child ids for each joint [child, parent]
            # self.linkJoints.append([[jointInfo[16]], [i]])
            # ignore the dummy link
            # if(i > 0) :
            # self.linkJoints[jointInfo[16]][self.LINK_PARENT_IDX].append(jointInfo[16])

            # measure force/torque at the joints
            p.enableJointForceTorqueSensor(self.linkage, i, enableSensor = True)

            # Store initial positions and orientations
            state = p.getLinkState(self.linkage, jointInfo[0])
            self.initPosOrn.append([state[4], state[5]])

            # debugging            
            coll_data = p.getCollisionShapeData(self.linkage, i)
            logging.debug("%s %d", jointInfo[1].decode('UTF-8'), i)
            logging.debug("com frame (posn (global) & orn (global)) %s %s", str(state[0]), str(p.getEulerFromQuaternion(state[1])))
            logging.debug("inertial offset (posn (link frame), orn (link frame)) %s %s", str(state[2]), str(p.getEulerFromQuaternion(state[3])))
            logging.debug("link frame (posn (global), orn (global)) %s %s", str(state[4]), str(p.getEulerFromQuaternion(state[5])))
            logging.debug("type %s", str(jointInfo[2]))
            logging.debug("axis %s", str(jointInfo[13]))
            logging.debug("collision (posn (COM frame), orn(COM frame)) %s %s", str(coll_data[0][5]), str(p.getEulerFromQuaternion(coll_data[0][6])))
            logging.debug("visual (posn (link frame), orn(link frame)) %s %s\n\n", str(vis_data[i][5]), str(p.getEulerFromQuaternion(vis_data[i][6])))
    
        # Create list of actuated joints
        self.actJointIds = [self.jointDict[act_name] for act_name in self.actJointNames]
        self.actJointNum = len(self.actJointNames)
        
        # Create list of spherical joints
        self.spherJointIds = [self.jointDict[spher_name] for spher_name in self.spherJointNames]
        self.spherJointNum = len(self.spherJointNames)

        # Create list of dumb joints
        self.dumbJointIds = [self.jointDict[dumb_name] for dumb_name in self.dumbJointNames]
        self.dumbJointNum = len(self.dumbJointNames)

        # Init struct
        self.linkVelo = [[0,0,0],[0,0,0]]*p.getNumJoints(self.linkage)

        # Enable collision by default
        self.ToggleCollision(1)

        # Go to home position
        self.HomePos()

        # Constraints
        for i in range(self.numConstraints):
            parent_id = self.jointDict[self.constraintLinks[i][self.CONS_PARENT_IDX]]
            child_id = self.jointDict[self.constraintLinks[i][self.CONS_CHILD_IDX]]
            self.constraintDict[self.constraintLinks[i][self.CONS_NAME_IDX]] =  p.createConstraint(self.linkage, parent_id, self.linkage, child_id, self.constraintType, self.constraintAxis, self.constraintParentPos[i],  self.constraintChildPos)
            p.changeConstraint(self.constraintDict[self.constraintLinks[i][self.CONS_NAME_IDX]], maxForce = self.CONSTRAINT_MAX_FORCE)

            # Add to linkJoint list (make constraints -ve ids)
            # self.linkJoints[parent_id][self.LINK_PARENT_IDX].append(parent_id*-1)
            # self.linkJoints[child_id][self.LINK_CHILD_IDX].append(child_id*-1)

        # Set joint control
        self.SetActJointControlType(self.POSITION_CONTROL)
        self.ResetActJointControl()
        self.ControlDumbJoints()
        self.ControlSpherJoints()

        # Gravity
        p.setGravity(0,0,self.GRAV_ACCELZ)

        # Simulation type
        self.SetSimType(self.useRealTime)
    
    # Check if links have collided
    def CheckCollision(self, linkA, linkB) :
        points = p.getContactPoints(bodyA = self.linkage, bodyB = self.linkage, linkIndexA = self.jointDict[linkA], linkIndexB = self.jointDict[linkB])
        if not points :
            logging.debug("No collision points between %s & %s detected\n", linkA, linkB)
            return False
        else :
            logging.debug("Number of collision points between %s & %s detected: %d\n", linkA, linkB, len(points))
            return True
        print()
        print()
    
    # Check all contact points
    def CheckAllCollisions(self) :
        points=p.getContactPoints()
        logging.debug("Contact Points")
        for temp in points :
            logging.debug("a & b = %d & %d", temp[3], temp[4])
        print()
        print()        

    # Get list of keys pressed
    def GetKeyEvents(self) :
        pressed = []
        keyEvents = p.getKeyboardEvents()
        for char in self.keys :
            key = ord(char)
            if key in keyEvents and keyEvents[key]&p.KEY_WAS_TRIGGERED :
                pressed.append(char)
        return pressed  

    # Add key to listen
    def RegKeyEvent(self, userIn) :
        if isinstance(userIn, str) :
            if userIn not in self.keys :
                self.keys.append(userIn)
        elif isinstance(userIn, list) :
            for char in userIn :
                if char not in self.keys :
                    self.keys.append(char)

    # Cleanup stuff
    def Cleanup(self) :
        p.disconnect()
    
    # Reset robot
    def Reset(self) :
        p.resetSimulation()
        self.InitModel()
    
    # Get list of joint names
    def GetJointNames(self) :
        return list(self.jointDict.keys())
    
    # Get list of link names
    def GetLinkNames(self) :
        return [name.replace("joint", "link", 1) for name in self.jointDict.keys()]

    # Print constraint reaction forces
    def PrintConstraintDynamics(self) :
        logging.debug("Constraint States")
        for cons_id in self.constraintDict :
            logging.debug(p.getConstraintState(self.constraintDict[cons_id]))
        print()
        print()
    
    # Update link velo
    def UpdateAllLinkAccel(self) :
        id_list = list(range(p.getNumJoints(self.linkage)))
        ret = p.getLinkStates(self.linkage, id_list, computeLinkVelocity = 1)
        idx = 0
        for state in ret :
            self.linkVelo[idx] = [list(state[6]), list(state[7])]
            idx+=1

    # Print link approx accel at last time step
    def PrintLinkAccel(self) :
        logging.info("Link Dynamics")
        id_list = list(range(p.getNumJoints(self.linkage)))
        ret = p.getLinkStates(self.linkage, id_list, computeLinkVelocity = 1)
        idx = 0
        for state in ret :
            accel = list(self.linkVelo[idx][self.VELO_IDX])
            ang_accel = list(self.linkVelo[idx][self.ANG_VELO_IDX])
            for i in range(len(accel)) :
                accel[i] = (state[6][i] - accel[i])/self.TIME_STEP
                ang_accel[i] = (state[7][i] - ang_accel[i])/self.TIME_STEP
            logging.debug("Id=%d accel=%s ang_accel=%s", idx, str(accel), str(ang_accel))
            self.linkVelo[idx] = [list(state[6]), list(state[7])]
            idx+=1
        print()
        print()   

    # Compute approx accelerations of the link at last time step
    def GetLinkAccel(self, name) :
        # check if given link name (link == joint)
        if "link" in name :
            name.replace("link", "joint", 1)

        # Check link exists
        if name in self.jointDict :
            ret = p.getLinkState(self.linkage, self.jointDict[name], computeLinkVelocity = 1)
            accel = self.linkVelo[linkId][self.VELO_IDX]
            ang_accel = self.linkVelo[linkId][self.ANG_VELO_IDX]
            linkId = self.jointDict[name]
            for i in range(len(accel)) :
                accel = (accel[i] - ret[6][i]) / self.TIME_STEP
                ang_accel = (ang_accel[i] - ret[7][i]) / self.TIME_STEP
            self.linkVelo[linkId] = [ret[6], ret[7]]
        else :
            logging.error("Unknown name input to GetLinkAccel")
            return []
        
        return [list(accel), list(ang_accel)]

    # Get the position and orientation
    def GetLinkPosOrn(self, name) :
        # check if given link name (link == joint)
        if "link" in name :
            name.replace("link", "joint", 1)
        idx = self.jointDict[name]
        # Check link exists
        if name in self.jointDict :
            state = p.getLinkState(self.linkage, idx, computeForwardKinematics = True)
            pos = list(np.array(state[4]) - np.array(self.initPosOrn[idx][self.POS_IDX]))
            #orn = np.array(state[5]) - self.initPosOrn[idx][self.ORN_IDX]
            orn = p.getDifferenceQuaternion(self.initPosOrn[idx][self.ORN_IDX], state[5])
            logging.debug("%s pos=%s orn=%s", name, str(pos), str(p.getEulerFromQuaternion(orn)))
        else :
            logging.error("Unknown name input to GetLinkPosOrn")
            return []
        return [pos, orn]
        
        
    
#    # TODO
#    # Find equivalent force-moment couple (through COM)
#    def TranslateForce(self, force) :
#        logging.debug("Force translations")
    
#    # Get contact forces
#    #TODO
#   def GetLinkContactForces(self, idx) :
#        # Compute collision forces
#        collisions = p.getContactPoints(bodyA = self.linkage, linkIndexA = idx)
#        for info in collisions :
#            orn = info[7]
#            force = info[9]
    
#    # Get force/torque in world coordinates
#    def CalcForceTorqueWorld(self, magn, idx) :
#        info = p.getJointInfo(self.linkage, idx)
#        #axis = info[]
#
#    # Sum all forces/moments on link at last time step
#    # TODO
#   def GetLinkTotalDynamics(self, name) :
#        logging.debug("Getting total force")
#        info = np.zeros(6)   # [Fx,Fy,Fz,Mx,My,Mz]

#        # Check if given link name (link == joint)
#        if "link" in name :
#            name.replace("link", "joint", 1)
        
#        # Make sure valid
#        if name not in self.jointDict :
#            logging.error("Unknown name input to GetLinkTotalForceMom")
#            return list(info)
#        
#        # Potential sources: joint/constraint rxn (when child & parent), contact, applied, gravity
#        # Go through linkJoint list
#        linkId = self.jointDict[name]
#        joints = self.linkJoints[linkId] # holds joint ids involving this link
#        
#        # Joints where link is parent
#        for num in range(len(joints)) :
#            # Need to switch direction of rxn force for parent
#            mult = 1
#            if num == self.LINK_PARENT_IDX :
#                mult = -1
#            for i in joints[num] :
#                if i >= 0:
#                    # Reg joint
#                    # Get applied/rxn force/torque
#                    ret = []
#                    if i in self.actJointIds :
#                        # Rxn forces
#                        ret = p.getJointState(self.linkage, i)
#                       dynamics = np.add(dynamics, np.array(ret[2])*mult)
#
#                        # Applied force/torque
#                        
#                    else :
#                        # Rxn force/torque
#                        if i in self.spherJointIds :
#                            ret = p.getJointStateMultiDof(self.linkage, i)
#                            dynamics = np.add(dynamics, np.array(ret[2])*mult)
#                        elif i in self.dumbJointIds :
#                            ret = p.getJointState(self.linkage, i)
#                            dynamics = np.add(dynamics, np.array(ret[2])*mult)
#                        
#                        # Applied force/torque
#                        applied = ret[3]
#                        
#                else :
#                    # Constraint
#                    dynamics = np.add(dynamics, np.array(p.getConstraintState(i*-1))*-1)
#        
#        # Applied torques/forces from actuator
#        if self.actJointControl == p.TORQUE_CONTROL and linkId in self.actJointIds :
#            pass
#        
#        # Collisions
#        dynamics += self.GetLinkContactForces(linkId)
#        
#        # Gravity
#        dynamics[2] += self.GRAV_ACCELZ
#        
#        return dynamics
#
#    # Alternate form of link dynamics
#    def GetLinkAccel2(self, name) :
#        # check if given link name (link == joint)
#        if "link" in name :
#            name.replace("link", "joint", 1)
#
#        # check link exists
#        if "name" in self.jointDict :
#            # Get total forces/moments
#            info = self.GetLinkTotalDynamics(name)
#            # Mass and Inertial info
#            
#
#    # Get joint and constraint dynamics
#    # returns [Fx,Fy,Fz,Mx,My,Mz]
#    # TODO: may need to rotate to match world frame orientation
#    def GetJointDynamics(self, name) :
#        # Determine if constraint or joint
#        state = []
#        if "joint" in name :
#            ret = p.getJointState(self.jointDict[name])
#            state = ret[2]
#        elif "constraint" in name :
#            state = p.getConstraintState(self.constraintDict[name]).tolist()
#            state.extend([0]*(self.DYN_STATE_SIZE-len(state)))
#        else: 
#            logging.error("Unknown name input to GetJointDynamics")
#        
#        return state
#    
#    # Print joint states
#    def PrintJointDynamics(self) :
#        logging.info("Joint States")
#        id_list = list(range(p.getNumJoints(self.linkage)))
#        ret = p.getJointStates(self.linkage, id_list)
#        idx = 0
#        for state in ret :
#            if(len(state) == 4) :
#                logging.debug("Id=%d velo=%s rxn=%s applied=%s", idx, str(state[1]), str(state[2]), str(state[3]))
#            elif(len(state) == 3) :
#                logging.debug("Id=%d velo=%s rxn=%s", idx, str(state[1]), str(state[2]))
#            else :
#                logging.error("Unexpected return list length %d", len(state))
#            idx += 1
#        print()
#        print()
