tomwym/oreo_mpc/(commit log)

2020-01-08 Add the tml_lib_light library which will be the basis for communication with the motor controller. This is the basic one which will need to be modified to utilize CAN sockets.
2020-01-14 Adding the socketcan interface for communication and the (slightly) modified TML_Lib_light for formatting CAN packets
2020-01-17 Re-designed TML_lib_light to allow for separate tx and rx threads and add some commands used by controller
2020-01-21 Updated filtering of sockets to align with the way TML CAN messages are organied
2020-01-27 Add filtering mechanism to lib, add ability to flush recv buf of socket
2020-01-27 Integrated TML_CAN_lib and socketcan into the macaque lib, resolved compilation errors, now fully in testing stage
    [macaque_linux.c, macaque_linux.h]
2020-02-05 Add files via upload
    A trial urdf modelling a four bar linkage
    [four_bar_link.urdf]
2020-02-05 Created a parseable four-bar linkage with inertial properties inputted
    [four_bar_link.urdf]
2020-02-13 Initial commit of all urdf and pybullet progress made towards developing oreo
    [assembly.urdf, base.urdf, dogbone.STL, dogbone.urdf, four_bar_link.urdf, left_eye.urdf, left_eye_yolk.urdf, linear_motor_rod.urdf]
2020-02-14 Simplified stl files to allow for use of Pybullet's native renderer. Added use of symbolic links which link to central folder holding all stl files.
    [dogbone.STL, linear_motor_rod_assembly.STL]
2020-02-14 Fix incorrect joint coordinates for left and right eyes
    [assembly.urdf]
2020-02-14 Moved to separate folder
    [four_bar_link.urdf]
2020-02-14 Create folder to house the simulation of robot in pybullet
    [assembly.urdf]
2020-02-14 Added center of mass origins to URDF model. Begin trying to use constraints to close the loop
    [assembly.urdf]
2020-02-14 python script to convert urdf form into btRigidBody
2020-02-19 Initial working copy simulating oreo robot in pybullet (omits roll movement of head, and missing some constraints in the eye/yolk asm)
    [assembly.urdf, assembly_temp.urdf]
2020-02-19 remove unneeded file
    [assembly_temp.urdf]
2020-02-20 Added roll movement of skull assembly
    [assembly.urdf]
2020-02-25 Oreo class which encapsulates the functionality of oreo robot. Currently has torque control and manual (position) control
2020-02-25 Re-purposing assembly.py as a test bed for new features to add to Oreo class
2020-02-25 pushing last changes to four bar link. No more dev will be added
    [four_bar_link.urdf]
2020-02-27 started adding some functionality to get the dynamics info of the currently running simulation
2020-03-05 Add socket module for sending RS232 messages to robot. Mimics cansock. No testing done yet
2020-03-05 Adding module to format motor messages in RS232 format. Testing and validation on RPI done (except for PING/PONG messages)
2020-04-07 adding test applications; resolving bugs within the startup and rx/tx threads
    [macaque_linux.c, macaque_linux.h]
2020-04-10 performed testing on receiving motor cmds and updating eyeData and neckData with corresponding changes as needed
2020-04-13 Initial commit of control files to perform position pid with torque output
2020-04-14 Changing eye motor names to more accurately represent the geometry of robot
2020-04-28 Initial commit of applications used to perform pid tuning
2020-04-28 Modifications to pid module to fix up intergral limits, and rearrange some of the pid loop structs
    [pid.c, pid.h]
2020-04-28 Adding some new functionality to the lib (reset faults) and adding some new registers to the header files
    [TML_RS232_def.h, TML_RS232_lib.c, TML_RS232_lib.h]
2020-04-28 Many changes based on testing on robot. Adding ability to change some motion control parameters as broadcast or per-axis. Adding some new types of messages recvd from robot. Adding a homing posn prio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
    [macaque_linux.c, macaque_linux.h]
2020-04-28 Modifications to posn pid control application. Designed separate pid control algorithm for eyes (both axes of an eye are linearly coupled). Added ability to load a position trajectory for each axis. 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
2020-04-29 Made modifications of the GOTO locations; added limits to force/torque/posn for pid control
2021-11-07 added mpc work, cleaned up repo
    [assembly.urdf, four_bar_link.urdf]
2021-11-08 added all geometry dir to dedicated dir
    [base.urdf, dogbone.urdf, left_eye.urdf, left_eye_yolk.urdf, linear_motor_rod.urdf, neck.urdf, pitch_piece.urdf, right_eye.urdf]
2021-12-12 removed /oreo
    [Neck_asm.STL, assembly.urdf, base.urdf, dogbone.STL, dogbone.urdf, left_eye.urdf, left_eye_asm.STL, left_eye_yolk.urdf]
